CascoLogix/KiCAD_Libraries/Templates/README.txt

There are two image files that should be located in the 'meta' folder under the actual board template folder.  These images need to be named "brd.png" and "icon.png".  

They need to also be specific sizes:
brd.png should be 640x480 pixels
icon.png should be 64x64 pixels
