CascoLogix/KiCAD_Libraries/3D/ICs/VSON/CAD/README.txt

Place CAD source files here.  These would be design files from CAD programs such as FreeCAD, Solidworks, etc.
