CascoLogix/KiCAD_Libraries/3D/ICs/VSON/Wings3D/README.txt

Place Wings3D files here (Note: these are *.wings file extensions).
