CascoLogix/KiCAD_Libraries/Templates/XBee/meta/brd.png

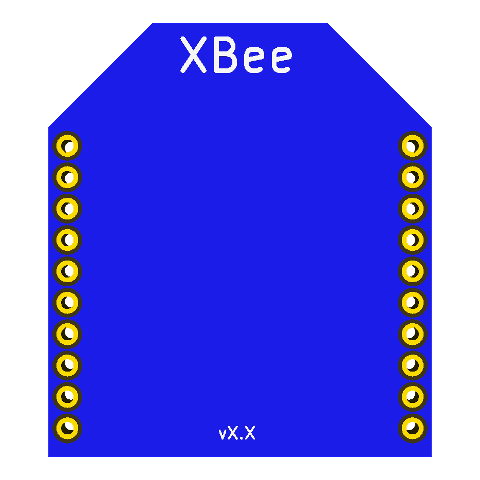
Templates/XBee/meta/brd.png
