CascoLogix/KiCAD_Libraries/Templates/XBee/XBee_Info/XBee_Standard_Pinout.PNG

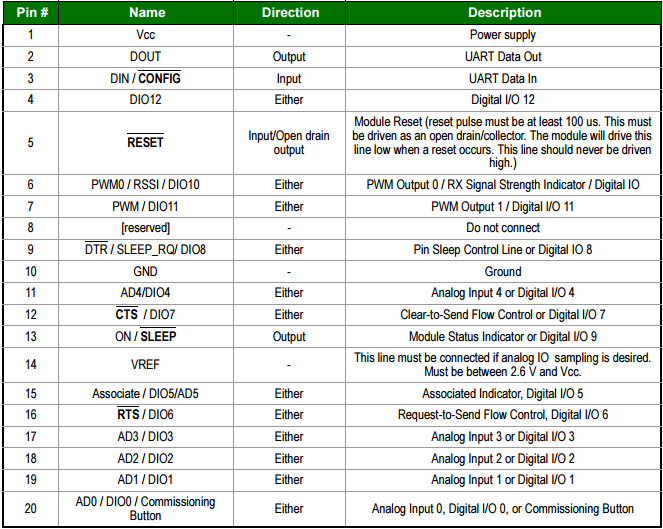
Templates/XBee/XBee_Info/XBee_Standard_Pinout.PNG
