CascoLogix/KiCAD_Libraries/Templates/XBee_Pro/meta/brd.png

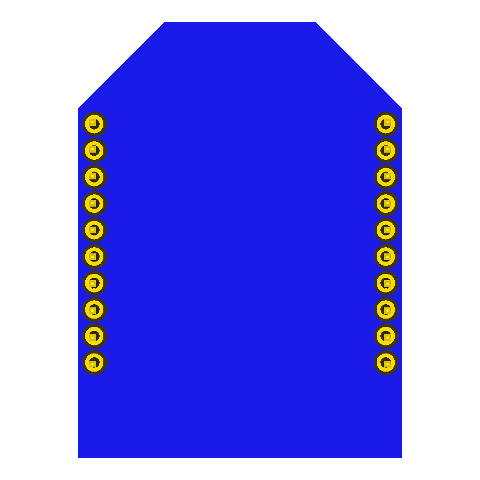
Templates/XBee_Pro/meta/brd.png
