CascoLogix/KiCAD_Libraries/PCB/Potentiometer_Library_Component_Names.xlsx

PCB Footprint Name | Component Prefix | Series Name | Mounting Type
POT_PV36P_PTH | POT | PV36P | PTH
POT_PV36W_PTH | POT | PV36W | PTH
POT_PV36X_PTH | POT | PV36X | PTH
POT_PV36Y_PTH | POT | PV36Y | PTH
POT_PV36Z_PTH | POT | PV36Z | PTH
POT_3296P_PTH | POT | 3296P | PTH
POT_3296W_PTH | POT | 3296W | PTH
POT_3296X_PTH | POT | 3296X | PTH
POT_3296Y_PTH | POT | 3296Y | PTH
POT_3296Z_PTH | POT | 3296Z | PTH
POT_3361P_SMT | POT | 3361P | SMT
POT_3361S_SMT | POT | 3361S | SMT
POT_3269P_SMT | POT | 3269P | SMT
POT_3269W_SMT | POT | 3269W | SMT
POT_3269X_SMT | POT | 3269X | SMT
