CascoLogix/KiCAD_Libraries/PCB/Resistor_Library_Component_Names.xlsx

PCB Footprint Name | Component Prefix | PTH Lead Spacing |  | Body Length |  | Body Diameter |  | Orientation | Mounting Type
RES_5.08MM_9MM_3MM_VERT_PTH | RES | 5.08 | MM | 9 | MM | 3 | MM | VERT | PTH | 1/2-Watt
RES_12.7MM_9MM_3MM_HORZ_PTH | RES | 12.7 | MM | 9 | MM | 3 | MM | HORZ | PTH | 1/2-Watt
RES_3.8MM_3.4MM_1.9MM_VERT_PTH | RES | 3.8 | MM | 3.4 | MM | 1.9 | MM | VERT | PTH | 1/4-Watt
RES_10.2MM_3.4MM_1.9MM_HORZ_PTH | RES | 10.2 | MM | 3.4 | MM | 1.9 | MM | HORZ | PTH | 1/4-Watt
RES_0201_SMT
RES_0402_SMT
RES_0603_SMT
RES_0805_SMT
RES_1206_SMT
RES_2512_SMT
