CascoLogix/KiCAD_Libraries/PCB/IC_Library_Component_Names.xlsx

Wings 3D Component Name | Package Type | Pin Count
QFN-12 | QFN | 12
QFN-16 | QFN | 16
QFN-20 | QFN | 20
QFN-24 | QFN | 24
QFN-28 | QFN | 28
QFN-32 | QFN | 32
QFN-44 | QFN | 44
QFN-48 | QFN | 48
TQFP-16 | TQFP | 16
TQFP-20 | TQFP | 20
TQFP-24 | TQFP | 24
TQFP-32 | TQFP | 32
TQFP-44 | TQFP | 44
TQFP-48 | TQFP | 48
TQFP-64 | TQFP | 64
TQFP-100 | TQFP | 100
TQFP-144 | TQFP | 144
DFN-6 | DFN | 6
DFN-8 | DFN | 8
SOIC-4 | SOIC | 4
SOIC-6 | SOIC | 6
SOIC-8 | SOIC | 8
SOIC-14 | SOIC | 14
SOIC-16 | SOIC | 16
SOIC-18 | SOIC | 18
SOIC-20 | SOIC | 20
SOIC-24 | SOIC | 24
SOIC-28 | SOIC | 28
DIP-6 | DIP | 6
DIP-8 | DIP | 8
DIP-4 | DIP | 4
DIP-6 | DIP | 6
DIP-8 | DIP | 8
DIP-14 | DIP | 14
DIP-16 | DIP | 16
DIP-18 | DIP | 18
DIP-20 | DIP | 20
DIP-24 | DIP | 24
DIP-28 | DIP | 28
SOT-23-3 | SOT-23 | 3
SOT-23-5 | SOT-23 | 5
SOT-23-6 | SOT-23 | 6
SOT-23-8 | SOT-23 | 8
SOIC-W-4 | SOIC-W | 4
SOIC-W-6 | SOIC-W | 6
SOIC-W-8 | SOIC-W | 8
SOIC-W-14 | SOIC-W | 14
SOIC-W-16 | SOIC-W | 16
SOIC-W-18 | SOIC-W | 18
SOIC-W-20 | SOIC-W | 20
SOIC-W-24 | SOIC-W | 24
SOIC-W-28 | SOIC-W | 28
DIP-W-4 | DIP-W | 4
DIP-W-6 | DIP-W | 6
DIP-W-8 | DIP-W | 8
DIP-W-14 | DIP-W | 14
DIP-W-16 | DIP-W | 16
DIP-W-18 | DIP-W | 18
DIP-W-20 | DIP-W | 20
DIP-W-24 | DIP-W | 24
DIP-W-28 | DIP-W | 28
SOP-8 | SOP | 8
SOP-14 | SOP | 14
SOP-16 | SOP | 16
SOP-18 | SOP | 18
SOP-20 | SOP | 20
SOP-24 | SOP | 24
SOP-28 | SOP | 28
SOP-32 | SOP | 32
SOP-40 | SOP | 40
SOP-44 | SOP | 44
SOP-48 | SOP | 48
SOP-64 | SOP | 64
MSOP-8 | MSOP | 8
MSOP-14 | MSOP | 14
MSOP-16 | MSOP | 16
MSOP-18 | MSOP | 18
MSOP-20 | MSOP | 20
MSOP-24 | MSOP | 24
MSOP-28 | MSOP | 28
MSOP-32 | MSOP | 32
TSSOP-8 | TSSOP | 8
TSSOP-14 | TSSOP | 14
TSSOP-16 | TSSOP | 16
TSSOP-18 | TSSOP | 18
TSSOP-20 | TSSOP | 20
TSSOP-24 | TSSOP | 24
TSSOP-28 | TSSOP | 28
TSSOP-32 | TSSOP | 32
TSSOP-40 | TSSOP | 40
TSSOP-44 | TSSOP | 44
TSSOP-48 | TSSOP | 48
TSSOP-64 | TSSOP | 64
