CascoLogix/KiCAD_Libraries/PCB/Header_Library_Component_Names.xlsx

PCB Footprint Name | Component Prefix | Gender | Pitch |  | Rows | Positions | Orientation | Plating | Mounting Type
HEADER_F_2.54MM_1R1P_ST_AU_SMT | HEADER | FEMALE | 2.54 | MM | 1 | 1 | ST | AU | SMT
HEADER_M_2.54MM_1R1P_ST_AU_SMT | HEADER | MALE | 2.54 | MM | 1 | 1 | ST | AU | SMT
HEADER_F_2.54MM_1R1P_ST_AU_PTH | HEADER | FEMALE | 2.54 | MM | 1 | 1 | ST | AU | PTH
HEADER_M_2.54MM_1R1P_ST_AU_PTH | HEADER | MALE | 2.54 | MM | 1 | 1 | ST | AU | PTH
HEADER_F_2.54MM_1R1P_RA_AU_SMT | HEADER | FEMALE | 2.54 | MM | 1 | 1 | RA | AU | SMT
HEADER_M_2.54MM_1R1P_RA_AU_SMT | HEADER | MALE | 2.54 | MM | 1 | 1 | RA | AU | SMT
HEADER_F_2.54MM_1R1P_RA_AU_PTH | HEADER | FEMALE | 2.54 | MM | 1 | 1 | RA | AU | PTH
HEADER_M_2.54MM_1R1P_RA_AU_PTH | HEADER | MALE | 2.54 | MM | 1 | 1 | RA | AU | PTH
HEADER_F_2.54MM_1R1P_ST_SN_SMT | HEADER | FEMALE | 2.54 | MM | 1 | 1 | ST | SN | SMT
HEADER_M_2.54MM_1R1P_ST_SN_SMT | HEADER | MALE | 2.54 | MM | 1 | 1 | ST | SN | SMT
HEADER_F_2.54MM_1R1P_ST_SN_PTH | HEADER | FEMALE | 2.54 | MM | 1 | 1 | ST | SN | PTH
HEADER_M_2.54MM_1R1P_ST_SN_PTH | HEADER | MALE | 2.54 | MM | 1 | 1 | ST | SN | PTH
HEADER_F_2.54MM_1R1P_RA_SN_SMT | HEADER | FEMALE | 2.54 | MM | 1 | 1 | RA | SN | SMT
HEADER_M_2.54MM_1R1P_RA_SN_SMT | HEADER | MALE | 2.54 | MM | 1 | 1 | RA | SN | SMT
HEADER_F_2.54MM_1R1P_RA_SN_PTH | HEADER | FEMALE | 2.54 | MM | 1 | 1 | RA | SN | PTH
HEADER_M_2.54MM_1R1P_RA_SN_PTH | HEADER | MALE | 2.54 | MM | 1 | 1 | RA | SN | PTH
HEADER_F_2.54MM_1R2P_ST_AU_SMT | HEADER | FEMALE | 2.54 | MM | 1 | 2 | ST | AU | SMT
HEADER_M_2.54MM_1R2P_ST_AU_SMT | HEADER | MALE | 2.54 | MM | 1 | 2 | ST | AU | SMT
HEADER_F_2.54MM_1R2P_ST_AU_PTH | HEADER | FEMALE | 2.54 | MM | 1 | 2 | ST | AU | PTH
HEADER_M_2.54MM_1R2P_ST_AU_PTH | HEADER | MALE | 2.54 | MM | 1 | 2 | ST | AU | PTH
HEADER_F_2.54MM_1R2P_RA_AU_SMT | HEADER | FEMALE | 2.54 | MM | 1 | 2 | RA | AU | SMT
HEADER_M_2.54MM_1R2P_RA_AU_SMT | HEADER | MALE | 2.54 | MM | 1 | 2 | RA | AU | SMT
HEADER_F_2.54MM_1R2P_RA_AU_PTH | HEADER | FEMALE | 2.54 | MM | 1 | 2 | RA | AU | PTH
HEADER_M_2.54MM_1R2P_RA_AU_PTH | HEADER | MALE | 2.54 | MM | 1 | 2 | RA | AU | PTH
HEADER_F_2.54MM_1R2P_ST_SN_SMT | HEADER | FEMALE | 2.54 | MM | 1 | 2 | ST | SN | SMT
HEADER_M_2.54MM_1R2P_ST_SN_SMT | HEADER | MALE | 2.54 | MM | 1 | 2 | ST | SN | SMT
HEADER_F_2.54MM_1R2P_ST_SN_PTH | HEADER | FEMALE | 2.54 | MM | 1 | 2 | ST | SN | PTH
HEADER_M_2.54MM_1R2P_ST_SN_PTH | HEADER | MALE | 2.54 | MM | 1 | 2 | ST | SN | PTH
HEADER_F_2.54MM_1R2P_RA_SN_SMT | HEADER | FEMALE | 2.54 | MM | 1 | 2 | RA | SN | SMT
HEADER_M_2.54MM_1R2P_RA_SN_SMT | HEADER | MALE | 2.54 | MM | 1 | 2 | RA | SN | SMT
HEADER_F_2.54MM_1R2P_RA_SN_PTH | HEADER | FEMALE | 2.54 | MM | 1 | 2 | RA | SN | PTH
HEADER_M_2.54MM_1R2P_RA_SN_PTH | HEADER | MALE | 2.54 | MM | 1 | 2 | RA | SN | PTH
HEADER_F_2.54MM_1R3P_ST_AU_SMT | HEADER | FEMALE | 2.54 | MM | 1 | 3 | ST | AU | SMT
HEADER_M_2.54MM_1R3P_ST_AU_SMT | HEADER | MALE | 2.54 | MM | 1 | 3 | ST | AU | SMT
HEADER_F_2.54MM_1R3P_ST_AU_PTH | HEADER | FEMALE | 2.54 | MM | 1 | 3 | ST | AU | PTH
HEADER_M_2.54MM_1R3P_ST_AU_PTH | HEADER | MALE | 2.54 | MM | 1 | 3 | ST | AU | PTH
HEADER_F_2.54MM_1R3P_RA_AU_SMT | HEADER | FEMALE | 2.54 | MM | 1 | 3 | RA | AU | SMT
HEADER_M_2.54MM_1R3P_RA_AU_SMT | HEADER | MALE | 2.54 | MM | 1 | 3 | RA | AU | SMT
HEADER_F_2.54MM_1R3P_RA_AU_PTH | HEADER | FEMALE | 2.54 | MM | 1 | 3 | RA | AU | PTH
HEADER_M_2.54MM_1R3P_RA_AU_PTH | HEADER | MALE | 2.54 | MM | 1 | 3 | RA | AU | PTH
HEADER_F_2.54MM_1R3P_ST_SN_SMT | HEADER | FEMALE | 2.54 | MM | 1 | 3 | ST | SN | SMT
HEADER_M_2.54MM_1R3P_ST_SN_SMT | HEADER | MALE | 2.54 | MM | 1 | 3 | ST | SN | SMT
HEADER_F_2.54MM_1R3P_ST_SN_PTH | HEADER | FEMALE | 2.54 | MM | 1 | 3 | ST | SN | PTH
HEADER_M_2.54MM_1R3P_ST_SN_PTH | HEADER | MALE | 2.54 | MM | 1 | 3 | ST | SN | PTH
HEADER_F_2.54MM_1R3P_RA_SN_SMT | HEADER | FEMALE | 2.54 | MM | 1 | 3 | RA | SN | SMT
HEADER_M_2.54MM_1R3P_RA_SN_SMT | HEADER | MALE | 2.54 | MM | 1 | 3 | RA | SN | SMT
HEADER_F_2.54MM_1R3P_RA_SN_PTH | HEADER | FEMALE | 2.54 | MM | 1 | 3 | RA | SN | PTH
HEADER_M_2.54MM_1R3P_RA_SN_PTH | HEADER | MALE | 2.54 | MM | 1 | 3 | RA | SN | PTH
HEADER_F_2.54MM_1R4P_ST_AU_SMT | HEADER | FEMALE | 2.54 | MM | 1 | 4 | ST | AU | SMT
HEADER_M_2.54MM_1R4P_ST_AU_SMT | HEADER | MALE | 2.54 | MM | 1 | 4 | ST | AU | SMT
HEADER_F_2.54MM_1R4P_ST_AU_PTH | HEADER | FEMALE | 2.54 | MM | 1 | 4 | ST | AU | PTH
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
HEADER_F_2.54MM_2R72P_RA_AU_PTH | HEADER | FEMALE | 2.54 | MM | 2 | 72 | RA | AU | PTH
HEADER_M_2.54MM_2R72P_RA_AU_PTH | HEADER | MALE | 2.54 | MM | 2 | 72 | RA | AU | PTH
HEADER_F_2.54MM_2R72P_ST_SN_SMT | HEADER | FEMALE | 2.54 | MM | 2 | 72 | ST | SN | SMT
HEADER_M_2.54MM_2R72P_ST_SN_SMT | HEADER | MALE | 2.54 | MM | 2 | 72 | ST | SN | SMT
HEADER_F_2.54MM_2R72P_ST_SN_PTH | HEADER | FEMALE | 2.54 | MM | 2 | 72 | ST | SN | PTH
HEADER_M_2.54MM_2R72P_ST_SN_PTH | HEADER | MALE | 2.54 | MM | 2 | 72 | ST | SN | PTH
HEADER_F_2.54MM_2R72P_RA_SN_SMT | HEADER | FEMALE | 2.54 | MM | 2 | 72 | RA | SN | SMT
HEADER_M_2.54MM_2R72P_RA_SN_SMT | HEADER | MALE | 2.54 | MM | 2 | 72 | RA | SN | SMT
HEADER_F_2.54MM_2R72P_RA_SN_PTH | HEADER | FEMALE | 2.54 | MM | 2 | 72 | RA | SN | PTH
HEADER_M_2.54MM_2R72P_RA_SN_PTH | HEADER | MALE | 2.54 | MM | 2 | 72 | RA | SN | PTH
