CascoLogix/KiCAD_Libraries/3D/Wings_3D_Library_Info.ods

Sheet: Library Names
Battery
Connector
Discrete
Display
Fuse
Header
IC
Potentiometer
Switch
Terminal Block
Test

Sheet: Discrete - Capacitor
Wings 3D Component Name | Component Type |  |  | Orientation | Formed Leads | Body Dia |  | Body Length |  | Lead Spacing |  | Lead Dia
0402
0603
0805
1206
CAP_E_AXI_200_500_400_20 | CAP | E | Electrolytic | AXIAL |  | 200 | MIL | 500 | MIL | 400 | MIL | 20 | MIL
CAP_T_RAD_200_500_200_20 | CAP | T | Tantalum | RADIAL |  | 200 | MIL | 500 | MIL | 200 | MIL | 20 | MIL
CAP_F_AXI_F_200_500_200_20 | CAP | F | Formica | AXIAL | FORMED | 200 | MIL | 500 | MIL | 200 | MIL | 20 | MIL
CAP_C_RAD_F_200_500_200_20 | CAP | C | Ceramic | RADIAL | FORMED | 200 | MIL | 500 | MIL | 200 | MIL | 20 | MIL
CAP_P_RAD_200_500_200_20 | CAP | P | Polyester | RADIAL |  | 200 | MIL | 500 | MIL | 200 | MIL | 20 | MIL

Sheet: Discrete - Resistor
Wings 3D Component Name | Component Type |  |  | Orientation | Formed Leads | Body Dia |  | Body Height |  | Lead Spacing |  | Lead Dia
0402
0603
0805
1206
RES_CC_AXI_200_500_400_20 | RES | CC | Carbon Composition | AXIAL |  | 200 | MIL | 500 | MIL | 400 | MIL | 20 | MIL
RES_MF_RAD_200_500_200_20 | RES | MF | Metal Film | RADIAL |  | 200 | MIL | 500 | MIL | 200 | MIL | 20 | MIL
RES_FL_AXI_F_200_500_200_20 | RES | FL | Foil | AXIAL | FORMED | 200 | MIL | 500 | MIL | 200 | MIL | 20 | MIL
RES_CF_RAD_F_200_500_200_20 | RES | CF | Carbon Film | RADIAL | FORMED | 200 | MIL | 500 | MIL | 200 | MIL | 20 | MIL
RES_WW_RAD_200_500_200_20 | RES | WW | Wirewound | RADIAL |  | 200 | MIL | 500 | MIL | 200 | MIL | 20 | MIL

Sheet: Discrete - Diode
Wings 3D Component Name | Component Type |  |  | Orientation | Formed Leads | Body Dia |  | Body Length |  | Lead Spacing |  | Lead Dia
 | DIODE | SMA
 | DIODE | SMB
 | DIODE | SMC
 | DIODE | MELF
DIODE_ZEN_AXI_200_500_400_20 | DIODE | ZEN | Zener | AXIAL |  | 200 | MIL | 500 | MIL | 400 | MIL | 20 | MIL
DIODE_UFS_AXI_200_500_200_20 | DIODE | UFS | Ultra Fast Recovery | AXIAL |  | 200 | MIL | 500 | MIL | 200 | MIL | 20 | MIL
DIODE_GAS_AXI_F_200_500_200_20 | DIODE | GAS | Gallium Arsenide | AXIAL | FORMED | 200 | MIL | 500 | MIL | 200 | MIL | 20 | MIL
DIODE_STD_AXI_F_200_500_200_20 | DIODE | STD | Standard Recovery | AXIAL | FORMED | 200 | MIL | 500 | MIL | 200 | MIL | 20 | MIL

Sheet: Header
Wings 3D Component Name | Component Type | Gender | Pitch |  | Rows | Positions | Mounting Type
HEADER_F_100MIL_1R01P_SMT | HEADER | FEMALE | 100 | MIL | 1 | 01 | SMT
HEADER_F_100MIL_1R02P_SMT | HEADER | FEMALE | 100 | MIL | 1 | 02 | SMT
HEADER_F_100MIL_1R03P_SMT | HEADER | FEMALE | 100 | MIL | 1 | 03 | SMT
HEADER_F_100MIL_1R04P_SMT | HEADER | FEMALE | 100 | MIL | 1 | 04 | SMT
HEADER_F_100MIL_1R05P_SMT | HEADER | FEMALE | 100 | MIL | 1 | 05 | SMT
HEADER_F_100MIL_1R06P_SMT | HEADER | FEMALE | 100 | MIL | 1 | 06 | SMT
HEADER_F_100MIL_1R07P_SMT | HEADER | FEMALE | 100 | MIL | 1 | 07 | SMT
HEADER_F_100MIL_1R08P_SMT | HEADER | FEMALE | 100 | MIL | 1 | 08 | SMT
HEADER_F_100MIL_1R09P_SMT | HEADER | FEMALE | 100 | MIL | 1 | 09 | SMT
HEADER_F_100MIL_1R10P_SMT | HEADER | FEMALE | 100 | MIL | 1 | 10 | SMT
HEADER_F_100MIL_1R11P_SMT | HEADER | FEMALE | 100 | MIL | 1 | 11 | SMT
HEADER_F_100MIL_1R12P_SMT | HEADER | FEMALE | 100 | MIL | 1 | 12 | SMT
HEADER_F_100MIL_1R13P_SMT | HEADER | FEMALE | 100 | MIL | 1 | 13 | SMT
HEADER_F_100MIL_1R14P_SMT | HEADER | FEMALE | 100 | MIL | 1 | 14 | SMT
HEADER_F_100MIL_1R15P_SMT | HEADER | FEMALE | 100 | MIL | 1 | 15 | SMT
HEADER_F_100MIL_1R16P_SMT | HEADER | FEMALE | 100 | MIL | 1 | 16 | SMT
HEADER_F_100MIL_1R17P_SMT | HEADER | FEMALE | 100 | MIL | 1 | 17 | SMT
HEADER_F_100MIL_1R18P_SMT | HEADER | FEMALE | 100 | MIL | 1 | 18 | SMT
HEADER_F_100MIL_1R19P_SMT | HEADER | FEMALE | 100 | MIL | 1 | 19 | SMT
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
HEADER_M_100MIL_2R24P_PTH | HEADER | MALE | 100 | MIL | 2 | 24 | PTH
HEADER_M_100MIL_2R25P_PTH | HEADER | MALE | 100 | MIL | 2 | 25 | PTH
HEADER_M_100MIL_2R26P_PTH | HEADER | MALE | 100 | MIL | 2 | 26 | PTH
HEADER_M_100MIL_2R27P_PTH | HEADER | MALE | 100 | MIL | 2 | 27 | PTH
HEADER_M_100MIL_2R28P_PTH | HEADER | MALE | 100 | MIL | 2 | 28 | PTH
HEADER_M_100MIL_2R29P_PTH | HEADER | MALE | 100 | MIL | 2 | 29 | PTH
HEADER_M_100MIL_2R30P_PTH | HEADER | MALE | 100 | MIL | 2 | 30 | PTH
HEADER_M_100MIL_2R31P_PTH | HEADER | MALE | 100 | MIL | 2 | 31 | PTH
HEADER_M_100MIL_2R32P_PTH | HEADER | MALE | 100 | MIL | 2 | 32 | PTH
HEADER_M_100MIL_2R33P_PTH | HEADER | MALE | 100 | MIL | 2 | 33 | PTH
HEADER_M_100MIL_2R34P_PTH | HEADER | MALE | 100 | MIL | 2 | 34 | PTH
HEADER_M_100MIL_2R35P_PTH | HEADER | MALE | 100 | MIL | 2 | 35 | PTH
HEADER_M_100MIL_2R36P_PTH | HEADER | MALE | 100 | MIL | 2 | 36 | PTH
HEADER_M_100MIL_2R37P_PTH | HEADER | MALE | 100 | MIL | 2 | 37 | PTH
HEADER_M_100MIL_2R38P_PTH | HEADER | MALE | 100 | MIL | 2 | 38 | PTH
HEADER_M_100MIL_2R39P_PTH | HEADER | MALE | 100 | MIL | 2 | 39 | PTH
HEADER_M_100MIL_2R40P_PTH | HEADER | MALE | 100 | MIL | 2 | 40 | PTH
HEADER_M_100MIL_2R41P_PTH | HEADER | MALE | 100 | MIL | 2 | 41 | PTH
HEADER_M_100MIL_2R42P_PTH | HEADER | MALE | 100 | MIL | 2 | 42 | PTH
HEADER_M_100MIL_2R43P_PTH | HEADER | MALE | 100 | MIL | 2 | 43 | PTH
HEADER_M_100MIL_2R44P_PTH | HEADER | MALE | 100 | MIL | 2 | 44 | PTH
HEADER_M_100MIL_2R45P_PTH | HEADER | MALE | 100 | MIL | 2 | 45 | PTH
HEADER_M_100MIL_2R46P_PTH | HEADER | MALE | 100 | MIL | 2 | 46 | PTH
HEADER_M_100MIL_2R47P_PTH | HEADER | MALE | 100 | MIL | 2 | 47 | PTH
HEADER_M_100MIL_2R48P_PTH | HEADER | MALE | 100 | MIL | 2 | 48 | PTH
HEADER_M_100MIL_2R49P_PTH | HEADER | MALE | 100 | MIL | 2 | 49 | PTH
HEADER_M_100MIL_2R50P_PTH | HEADER | MALE | 100 | MIL | 2 | 50 | PTH

Sheet: IC
Wings 3D Component Name | Package Type | Pin Count
QFN-12 | QFN | 12
QFN-16 | QFN | 16
QFN-20 | QFN | 20
QFN-24 | QFN | 24
QFN-28 | QFN | 28
QFN-32 | QFN | 32
QFN-44 | QFN | 44
QFN-48 | QFN | 48
TQFP-16 | TQFP | 16
TQFP-20 | TQFP | 20
TQFP-24 | TQFP | 24
TQFP-32 | TQFP | 32
TQFP-44 | TQFP | 44
TQFP-48 | TQFP | 48
TQFP-64 | TQFP | 64
TQFP-100 | TQFP | 100
TQFP-144 | TQFP | 144
DFN-6 | DFN | 6
DFN-8 | DFN | 8
SOIC-4 | SOIC | 4
SOIC-6 | SOIC | 6
SOIC-8 | SOIC | 8
SOIC-14 | SOIC | 14
SOIC-16 | SOIC | 16
SOIC-18 | SOIC | 18
SOIC-20 | SOIC | 20
SOIC-24 | SOIC | 24
SOIC-28 | SOIC | 28
DIP-6 | DIP | 6
DIP-8 | DIP | 8
DIP-4 | DIP | 4
DIP-6 | DIP | 6
DIP-8 | DIP | 8
DIP-14 | DIP | 14
DIP-16 | DIP | 16
DIP-18 | DIP | 18
DIP-20 | DIP | 20
DIP-24 | DIP | 24
DIP-28 | DIP | 28
SOT-23-3 | SOT-23 | 3
SOT-23-5 | SOT-23 | 5
SOT-23-6 | SOT-23 | 6
SOT-23-8 | SOT-23 | 8
SOIC-W-4 | SOIC-W | 4
SOIC-W-6 | SOIC-W | 6
SOIC-W-8 | SOIC-W | 8
SOIC-W-14 | SOIC-W | 14
SOIC-W-16 | SOIC-W | 16
SOIC-W-18 | SOIC-W | 18
SOIC-W-20 | SOIC-W | 20
SOIC-W-24 | SOIC-W | 24
SOIC-W-28 | SOIC-W | 28
DIP-W-4 | DIP-W | 4
DIP-W-6 | DIP-W | 6
DIP-W-8 | DIP-W | 8
DIP-W-14 | DIP-W | 14
DIP-W-16 | DIP-W | 16
DIP-W-18 | DIP-W | 18
DIP-W-20 | DIP-W | 20
DIP-W-24 | DIP-W | 24
DIP-W-28 | DIP-W | 28
SOP-8 | SOP | 8
SOP-14 | SOP | 14
SOP-16 | SOP | 16
SOP-18 | SOP | 18
SOP-20 | SOP | 20
SOP-24 | SOP | 24
SOP-28 | SOP | 28
SOP-32 | SOP | 32
SOP-40 | SOP | 40
SOP-44 | SOP | 44
SOP-48 | SOP | 48
SOP-64 | SOP | 64
MSOP-8 | MSOP | 8
MSOP-14 | MSOP | 14
MSOP-16 | MSOP | 16
MSOP-18 | MSOP | 18
MSOP-20 | MSOP | 20
MSOP-24 | MSOP | 24
MSOP-28 | MSOP | 28
MSOP-32 | MSOP | 32
TSSOP-8 | TSSOP | 8
TSSOP-14 | TSSOP | 14
TSSOP-16 | TSSOP | 16
TSSOP-18 | TSSOP | 18
TSSOP-20 | TSSOP | 20
TSSOP-24 | TSSOP | 24
TSSOP-28 | TSSOP | 28
TSSOP-32 | TSSOP | 32
TSSOP-40 | TSSOP | 40
TSSOP-44 | TSSOP | 44
TSSOP-48 | TSSOP | 48
TSSOP-64 | TSSOP | 64

Sheet: Switch
SW_ROCKER_ON-OFF-ON
SW_SLIDE_4POS
SW_TOGGLE_4P2T_ON-OFF-ON
SW_TOGGLE_1P1T_ON-OFF
SW_TOGGLE_2P2T_ON-ON
SW_TOGGLE_4P2T_ON-MOM
SW_PUSH_1P1T_OFF-MOM
SW_PUSH_1P1T_OFF-ON
