CascoLogix/KiCAD_Libraries/3D/Battery_Holders/CAD/BHC-2-Assy-wCell.SLDASM

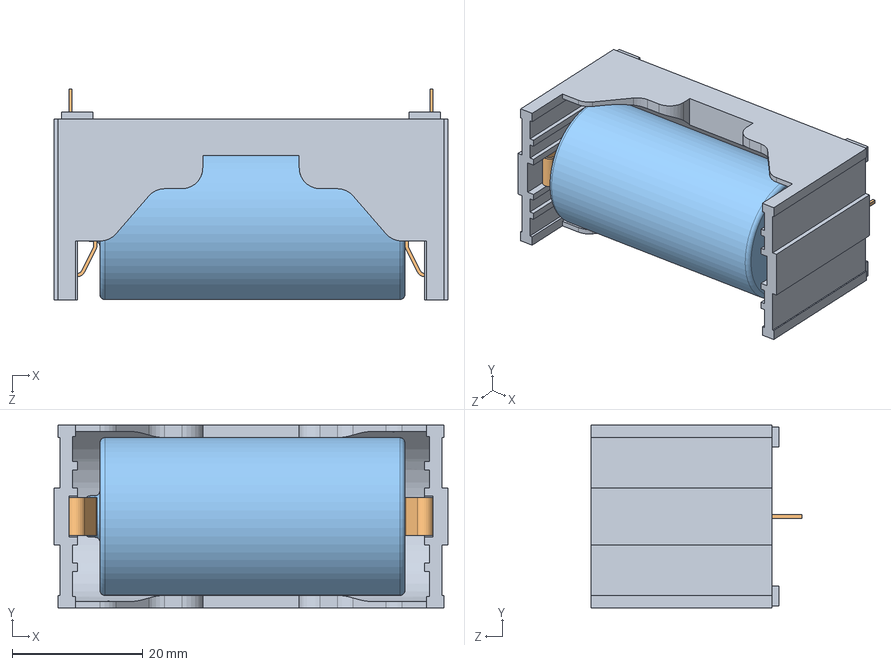
[picture p9: CAD file, 2016-09-24]
3D/Battery_Holders/CAD/BHC-2-Assy-wCell.SLDASM
60.2 x 27.9 x 32.3 mm
BHC-2-Base
BHC-2-Tab x 2
BHC-2-Cell
