CascoLogix/KiCAD_Libraries/3D/Connectors/Samtec/ERCD/CAD/ERCD-010-TED-S-2.SLDASM

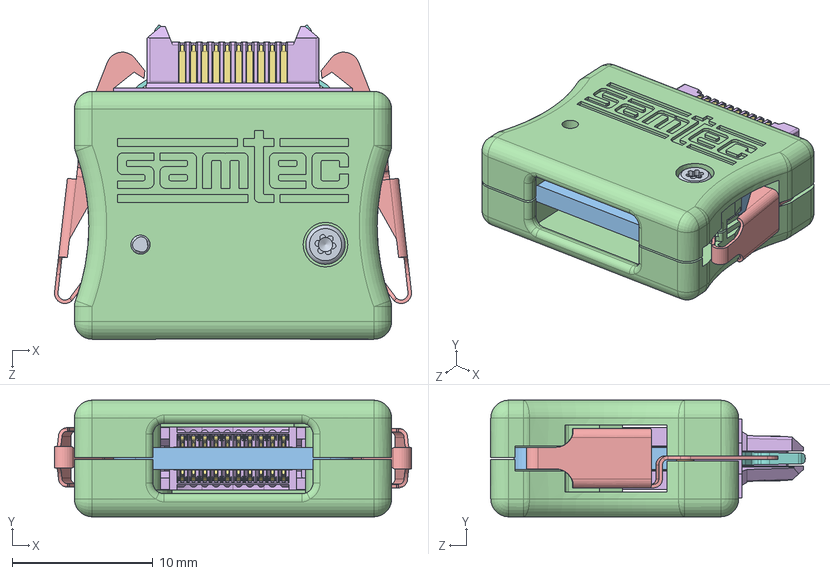
[picture p13: CAD file, 2013-10-21]
3D/Connectors/Samtec/ERCD/CAD/ERCD-010-TED-S-2.SLDASM
25.3 x 8.29 x 22.3 mm
STS-04 x 2
ERCD Dowel Pin x 2
ERCD PCB-EM_10 POS
ECD-XX-03_-10 x 2
LTC-16-01_DEFAULT x 2
ERCD ERM8-XXX-D-EMX-XX_20 position w_LATCHING
ERCD T-1M47-XX-X_.062 PCB x 20
WT-29-XX-X_-07 1.58 bd Smooth Latch x 2
