CascoLogix/KiCAD_Libraries/3D/Connectors/Samtec/ERCD/CAD/ERCD-010-TEU-S-1-R.SLDASM

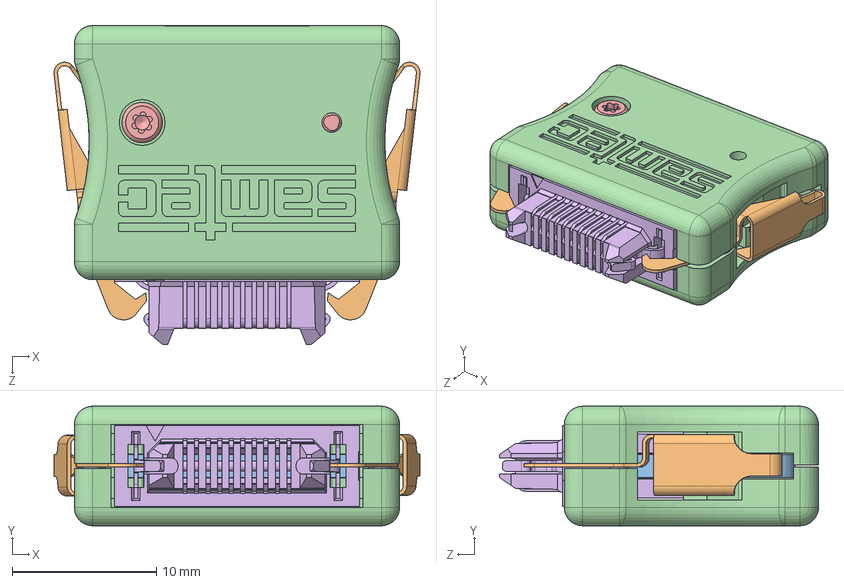
[picture p16: CAD file, 2013-10-21]
3D/Connectors/Samtec/ERCD/CAD/ERCD-010-TEU-S-1-R.SLDASM
25.3 x 8.29 x 22.1 mm
ERCD Dowel Pin_2 x 2
LTC-16-01_DEFAULT_2 x 2
ERCD PCB-EM_10 POS_2
ECD-XX-03_-10_2 x 2
STS-04_2 x 2
ERM8-EM_2
