CascoLogix/KiCAD_Libraries/3D/ICs/SOT/CAD/SOT-23-6-1.sldasm

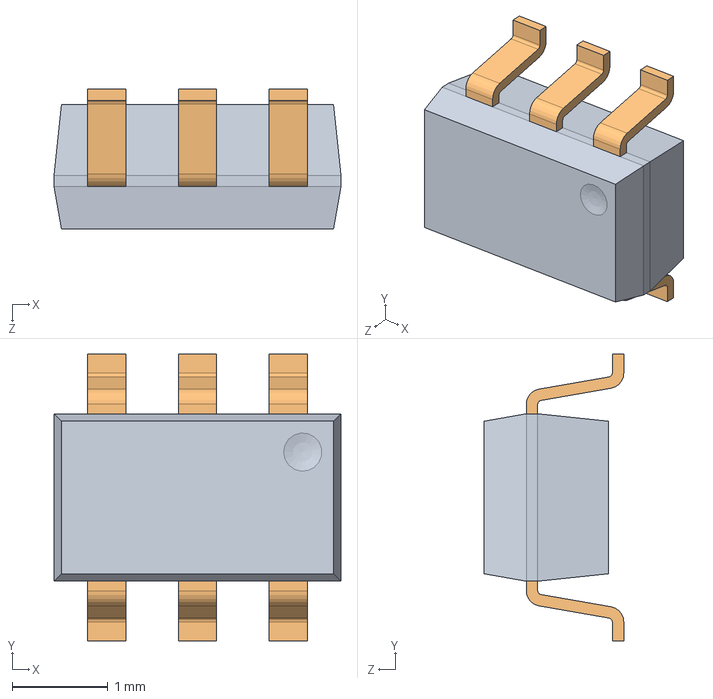
[picture p19: CAD file, 2014-12-09]
3D/ICs/SOT/CAD/SOT-23-6-1.sldasm
3.00 x 3.00 x 1.46 mm
User Library-SOT-23-6-1_body_sot23-6_1
User Library-SOT-23-6-1_pin_SOT_sot-23-6_1 x 6
