CascoLogix/KiCAD_Libraries/3D/ICs/SOT/CAD/SOT-23-1.sldasm

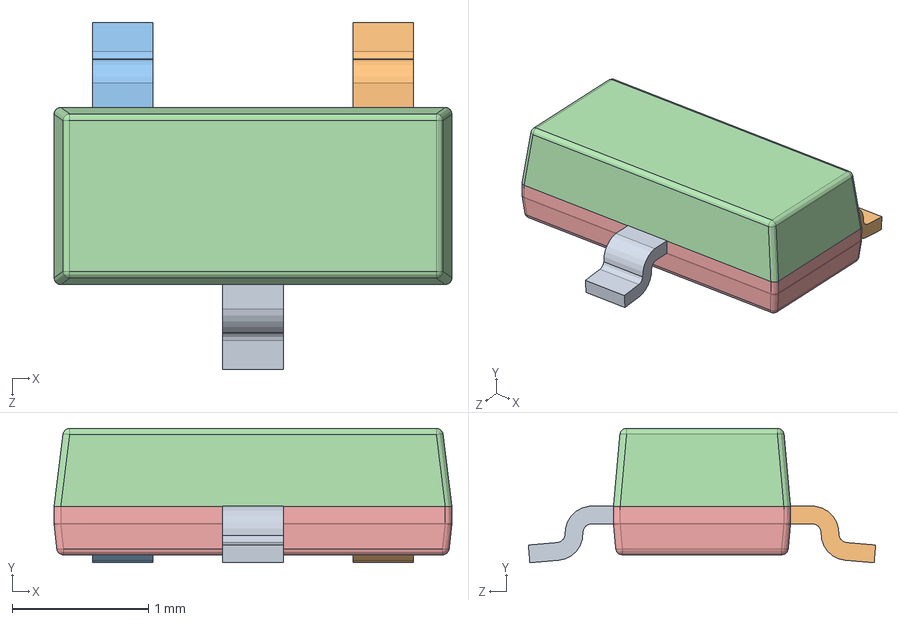
[picture p21: CAD file, 2013-10-21]
3D/ICs/SOT/CAD/SOT-23-1.sldasm
2.92 x 0.987 x 2.55 mm
User Library-SOT-23-1_1_1
User Library-SOT-23-1_2_1
User Library-SOT-23-1_3_1
User Library-SOT-23-1_4_1
User Library-SOT-23-1_5_1
