CascoLogix/KiCAD_Libraries/3D/Headers/CAD/HEADER_MALE_100MIL_1R7P_GOLD_PTH.SLDASM

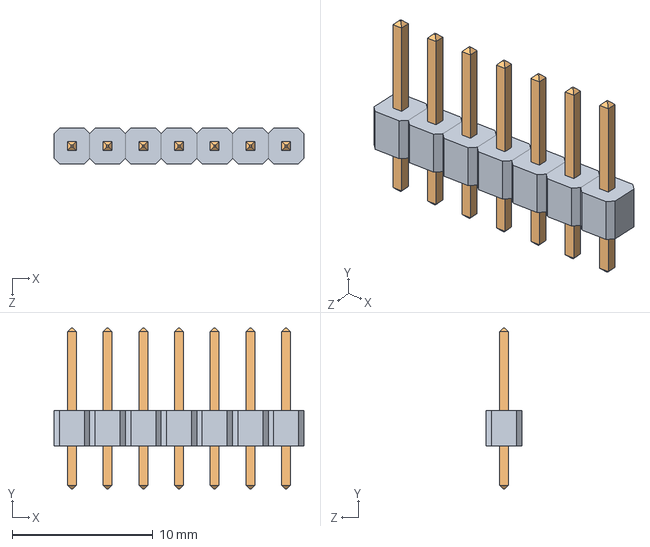
[picture p22: CAD file, 2013-10-21]
3D/Headers/CAD/HEADER_MALE_100MIL_1R7P_GOLD_PTH.SLDASM
17.8 x 11.4 x 2.54 mm
HEADER_MALE_100MIL_BODY_BLACK x 7
PIN_0.025SQ_0.230HEAD_0.120TAIL_GOLD x 7
