CascoLogix/KiCAD_Libraries/3D/Headers/CAD/HEADER_MALE_100MIL_1R2P_GOLD_PTH.SLDASM

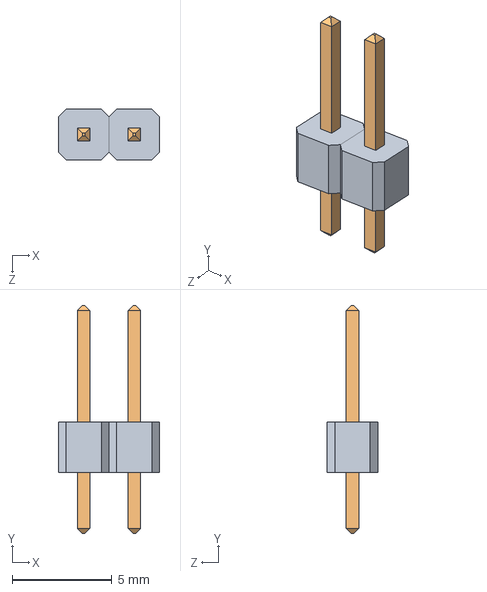
[picture p28: CAD file, 2013-10-21]
3D/Headers/CAD/HEADER_MALE_100MIL_1R2P_GOLD_PTH.SLDASM
5.08 x 11.4 x 2.54 mm
HEADER_MALE_100MIL_BODY_BLACK x 2
PIN_0.025SQ_0.230HEAD_0.120TAIL_GOLD x 2
