CascoLogix/KiCAD_Libraries/3D/Headers/CAD/HEADER_MALE_100MIL_2R6P_GOLD_PTH.SLDASM

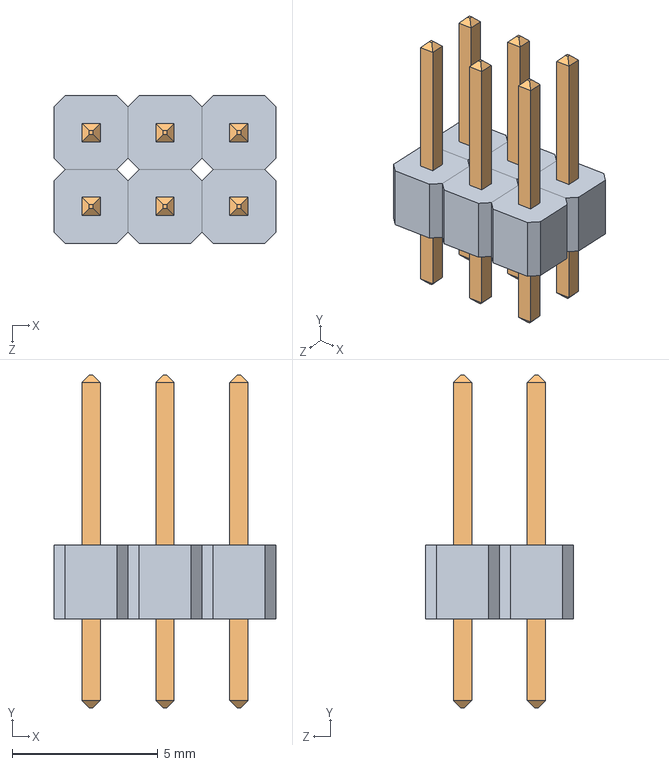
[picture p31: CAD file, 2013-10-21]
3D/Headers/CAD/HEADER_MALE_100MIL_2R6P_GOLD_PTH.SLDASM
7.62 x 11.4 x 5.08 mm
HEADER_MALE_100MIL_BODY_BLACK x 6
PIN_0.025SQ_0.230HEAD_0.120TAIL_GOLD x 6
