CascoLogix/KiCAD_Libraries/3D/Headers/CAD/HEADER_MALE_100MIL_2R8P_GOLD_PTH.SLDASM

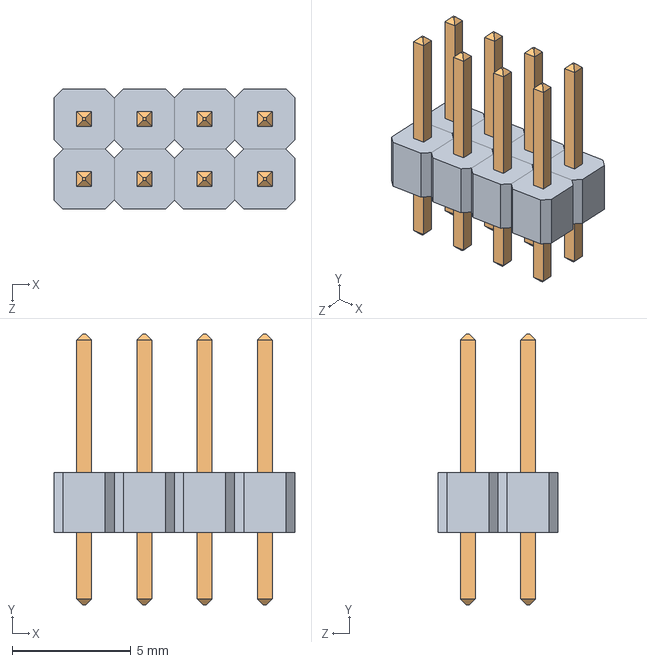
[picture p32: CAD file, 2013-10-21]
3D/Headers/CAD/HEADER_MALE_100MIL_2R8P_GOLD_PTH.SLDASM
10.2 x 11.4 x 5.08 mm
HEADER_MALE_100MIL_BODY_BLACK x 8
PIN_0.025SQ_0.230HEAD_0.120TAIL_GOLD x 8
