CascoLogix/KiCAD_Libraries/3D/Other_Mechanical/STEP/M12_Lens_Assy_2.step

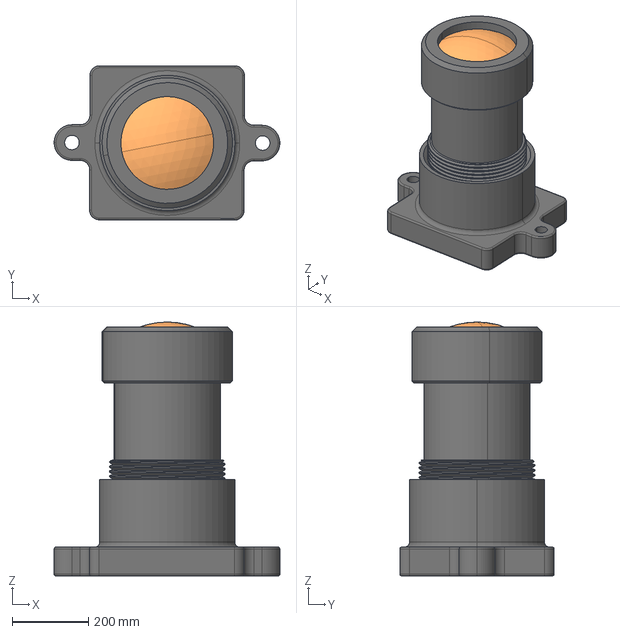
[picture p33: CAD file, 2018-07-14]
3D/Other_Mechanical/STEP/M12_Lens_Assy_2.step
593.7 x 406.2 x 668.0 mm
