CascoLogix/KiCAD_Libraries/3D/Batteries/CAD/CR1025 3V Cell.step

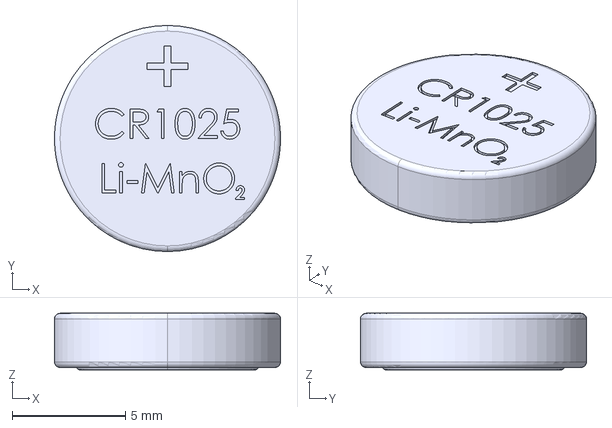
[picture p34: CAD file, 2020-03-22]
3D/Batteries/CAD/CR1025 3V Cell.step
10.00 x 10.0 x 2.50 mm
