CascoLogix/KiCAD_Libraries/3D/Battery_Holders/CAD/BHC-2-Tab.SLDPRT

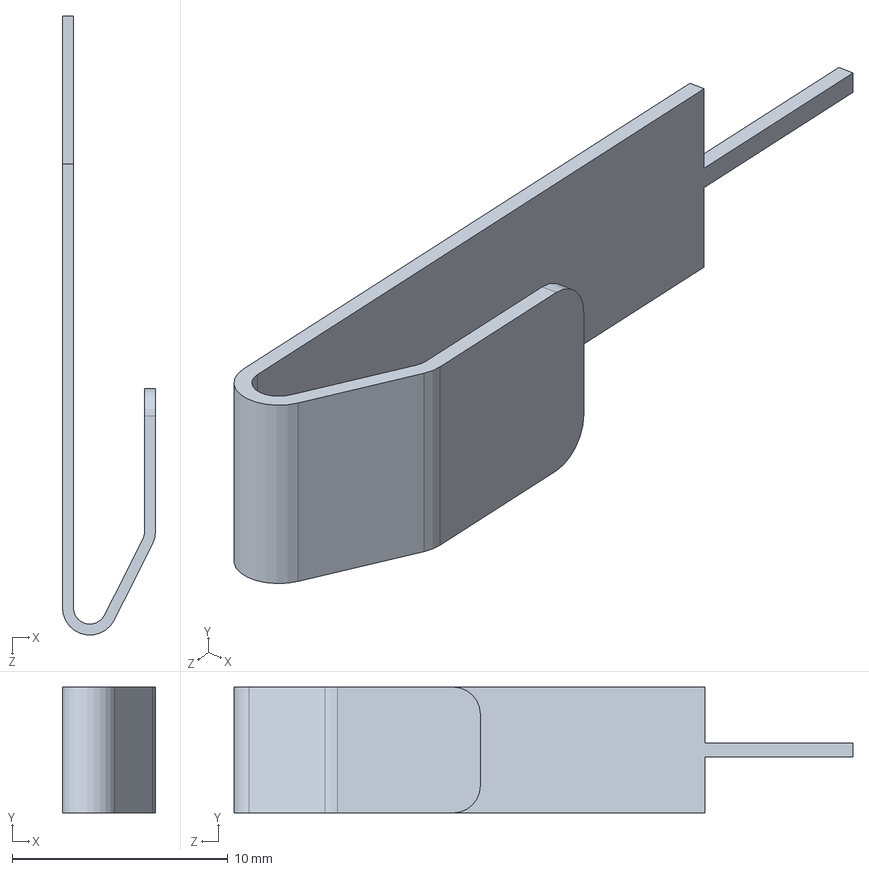
[picture p35: CAD file, 2016-09-24]
3D/Battery_Holders/CAD/BHC-2-Tab.SLDPRT
4.32 x 5.84 x 28.7 mm
