CascoLogix/KiCAD_Libraries/3D/Battery_Holders/STEP/keystone-PN3030.step

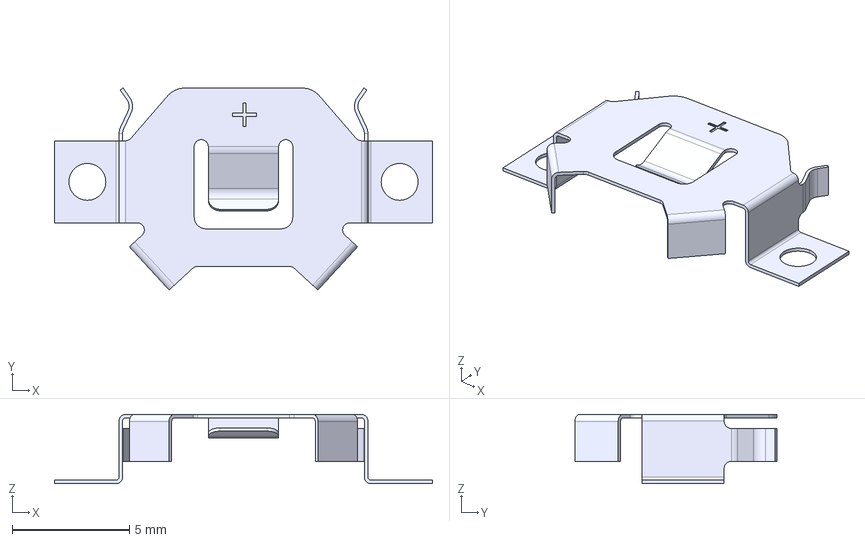
[picture p36: CAD file, 2020-03-16]
3D/Battery_Holders/STEP/keystone-PN3030.step
16.1 x 8.61 x 2.95 mm
