CascoLogix/KiCAD_Libraries/3D/Battery_Holders/STL/9V Duracell Battery.STL

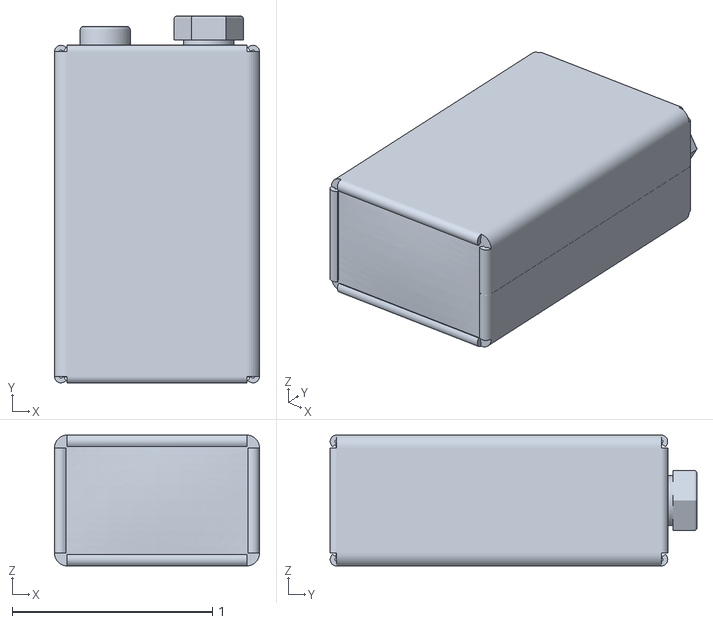
[picture p37: CAD file, 2016-01-23]
3D/Battery_Holders/STL/9V Duracell Battery.STL
1.02 x 1.83 x 0.654
