CascoLogix/KiCAD_Libraries/3D/Connectors/AVX/STEP/AVX_009155005003016.step

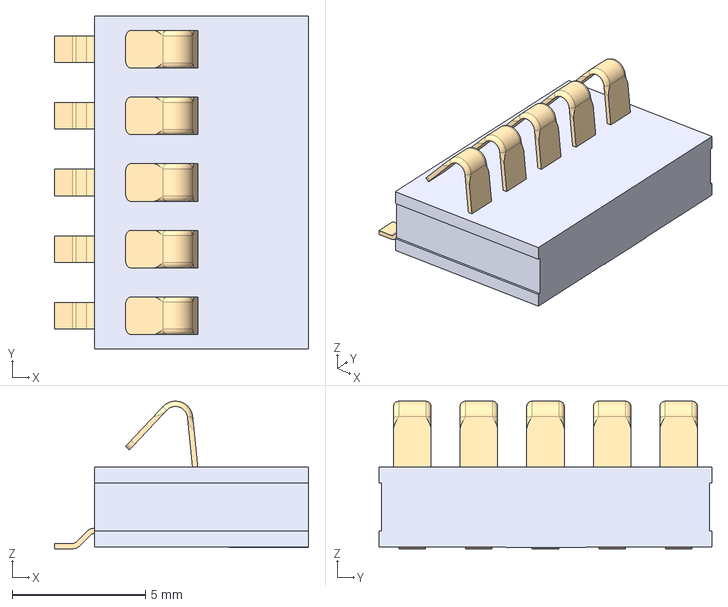
[picture p38: CAD file, 2018-05-26]
3D/Connectors/AVX/STEP/AVX_009155005003016.step
9.55 x 12.5 x 5.54 mm
