CascoLogix/KiCAD_Libraries/3D/Connectors/DB/CAD/CONNECTOR_DB9_RA_F_PTH_GENERIC.SLDPRT

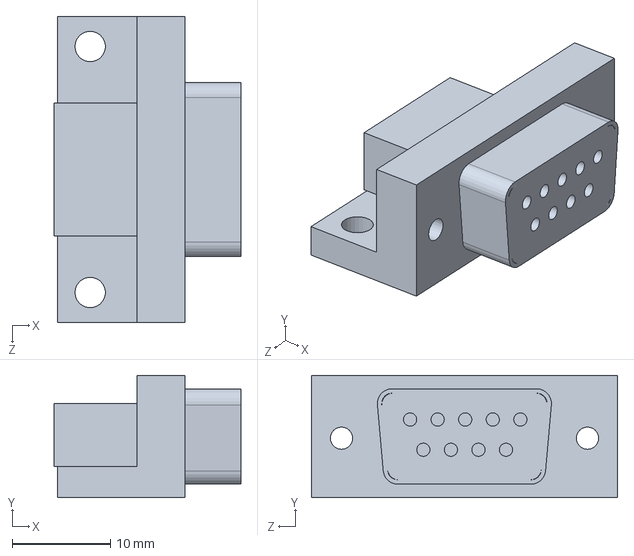
[picture p39: CAD file, 2013-10-21]
3D/Connectors/DB/CAD/CONNECTOR_DB9_RA_F_PTH_GENERIC.SLDPRT
19.0 x 12.4 x 31.1 mm
