CascoLogix/KiCAD_Libraries/3D/Connectors/DB/STL/CONNECTOR_DB9_RA_F_PTH_GENERIC2.STL

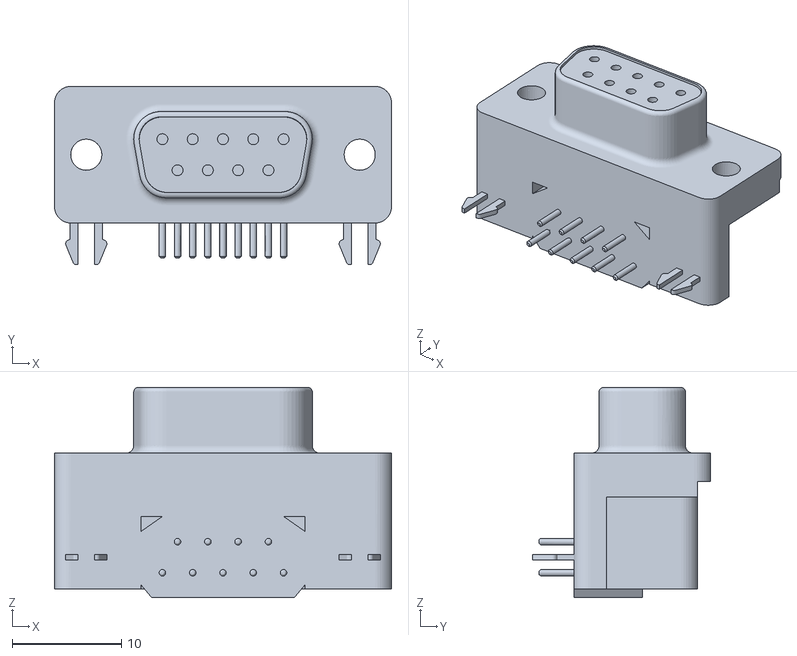
[picture p40: CAD file, 2013-10-21]
3D/Connectors/DB/STL/CONNECTOR_DB9_RA_F_PTH_GENERIC2.STL
30.8 x 16.3 x 19.2
