CascoLogix/KiCAD_Libraries/3D/Connectors/FFC/STEP/Molex_526100571_1R5P_1.0MM_VERT.stp

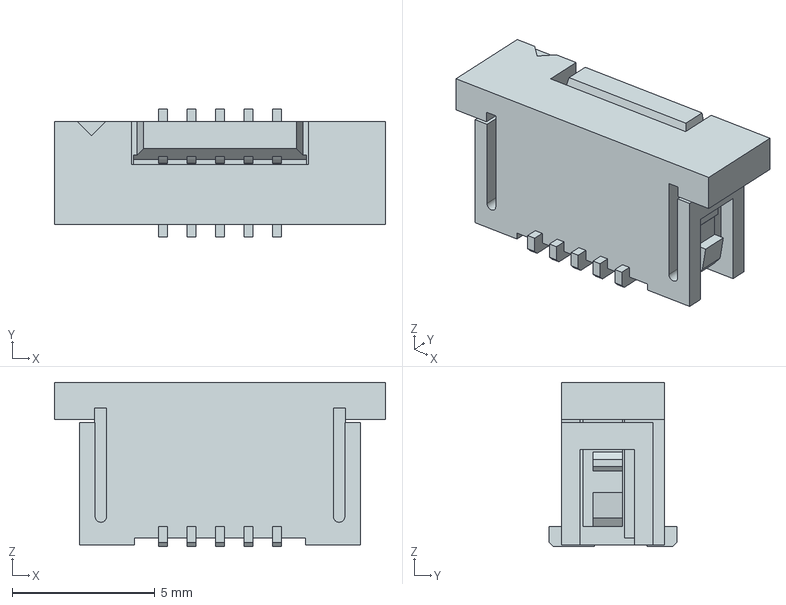
[picture p41: CAD file, 2026-10-30]
3D/Connectors/FFC/STEP/Molex_526100571_1R5P_1.0MM_VERT.stp
11.6 x 4.50 x 5.75 mm
