CascoLogix/KiCAD_Libraries/3D/Connectors/FFC/STL/FFC_14_BOT_LATCH_SMT.stl

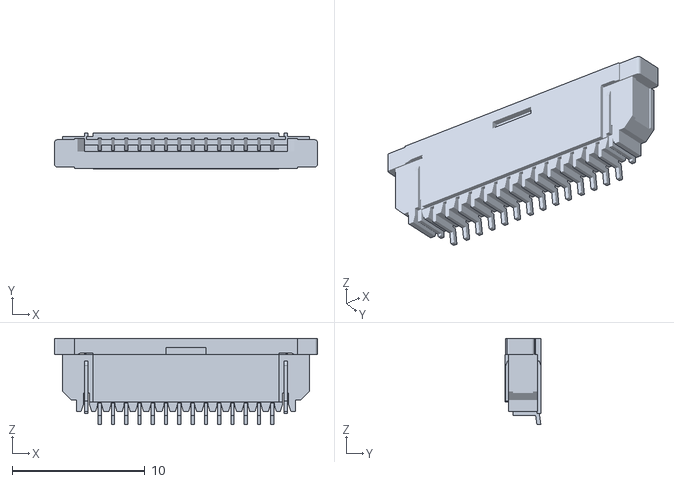
[picture p42: CAD file, 2014-12-09]
3D/Connectors/FFC/STL/FFC_14_BOT_LATCH_SMT.stl
19.8 x 2.70 x 6.50
