CascoLogix/KiCAD_Libraries/3D/Connectors/JST/STEP/JST_SM02B_SURS_TF.step

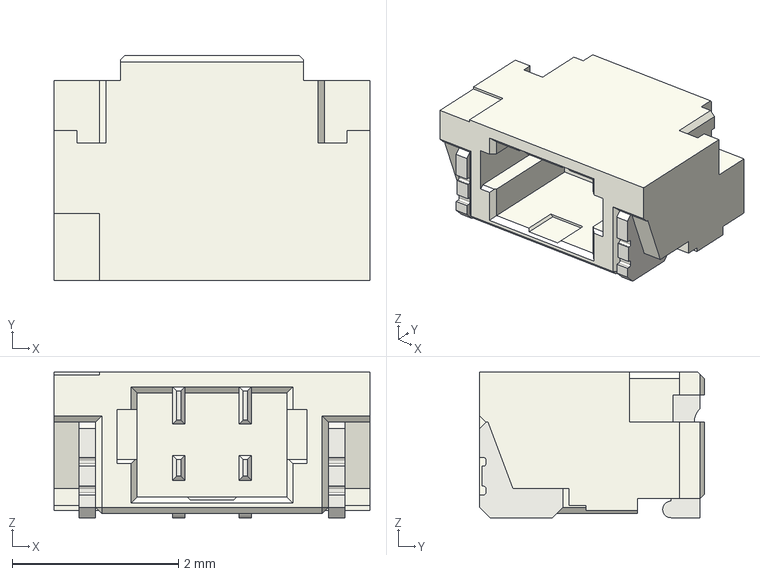
[picture p43: CAD file, 2025-10-27]
3D/Connectors/JST/STEP/JST_SM02B_SURS_TF.step
3.80 x 2.70 x 1.75 mm
