CascoLogix/KiCAD_Libraries/3D/Connectors/microsd card.SLDPRT

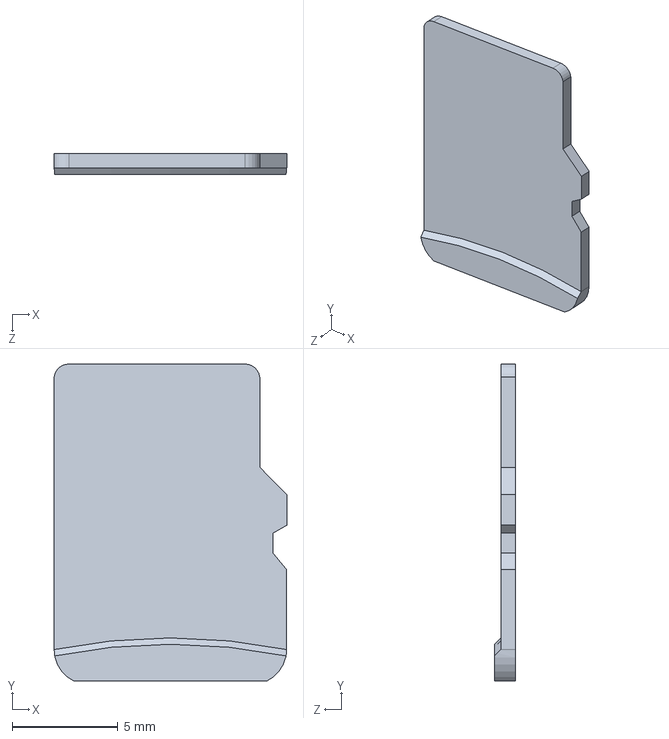
[picture p44: CAD file, 2013-10-21]
3D/Connectors/microsd card.SLDPRT
11.0 x 15.0 x 1.00 mm
