CascoLogix/KiCAD_Libraries/3D/Connectors/Power/STEP/Molex_0781710002.step

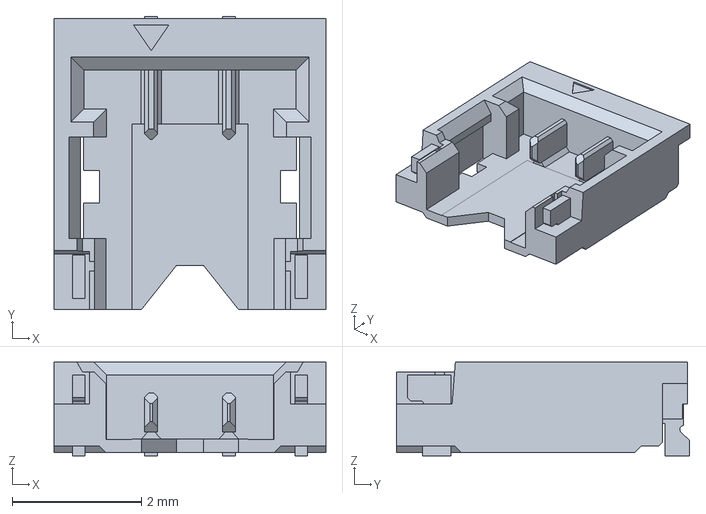
[picture p45: CAD file, 2025-10-27]
3D/Connectors/Power/STEP/Molex_0781710002.step
4.20 x 4.53 x 1.45 mm
