CascoLogix/KiCAD_Libraries/3D/Connectors/PRECI-DIP/STEP/8PM-11-0002-02-131.step

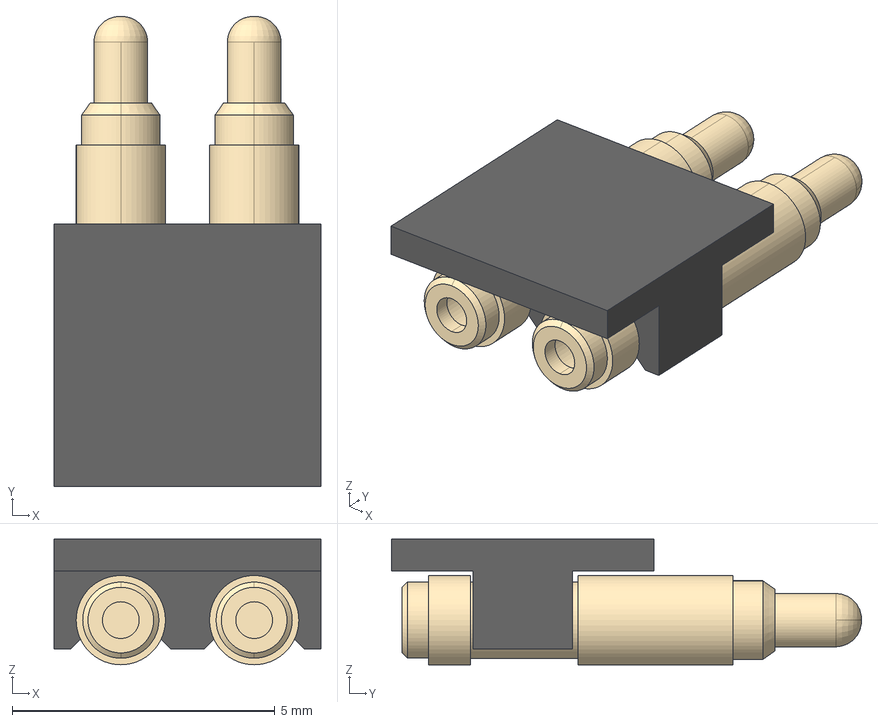
[picture p46: CAD file, 2020-03-11]
3D/Connectors/PRECI-DIP/STEP/8PM-11-0002-02-131.step
5.08 x 8.95 x 2.39 mm
