CascoLogix/KiCAD_Libraries/3D/Connectors/Quick-Fit/CAD/CONNECTOR_QUICK_FIT_F_PTH_KEYSTONE_3528_2.SLDPRT

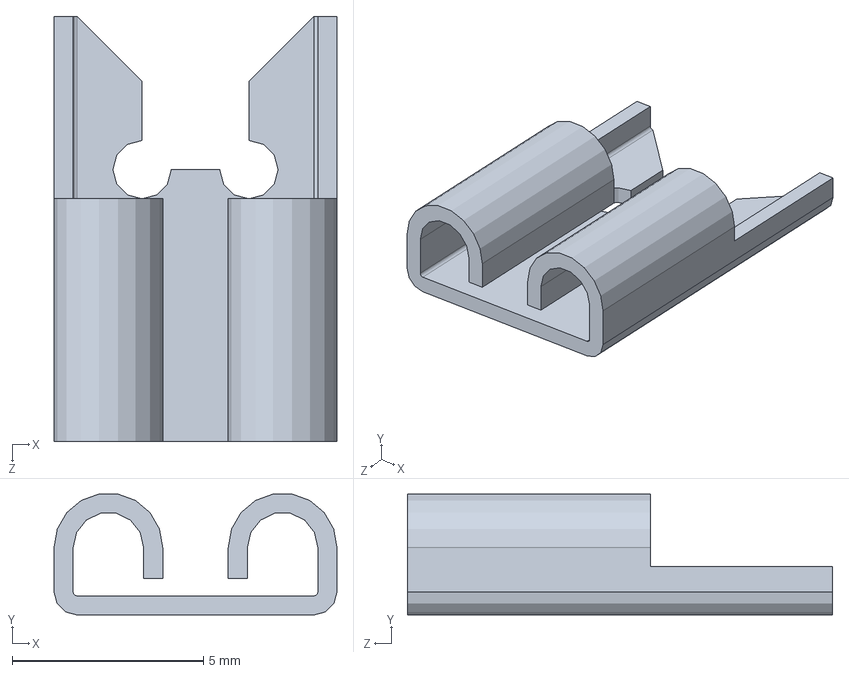
[picture p47: CAD file, 2013-10-21]
3D/Connectors/Quick-Fit/CAD/CONNECTOR_QUICK_FIT_F_PTH_KEYSTONE_3528_2.SLDPRT
7.39 x 3.16 x 11.1 mm
