CascoLogix/KiCAD_Libraries/3D/Connectors/Quick-Fit/STL/Keystone_3528_2.STL

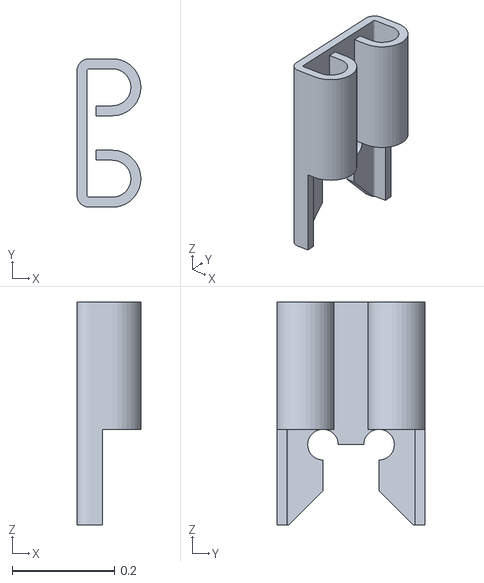
[picture p48: CAD file, 2013-10-21]
3D/Connectors/Quick-Fit/STL/Keystone_3528_2.STL
0.125 x 0.291 x 0.437
