CascoLogix/KiCAD_Libraries/3D/Connectors/RF/CAD/Samtec-SMA-J-P-H-ST-TH1.SLDPRT

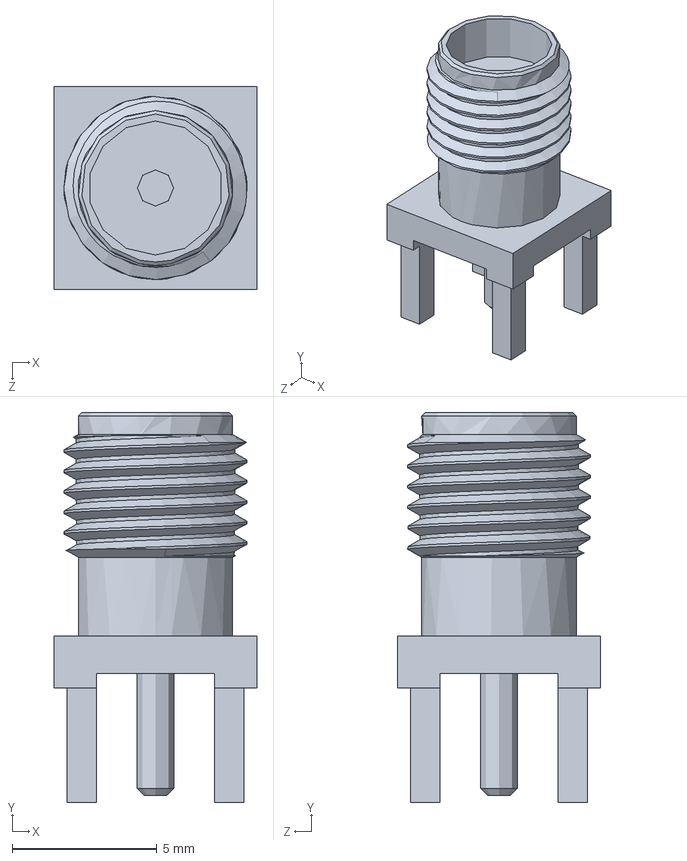
[picture p49: CAD file, 2016-09-16]
3D/Connectors/RF/CAD/Samtec-SMA-J-P-H-ST-TH1.SLDPRT
7.00 x 13.5 x 7.00 mm
