CascoLogix/KiCAD_Libraries/3D/Connectors/RF/STEP/UFL-R-SMT_3.step

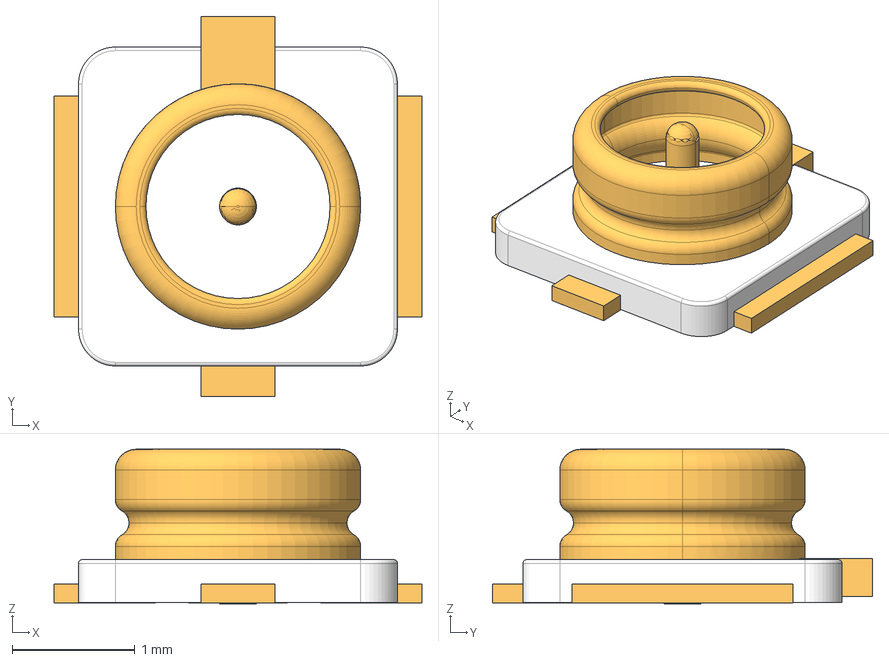
[picture p50: CAD file, 2020-01-19]
3D/Connectors/RF/STEP/UFL-R-SMT_3.step
3.00 x 3.10 x 1.26 mm
