CascoLogix/KiCAD_Libraries/3D/Connectors/RJ-45/STEP/Wurth_Electronics_74984104401.step

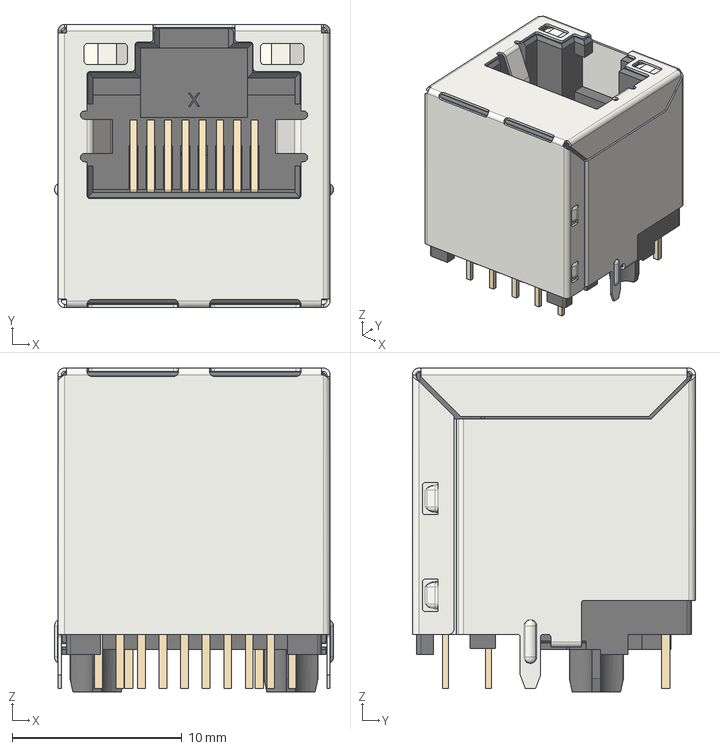
[picture p51: CAD file, 2020-10-09]
3D/Connectors/RJ-45/STEP/Wurth_Electronics_74984104401.step
16.4 x 16.7 x 19.1 mm
