CascoLogix/KiCAD_Libraries/3D/Connectors/Samtec/CJT/STEP/CJT-T-P-XX-RA-TH1.step

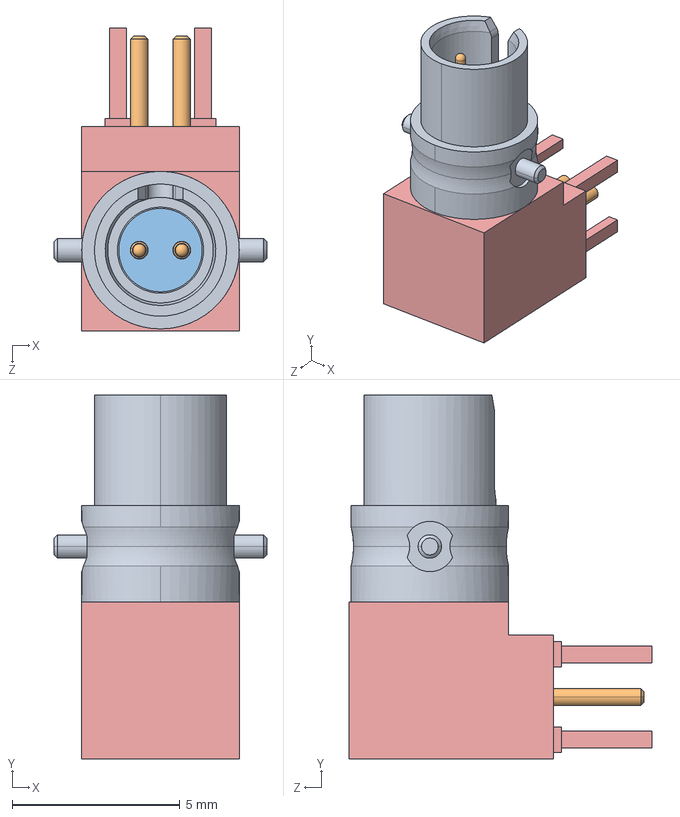
[picture p52: CAD file, 2013-10-21]
3D/Connectors/Samtec/CJT/STEP/CJT-T-P-XX-RA-TH1.step
6.35 x 10.9 x 9.05 mm
CJT-T-P-X-RA-TH1-SHL_RA SNOUT
CJT-T-P-X-RA-TH1-PIN x 2
CJT-INS-001
CJT-INS-002_RA BOTTOM INSUL
CJT-BDY-001-X_RA VERSION
