CascoLogix/KiCAD_Libraries/3D/Connectors/Samtec/ERCD/STEP/ERCD-010-TEU-N-S-1.step

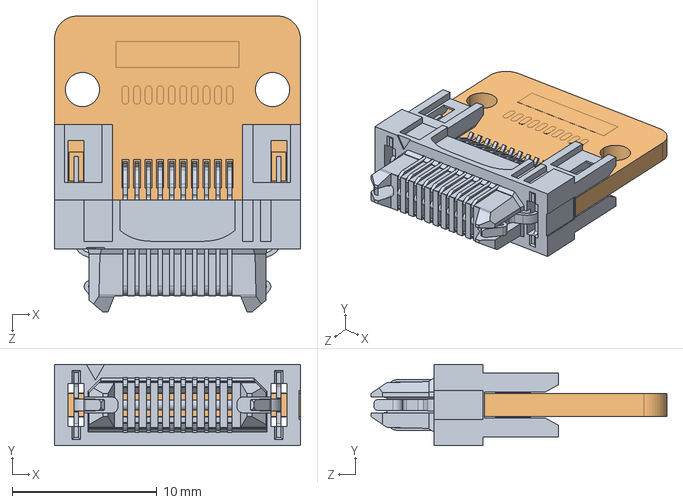
[picture p53: CAD file, 2013-10-21]
3D/Connectors/Samtec/ERCD/STEP/ERCD-010-TEU-N-S-1.step
17.0 x 5.60 x 20.5 mm
ERM8-EM
ERCD PCB-EM_10 POS
