CascoLogix/KiCAD_Libraries/3D/Connectors/Samtec/ERF8/STEP/ERF8-020-05.0-X-DV-L.step

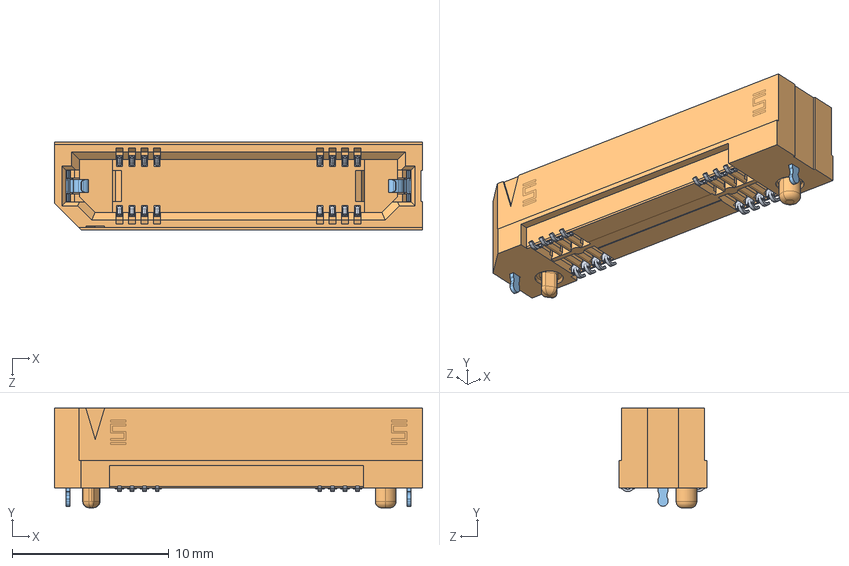
[picture p54: CAD file, 2013-10-21]
3D/Connectors/Samtec/ERF8/STEP/ERF8-020-05.0-X-DV-L.step
23.5 x 6.37 x 5.60 mm
C3D-C-211-XX.X-X_-05 x 16
C3D-ERF8-XXX-XX.X-DV-XXX_-05 25 pos w_latches
C3D-WT-30-XX-X x 2
