CascoLogix/KiCAD_Libraries/3D/Connectors/Samtec/IPBT/STEP/IPBT-104-H2-X-D.step

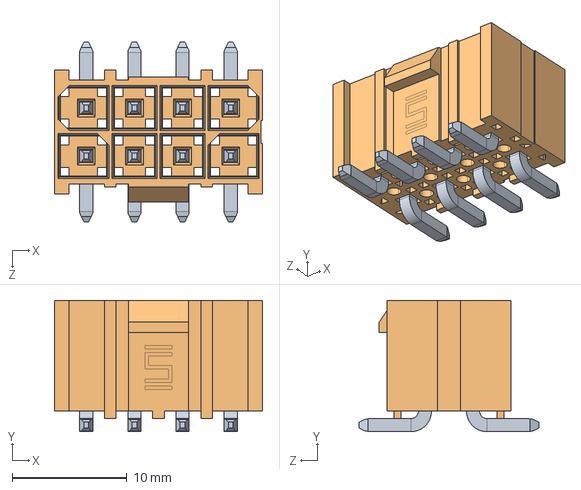
[picture p55: CAD file, 2013-10-21]
3D/Connectors/Samtec/IPBT/STEP/IPBT-104-H2-X-D.step
18.1 x 11.4 x 15.6 mm
T-1S55-X_SMT x 8
IPBT-XX-D-XX_Vertical (8 pos)
