CascoLogix/KiCAD_Libraries/3D/Connectors/SD/CAD/Micro_SD.SLDPRT

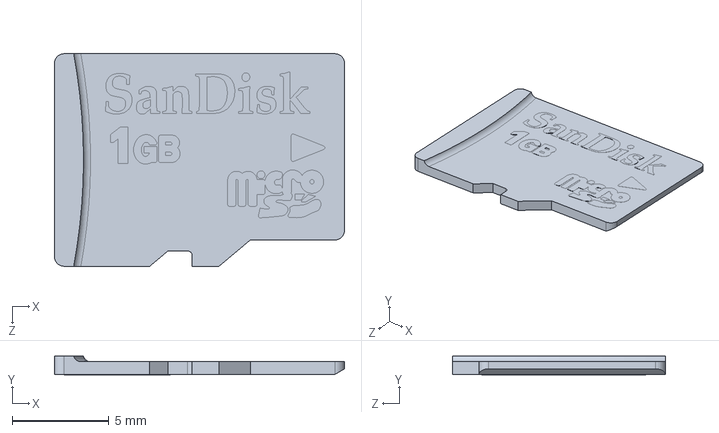
[picture p56: CAD file, 2016-01-23]
3D/Connectors/SD/CAD/Micro_SD.SLDPRT
15.0 x 0.975 x 11.0 mm
