CascoLogix/KiCAD_Libraries/3D/Connectors/USB/CAD/CONNECTOR_USB_TYPE_MINI_B_RA_SMT_GENERIC.SLDPRT

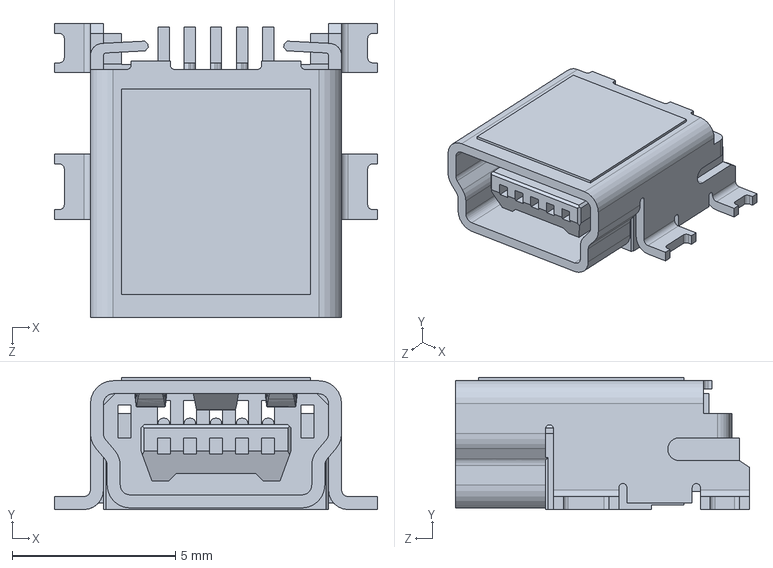
[picture p57: CAD file, 2013-10-21]
3D/Connectors/USB/CAD/CONNECTOR_USB_TYPE_MINI_B_RA_SMT_GENERIC.SLDPRT
9.90 x 4.05 x 9.00 mm
