CascoLogix/KiCAD_Libraries/3D/Connectors/USB/STEP/USB4105-GF-A.step

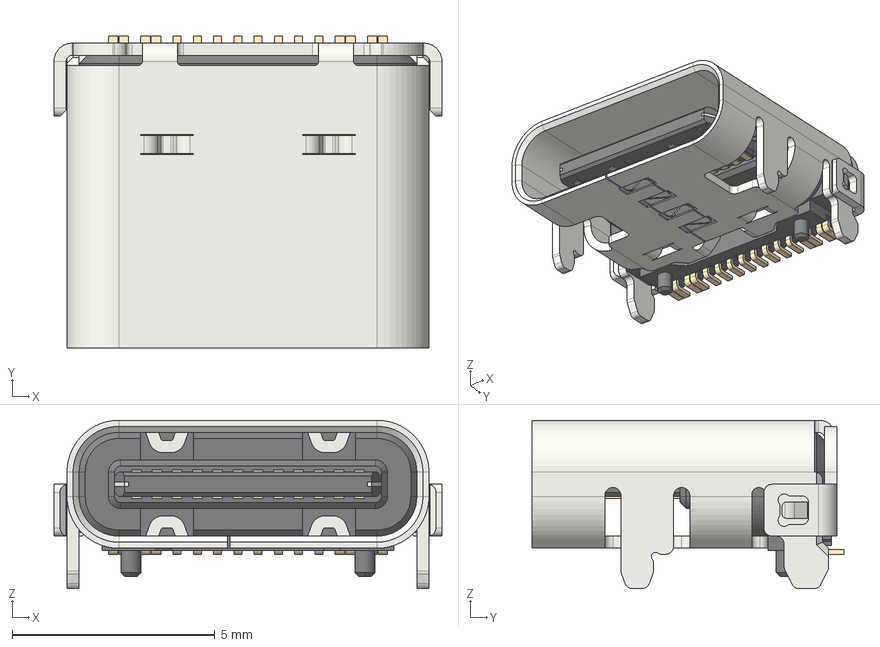
[picture p58: CAD file, 2025-10-27]
3D/Connectors/USB/STEP/USB4105-GF-A.step
9.58 x 7.71 x 4.16 mm
