CascoLogix/KiCAD_Libraries/3D/Connectors/USB/STL/User Library-Micro USB_typeB_10118192-0001LF FCI.STL

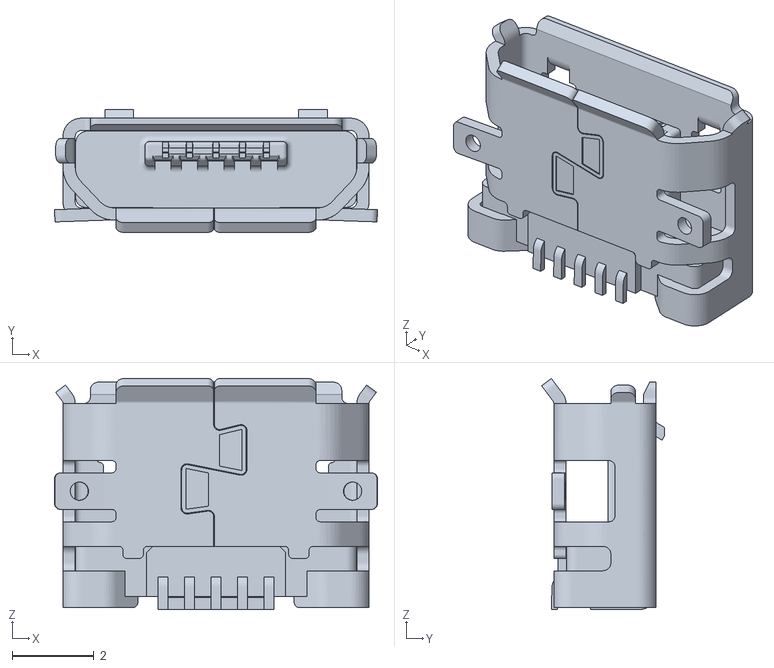
[picture p59: CAD file, 2016-01-23]
3D/Connectors/USB/STL/User Library-Micro USB_typeB_10118192-0001LF FCI.STL
7.91 x 3.01 x 5.66
