CascoLogix/KiCAD_Libraries/3D/Discrete/Active/CAD/DO-214AC SMA.SLDPRT

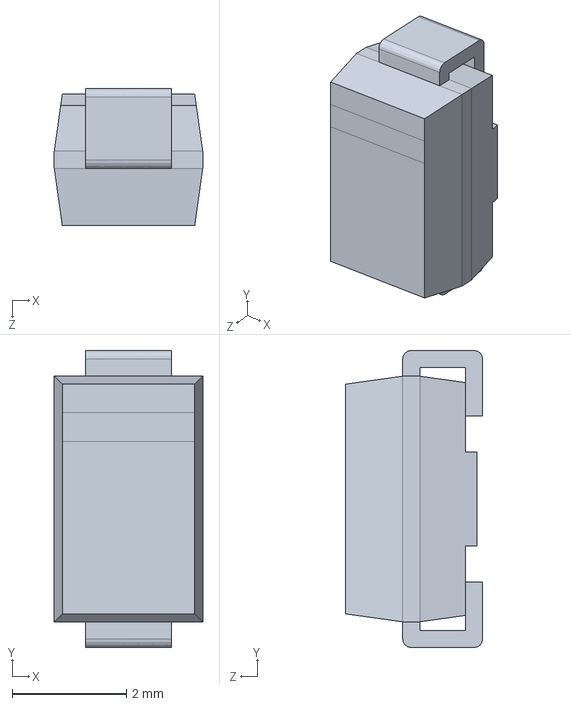
[picture p60: CAD file, 2013-10-21]
3D/Discrete/Active/CAD/DO-214AC SMA.SLDPRT
2.60 x 5.20 x 2.40 mm
