CascoLogix/KiCAD_Libraries/3D/Discrete/Active/STEP/8-PowerVDFN.step

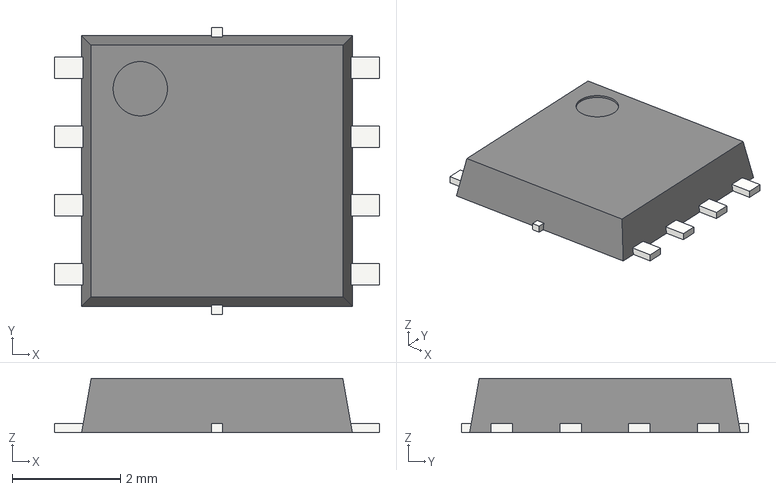
[picture p61: CAD file, 2025-10-27]
3D/Discrete/Active/STEP/8-PowerVDFN.step
6.00 x 5.30 x 1 mm
