CascoLogix/KiCAD_Libraries/3D/Discrete/Passive/Antenna/STEP/SW868-TH13.STEP

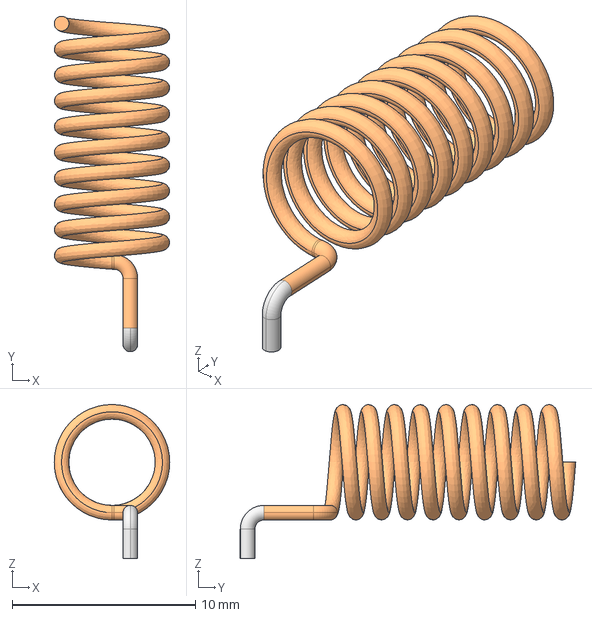
[picture p62: CAD file, 2017-12-12]
3D/Discrete/Passive/Antenna/STEP/SW868-TH13.STEP
6.30 x 18.3 x 8.40 mm
