CascoLogix/KiCAD_Libraries/3D/Discrete/Passive/Capacitors/STEP/CP_Elec_10x10.step

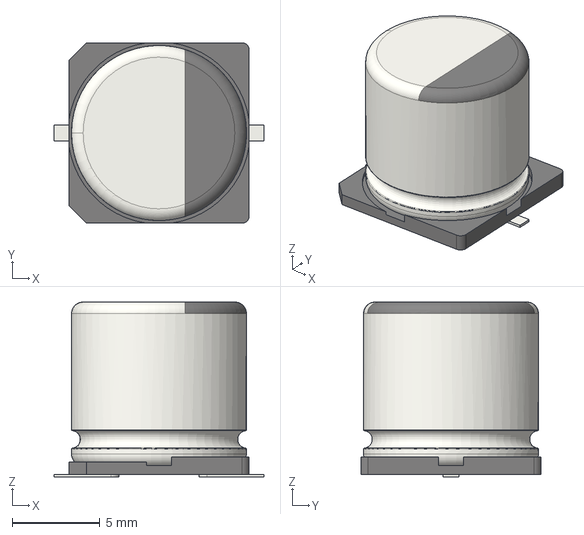
[picture p63: CAD file, 2021-02-10]
3D/Discrete/Passive/Capacitors/STEP/CP_Elec_10x10.step
12.0 x 10.3 x 10.0 mm
