CascoLogix/KiCAD_Libraries/3D/Discrete/Passive/Ceramic_Resonators/CAD/User Library-CSTCE_V-1.SLDPRT

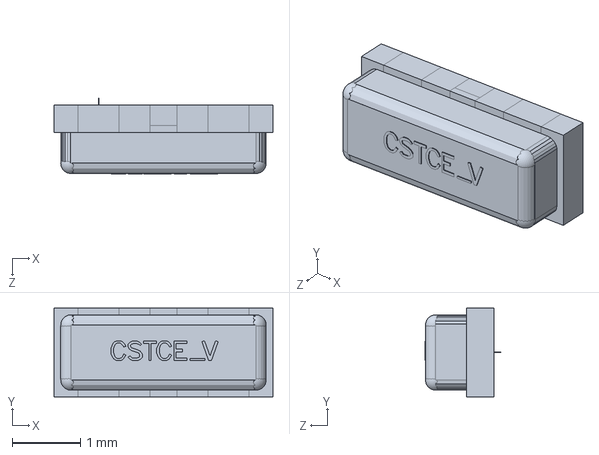
[picture p64: CAD file, 2013-10-21]
3D/Discrete/Passive/Ceramic_Resonators/CAD/User Library-CSTCE_V-1.SLDPRT
3.20 x 1.30 x 1.12 mm
