CascoLogix/KiCAD_Libraries/3D/Discrete/Passive/Chip_Antenna/STEP/2.4GHz_Chip_Antenna.step

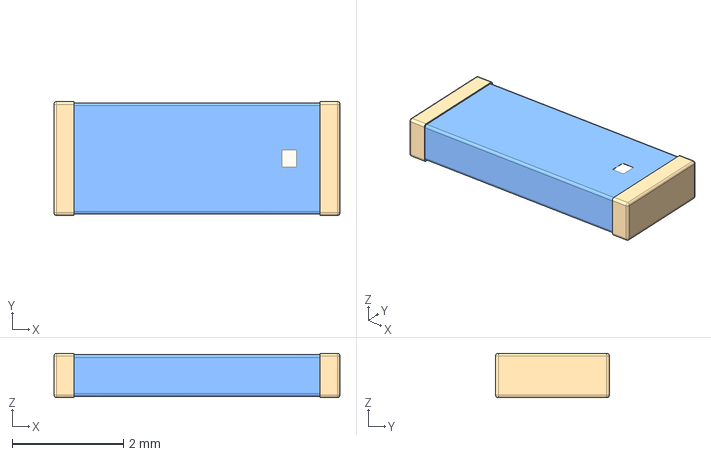
[picture p65: CAD file, 2020-01-19]
3D/Discrete/Passive/Chip_Antenna/STEP/2.4GHz_Chip_Antenna.step
5.14 x 2.05 x 0.8 mm
