CascoLogix/KiCAD_Libraries/3D/Discrete/Passive/Crystals/STEP/Murata_CSTNE12M.step

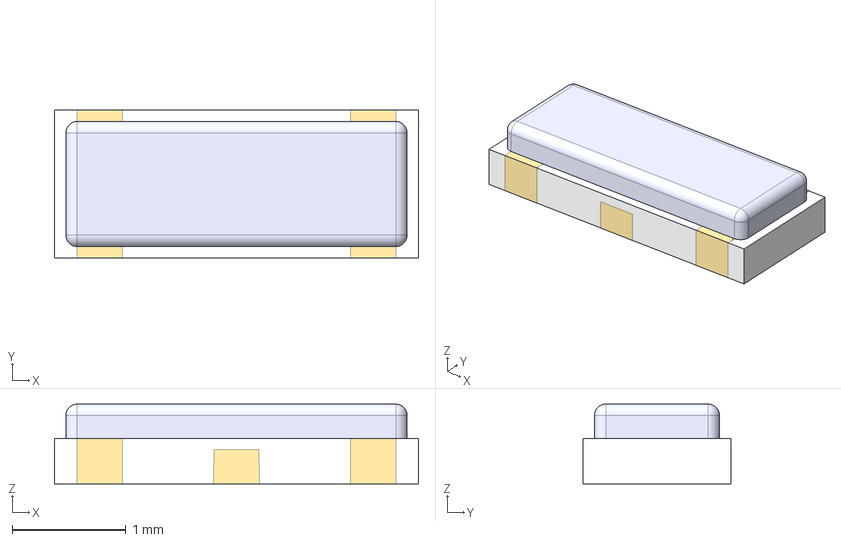
[picture p66: CAD file, 2020-02-19]
3D/Discrete/Passive/Crystals/STEP/Murata_CSTNE12M.step
3.20 x 1.30 x 0.701 mm
