CascoLogix/KiCAD_Libraries/3D/Discrete/Passive/Crystals/STL/AB26TRB.STL

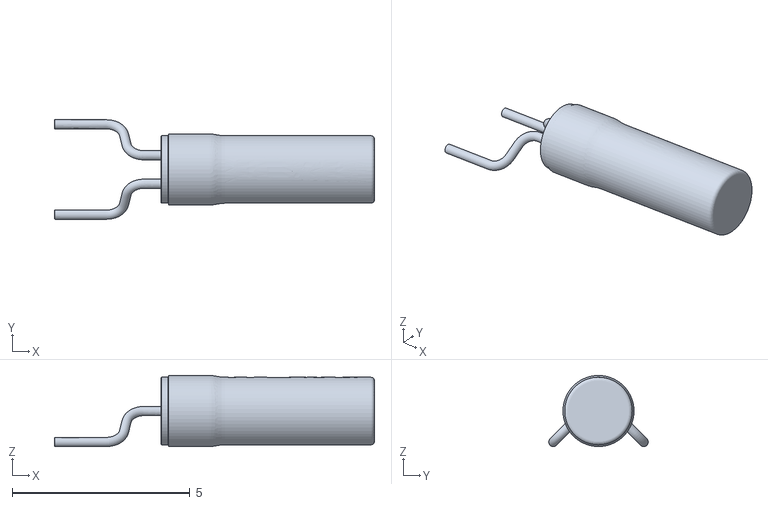
[picture p67: CAD file, 2014-12-09]
3D/Discrete/Passive/Crystals/STL/AB26TRB.STL
9.00 x 2.80 x 2.00
