CascoLogix/KiCAD_Libraries/3D/Discrete/Passive/Fuse/STEP/FUSE_LITTELFUSE-370.step

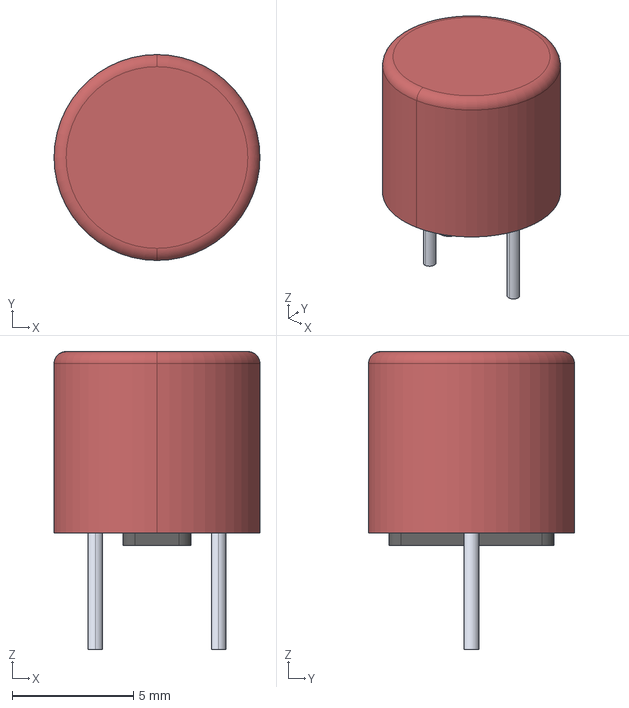
[picture p68: CAD file, 2020-03-22]
3D/Discrete/Passive/Fuse/STEP/FUSE_LITTELFUSE-370.step
8.50 x 8.50 x 12.3 mm
