CascoLogix/KiCAD_Libraries/3D/Discrete/Passive/Inductors/STEP/Taiyo_Yuden_LSXND6060WH.STEP

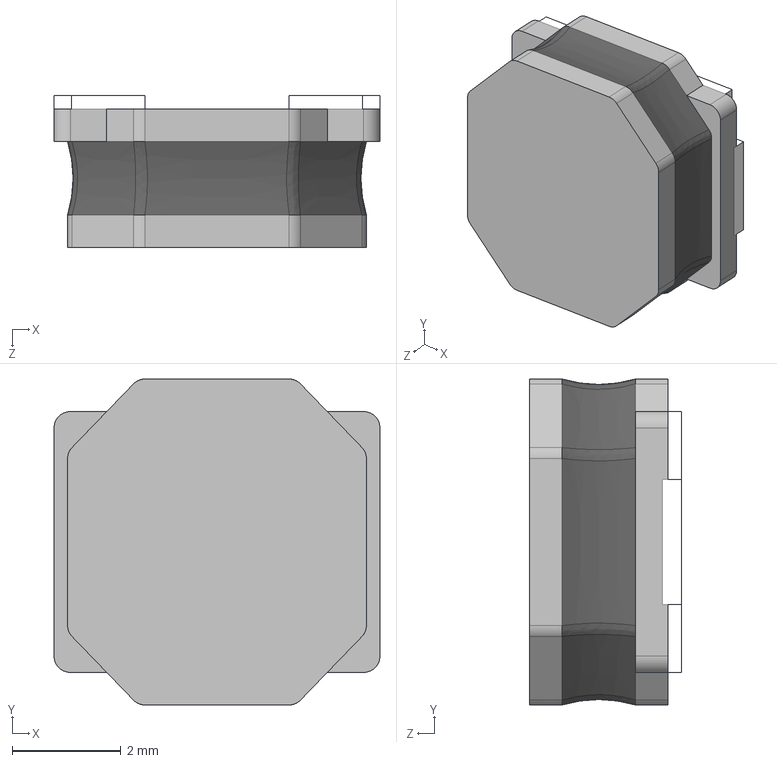
[picture p69: CAD file, 2026-10-30]
3D/Discrete/Passive/Inductors/STEP/Taiyo_Yuden_LSXND6060WH.STEP
6.00 x 6.00 x 2.80 mm
