CascoLogix/KiCAD_Libraries/3D/Discrete/Passive/PTCs/STEP/PTC_0603.step

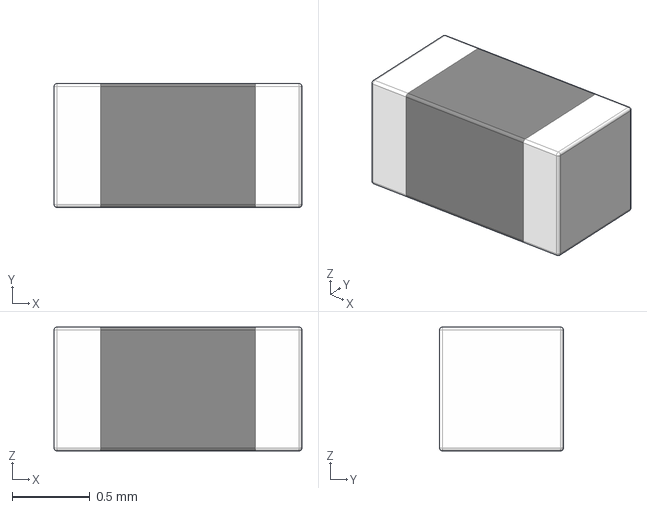
[picture p70: CAD file, 2017-03-05]
3D/Discrete/Passive/PTCs/STEP/PTC_0603.step
1.60 x 0.8 x 0.8 mm
