CascoLogix/KiCAD_Libraries/3D/Discrete/Passive/Resistors/STEP/WSHP2818.step

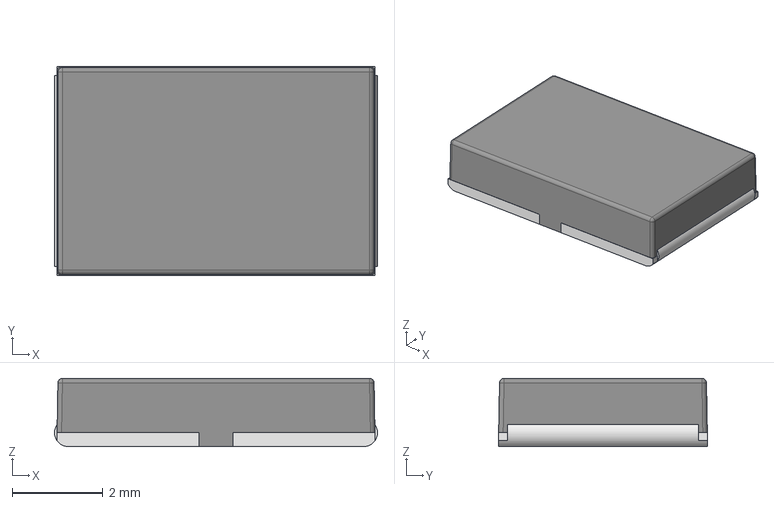
[picture p71: CAD file, 2025-10-27]
3D/Discrete/Passive/Resistors/STEP/WSHP2818.step
7.10 x 4.60 x 1.50 mm
