CascoLogix/KiCAD_Libraries/3D/Displays/LED/CAD/MAN6640.SLDPRT

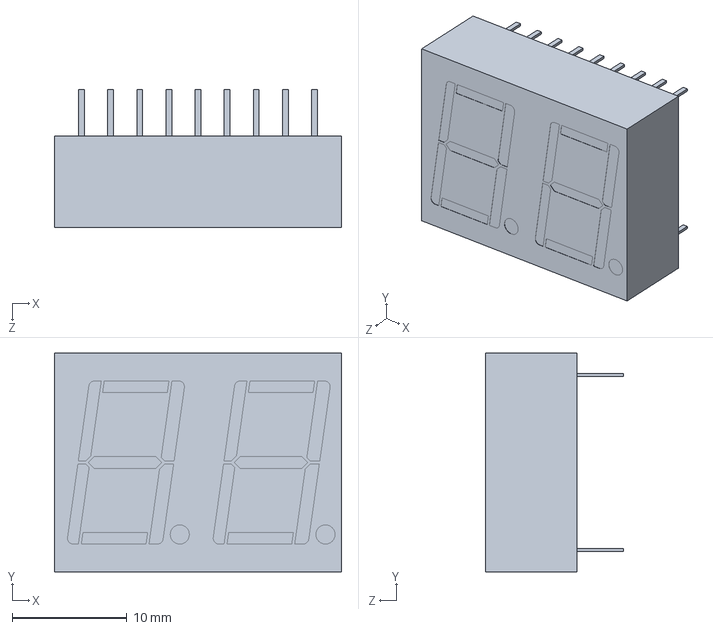
[picture p72: CAD file, 2013-02-01]
3D/Displays/LED/CAD/MAN6640.SLDPRT
25.0 x 19.1 x 12.1 mm
