CascoLogix/KiCAD_Libraries/3D/Displays/TFT/STEP/3.5_TFT_SL.step

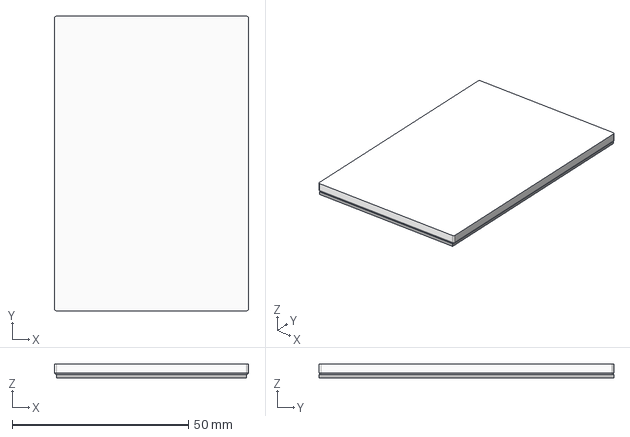
[picture p73: CAD file, 2018-11-05]
3D/Displays/TFT/STEP/3.5_TFT_SL.step
55.0 x 83.5 x 4.00 mm
