CascoLogix/KiCAD_Libraries/3D/Electromechanical/Buzzers/DB_Unlimited_TE092705-1.step

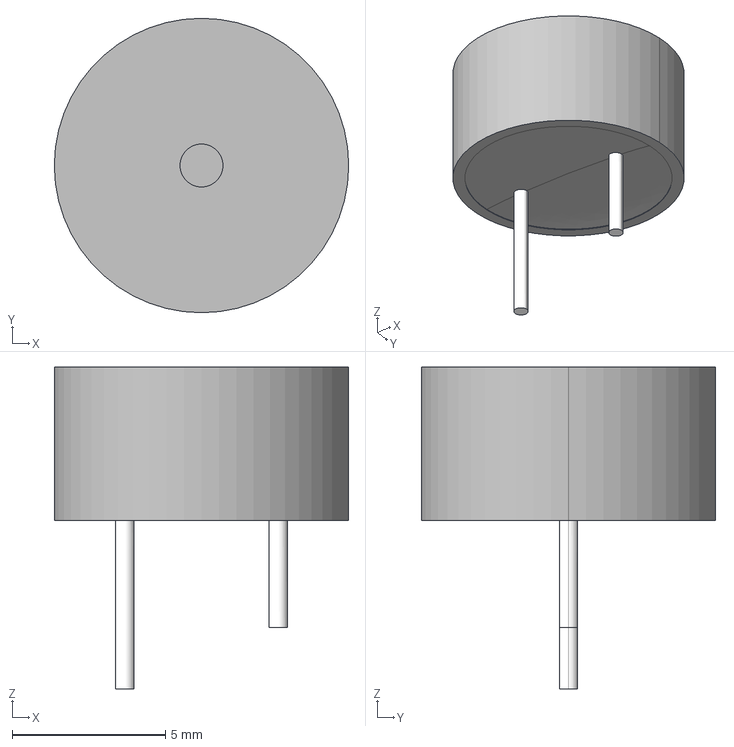
[picture p74: CAD file, 2019-09-30]
3D/Electromechanical/Buzzers/DB_Unlimited_TE092705-1.step
9.60 x 9.60 x 10.5 mm
