CascoLogix/KiCAD_Libraries/3D/Electromechanical/Encoders/CAD/ENCODER_ROT_KNOB_WPUSH_PTH_BOURNS.SLDPRT

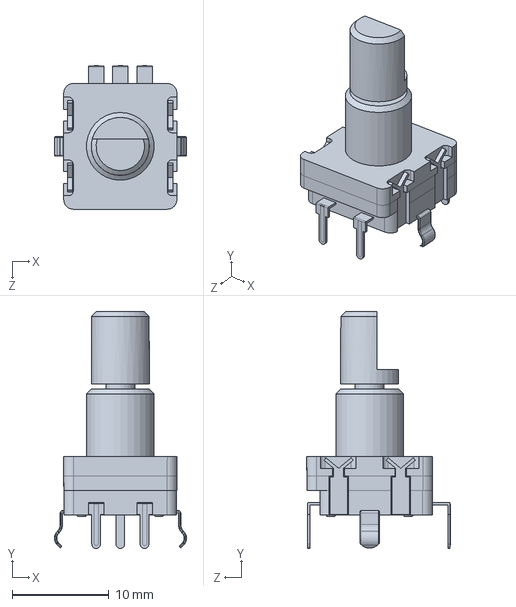
[picture p75: CAD file, 2013-10-21]
3D/Electromechanical/Encoders/CAD/ENCODER_ROT_KNOB_WPUSH_PTH_BOURNS.SLDPRT
13.7 x 24.5 x 14.8 mm
