CascoLogix/KiCAD_Libraries/3D/Electromechanical/Pushbuttons/CAD/TE_Connectivity_FSMSM.SLDPRT

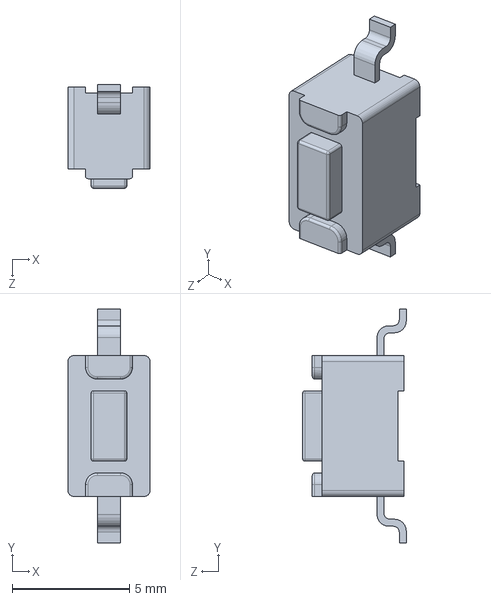
[picture p76: CAD file, 2014-11-28]
3D/Electromechanical/Pushbuttons/CAD/TE_Connectivity_FSMSM.SLDPRT
3.50 x 9.97 x 4.41 mm
