CascoLogix/KiCAD_Libraries/3D/Electromechanical/Pushbuttons/STEP/EVPAS_Color.step

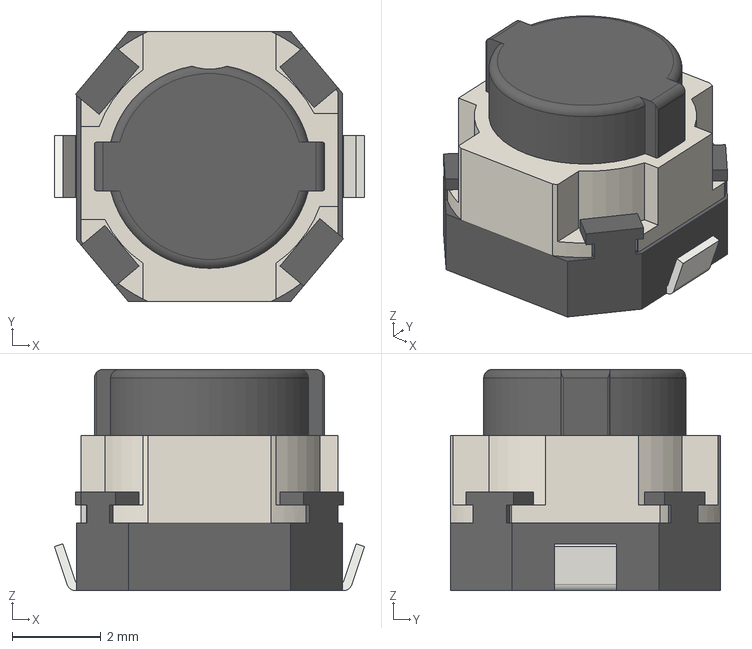
[picture p77: CAD file, 2020-09-20]
3D/Electromechanical/Pushbuttons/STEP/EVPAS_Color.step
7.00 x 6.10 x 5.00 mm
