CascoLogix/KiCAD_Libraries/3D/Electromechanical/Relays/STEP/TE_IM_Relay.step

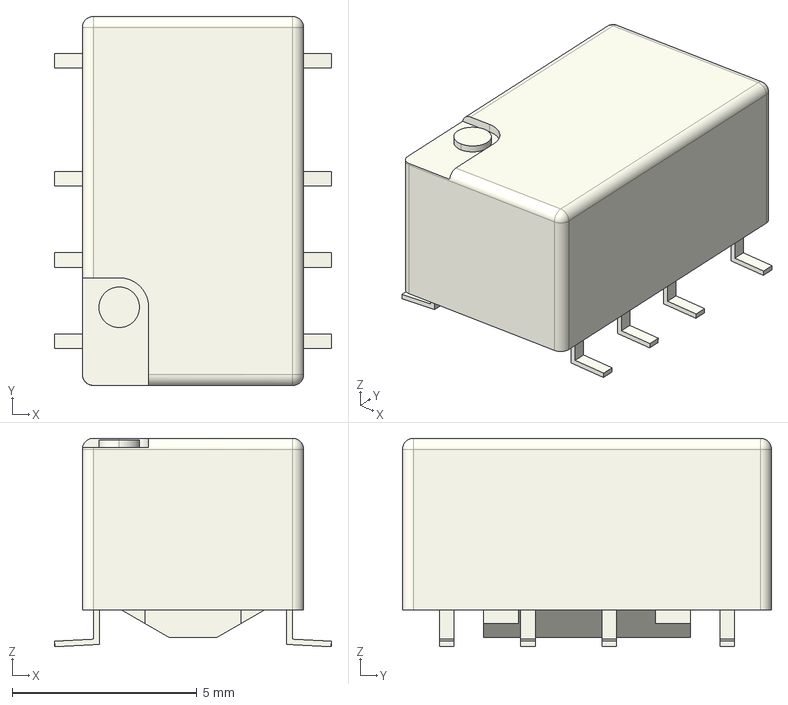
[picture p78: CAD file, 2021-02-23]
3D/Electromechanical/Relays/STEP/TE_IM_Relay.step
7.52 x 10.0 x 5.65 mm
