CascoLogix/KiCAD_Libraries/3D/Electromechanical/Rocker_Switches/CAD/Cherry_SR.SLDPRT

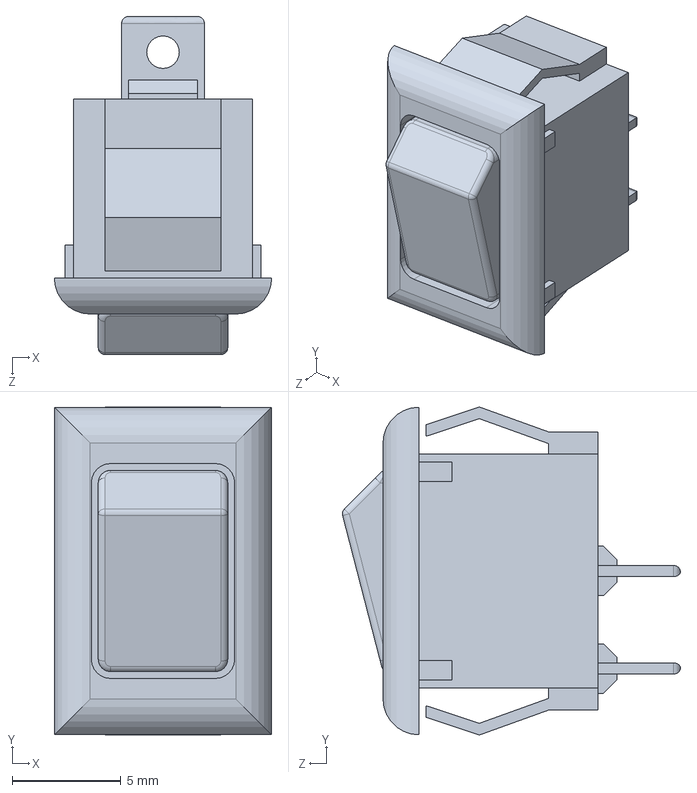
[picture p79: CAD file, 2013-10-21]
3D/Electromechanical/Rocker_Switches/CAD/Cherry_SR.SLDPRT
10.0 x 15.1 x 15.6 mm
