CascoLogix/KiCAD_Libraries/3D/Electromechanical/Switches/ESE22MV21T.step

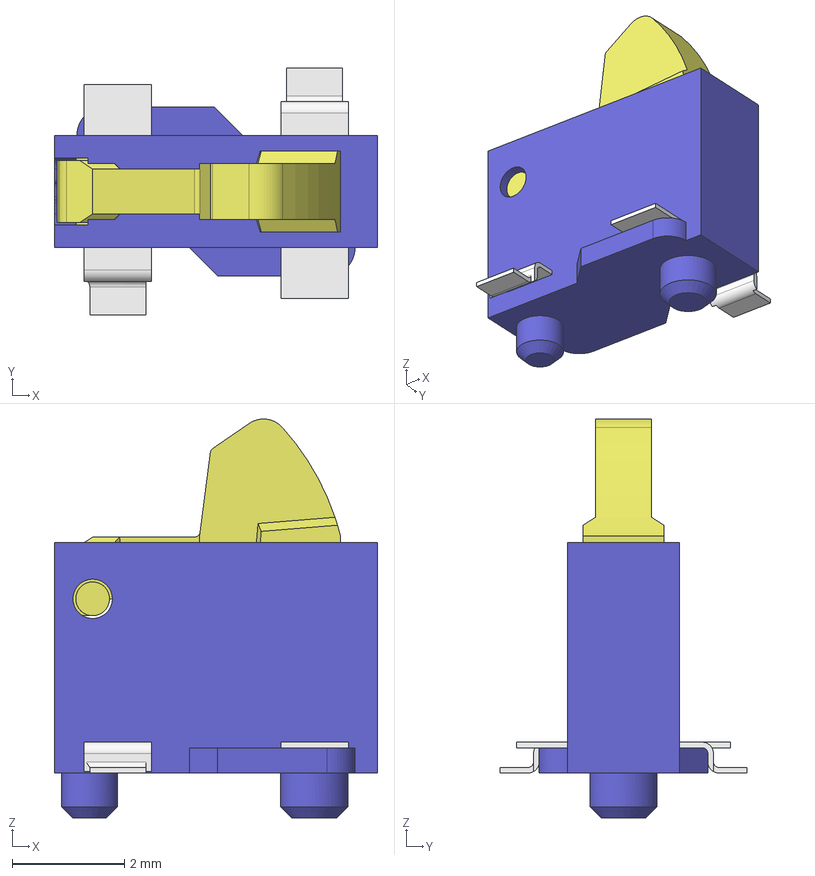
[picture p80: CAD file, 2018-12-07]
3D/Electromechanical/Switches/ESE22MV21T.step
5.75 x 4.40 x 7.10 mm
