CascoLogix/KiCAD_Libraries/3D/Headers/CAD/Sullins_NRPN101PAEN.SLDPRT

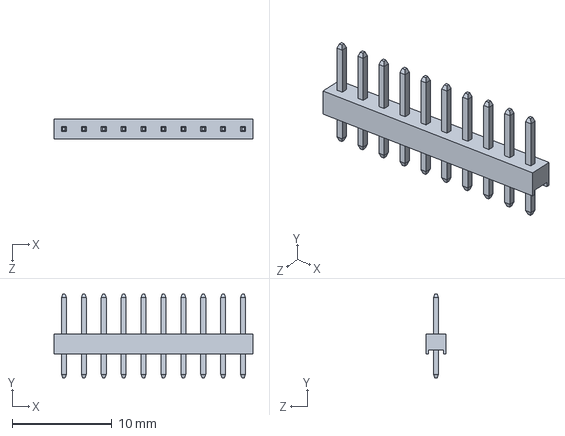
[picture p81: CAD file, 2017-02-20]
3D/Headers/CAD/Sullins_NRPN101PAEN.SLDPRT
20.0 x 8.40 x 2.00 mm
