CascoLogix/KiCAD_Libraries/3D/Headers/STEP/HEADER_F_2.54MM_1R6P_RA_PTH.stp

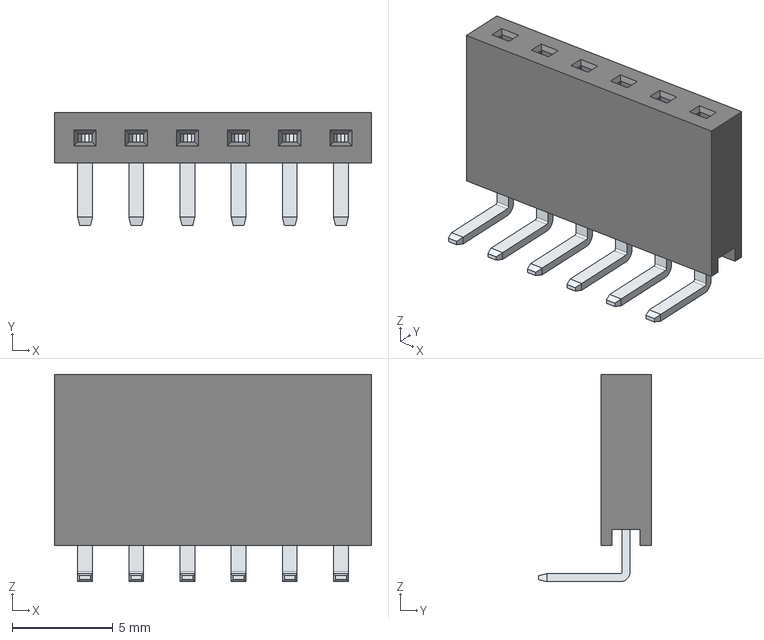
[picture p82: CAD file, 2026-10-30]
3D/Headers/STEP/HEADER_F_2.54MM_1R6P_RA_PTH.stp
15.7 x 5.59 x 10.3 mm
6130xx143121_PIN x 6
