CascoLogix/KiCAD_Libraries/3D/Headers/STL/PIN_HEADER_BODY_BLACK_050MIL_GOLD.STL

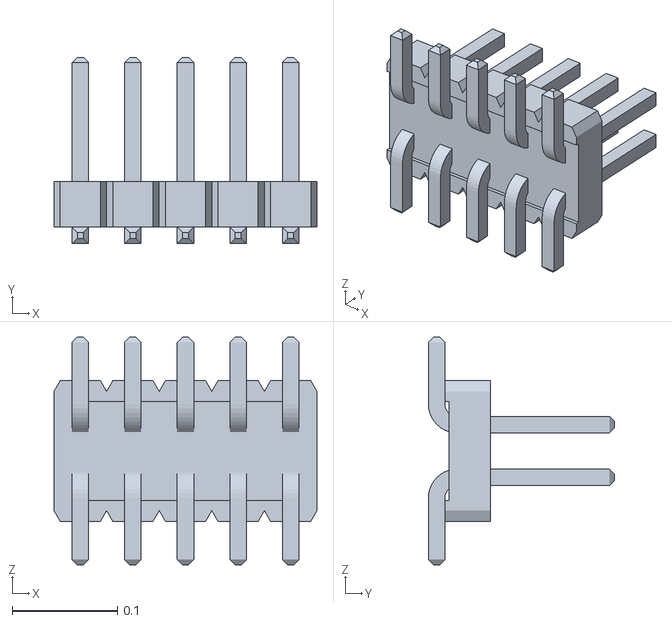
[picture p83: CAD file, 2014-11-28]
3D/Headers/STL/PIN_HEADER_BODY_BLACK_050MIL_GOLD.STL
0.25 x 0.177 x 0.217
