CascoLogix/KiCAD_Libraries/3D/ICs/BGA/STEP/BGA84_8M0X12M5.step

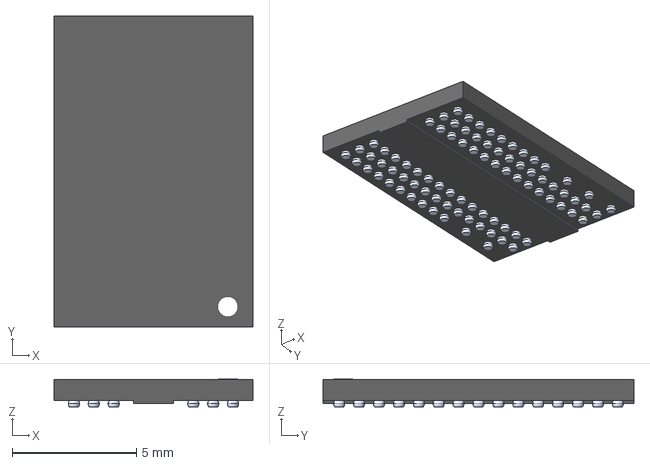
[picture p84: CAD file, 2020-01-19]
3D/ICs/BGA/STEP/BGA84_8M0X12M5.step
8.00 x 12.5 x 1.11 mm
