CascoLogix/KiCAD_Libraries/3D/ICs/DFN/STEP/PSON50P200X300X60-9N.step

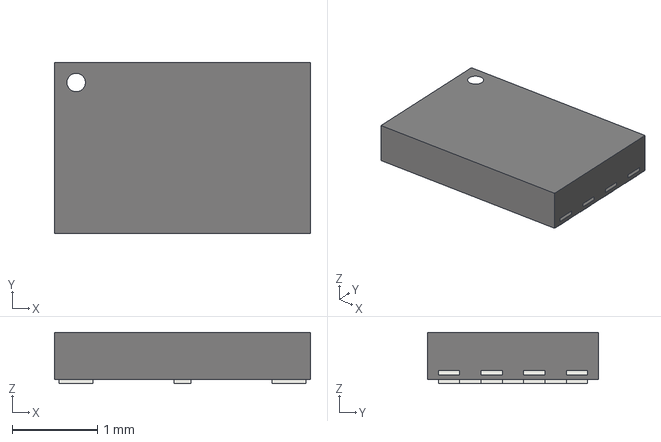
[picture p85: CAD file, 2025-10-27]
3D/ICs/DFN/STEP/PSON50P200X300X60-9N.step
3.00 x 2.00 x 0.6 mm
