CascoLogix/KiCAD_Libraries/3D/ICs/LGA/VL53L4CDV0DH.step

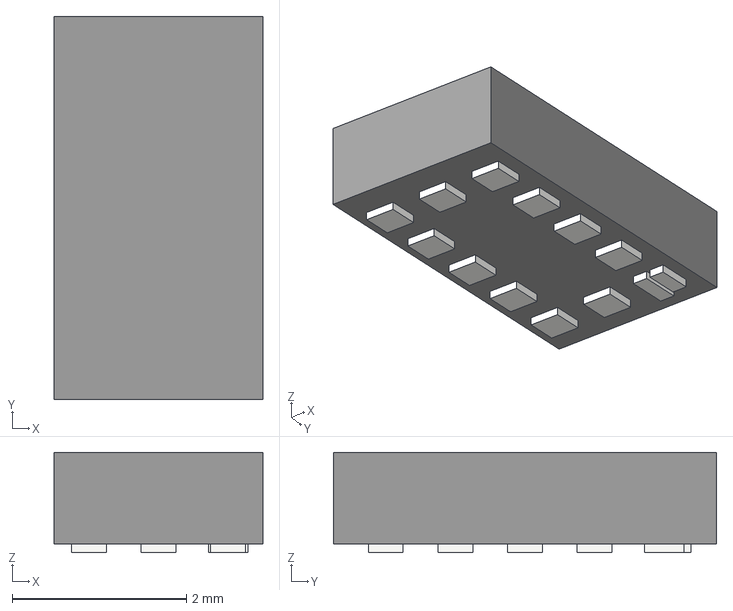
[picture p86: CAD file, 2025-10-27]
3D/ICs/LGA/VL53L4CDV0DH.step
2.40 x 4.40 x 1.15 mm
