CascoLogix/KiCAD_Libraries/3D/ICs/QFN/CAD/QFN24_5MM_5MM_0.65MM.SLDPRT

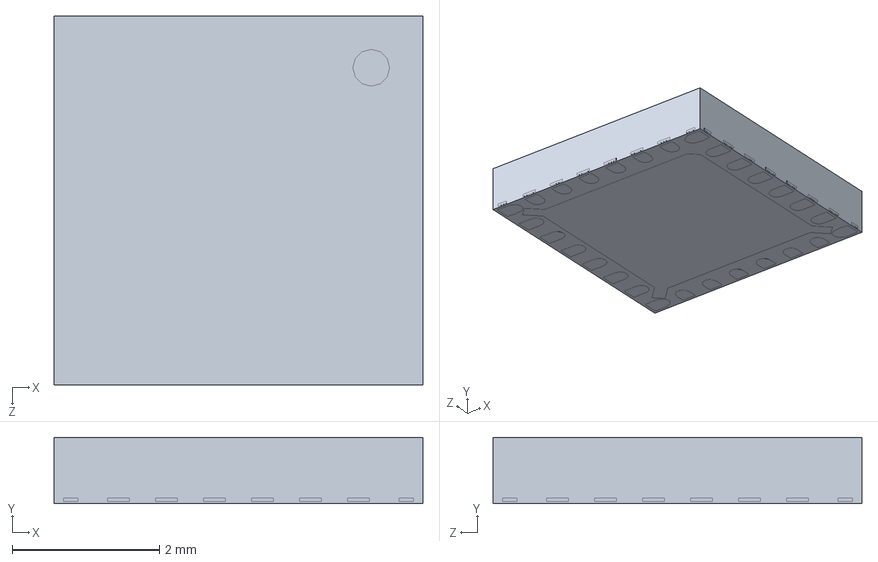
[picture p87: CAD file, 2013-10-21]
3D/ICs/QFN/CAD/QFN24_5MM_5MM_0.65MM.SLDPRT
5.00 x 0.9 x 5.00 mm
