CascoLogix/KiCAD_Libraries/3D/ICs/QFN/STEP/STQFN-16.step

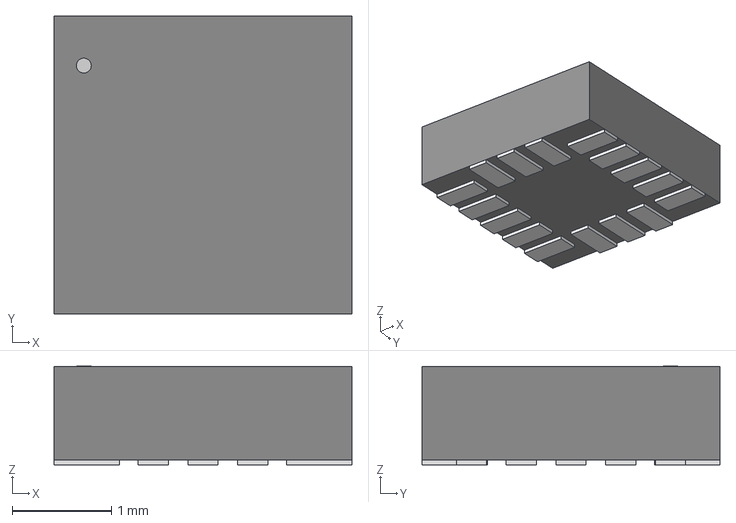
[picture p88: CAD file, 2026-10-30]
3D/ICs/QFN/STEP/STQFN-16.step
3.00 x 3.00 x 0.993 mm
