CascoLogix/KiCAD_Libraries/3D/ICs/SC70/STEP/SC70-5-1.step

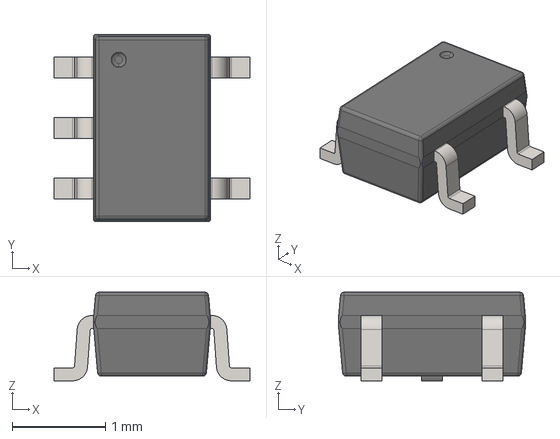
[picture p89: CAD file, 2018-07-14]
3D/ICs/SC70/STEP/SC70-5-1.step
2.10 x 2.00 x 0.95 mm
