CascoLogix/KiCAD_Libraries/3D/ICs/SOIC/CAD/SSOP-24.SLDPRT

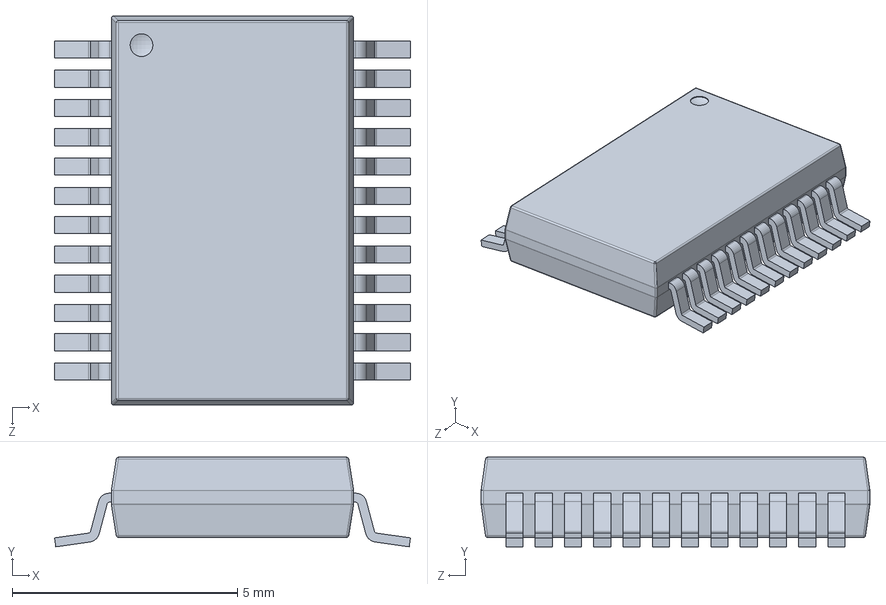
[picture p90: CAD file, 2013-10-21]
3D/ICs/SOIC/CAD/SSOP-24.SLDPRT
7.90 x 1.99 x 8.63 mm
