CascoLogix/KiCAD_Libraries/3D/ICs/SOIC/STEP/TLP290.step

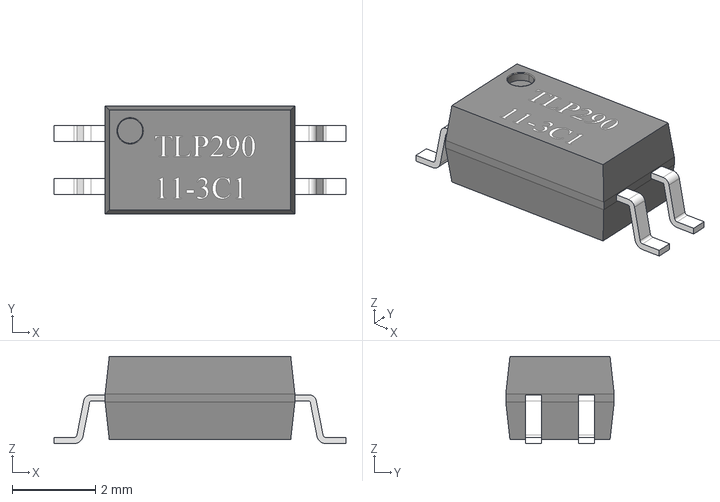
[picture p91: CAD file, 2020-01-20]
3D/ICs/SOIC/STEP/TLP290.step
7.00 x 2.60 x 2.10 mm
