CascoLogix/KiCAD_Libraries/3D/ICs/SOIC/STL/SOIC-18-300.STL

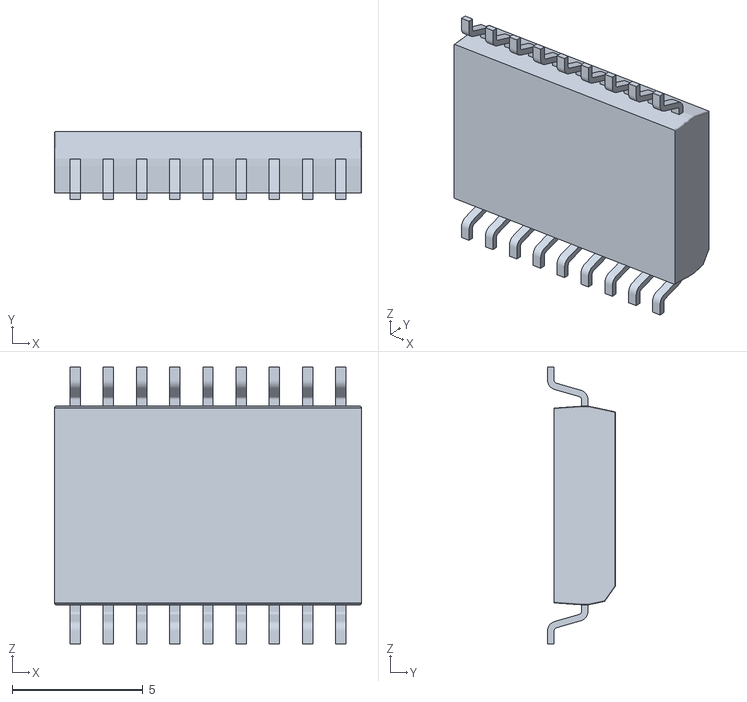
[picture p92: CAD file, 2014-12-09]
3D/ICs/SOIC/STL/SOIC-18-300.STL
11.8 x 2.60 x 10.6
