CascoLogix/KiCAD_Libraries/3D/ICs/SOP/STEP/SOP-16.step

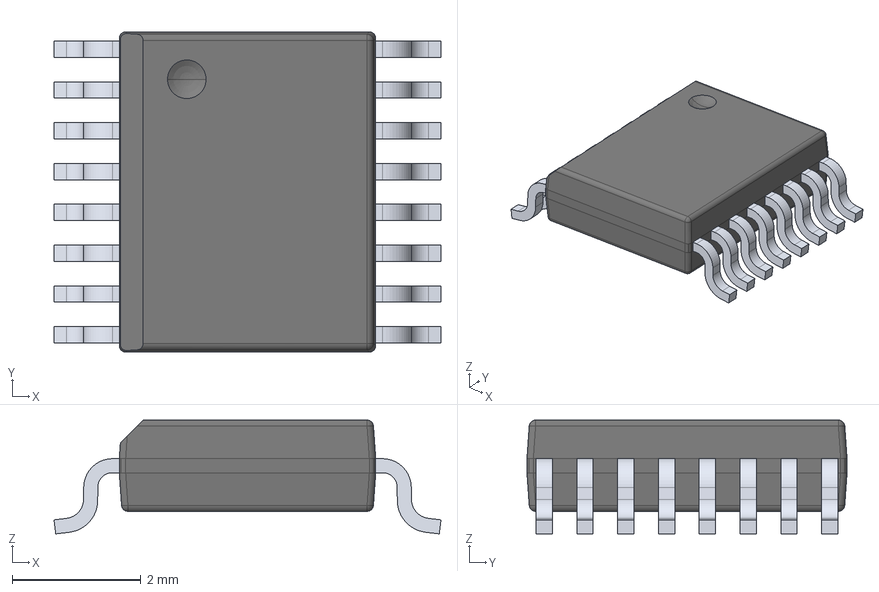
[picture p93: CAD file, 2020-10-13]
3D/ICs/SOP/STEP/SOP-16.step
6.02 x 4.98 x 1.77 mm
