CascoLogix/KiCAD_Libraries/3D/ICs/SOT/STEP/SOT323_SC70.step

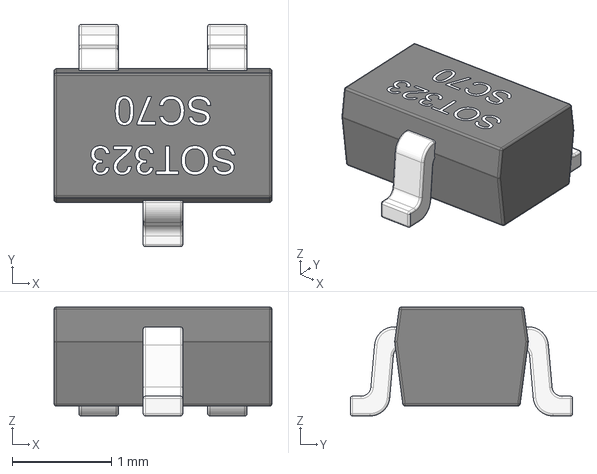
[picture p94: CAD file, 2020-10-13]
3D/ICs/SOT/STEP/SOT323_SC70.step
2.20 x 2.25 x 1.10 mm
