CascoLogix/KiCAD_Libraries/3D/ICs/SOT/STL/SC-70.STL

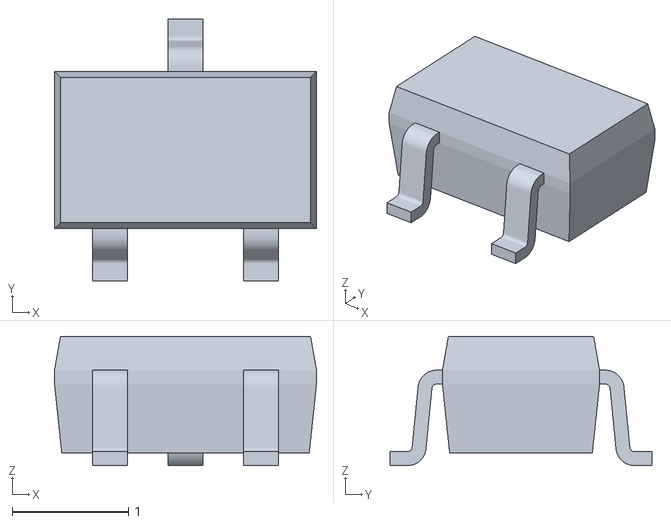
[picture p95: CAD file, 2014-12-09]
3D/ICs/SOT/STL/SC-70.STL
2.25 x 2.25 x 1.11
