CascoLogix/KiCAD_Libraries/3D/ICs/TQFP/STEP/TQFP-100.step

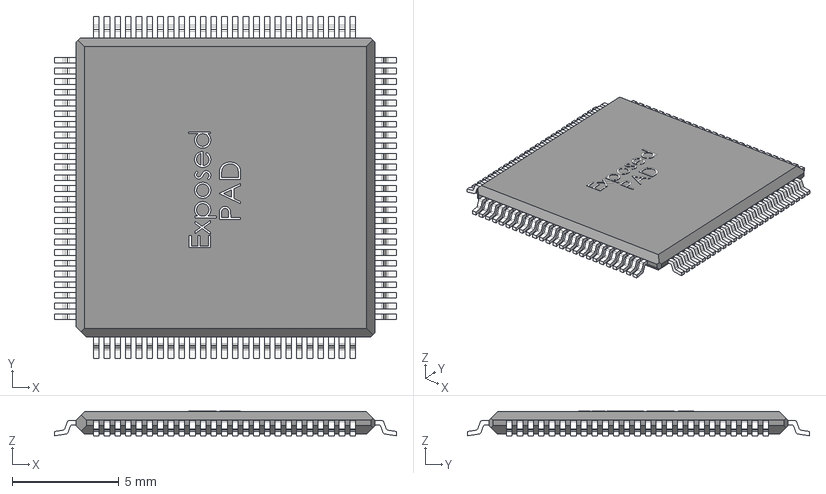
[picture p96: CAD file, 2018-10-28]
3D/ICs/TQFP/STEP/TQFP-100.step
16.0 x 16.0 x 1.15 mm
