CascoLogix/KiCAD_Libraries/3D/ICs/TSSOP/STEP/8-MSOP.step

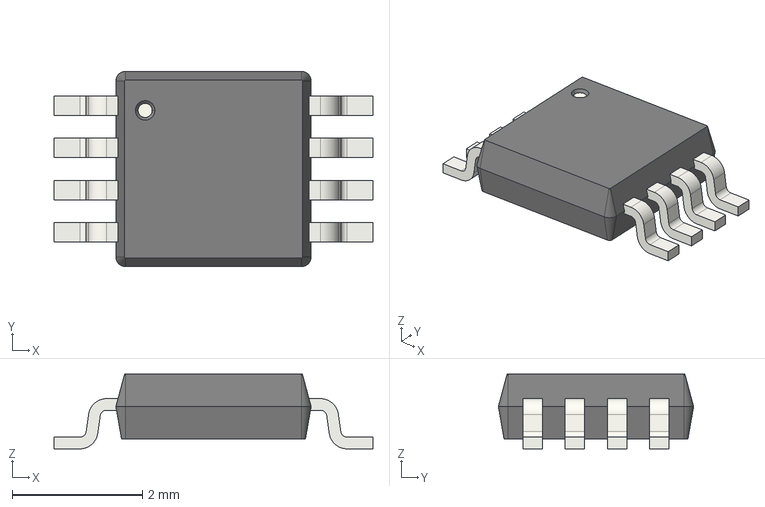
[picture p97: CAD file, 2025-10-27]
3D/ICs/TSSOP/STEP/8-MSOP.step
4.90 x 3.00 x 1.15 mm
