CascoLogix/KiCAD_Libraries/3D/ICs/TSSOP/STL/TSSOP-20.STL

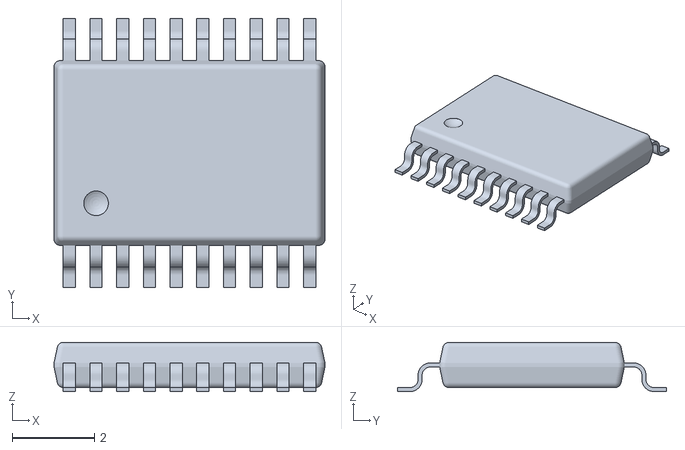
[picture p98: CAD file, 2014-12-09]
3D/ICs/TSSOP/STL/TSSOP-20.STL
6.60 x 6.55 x 1.20
