CascoLogix/KiCAD_Libraries/3D/ICs/VSON/STEP/VSON-10.step

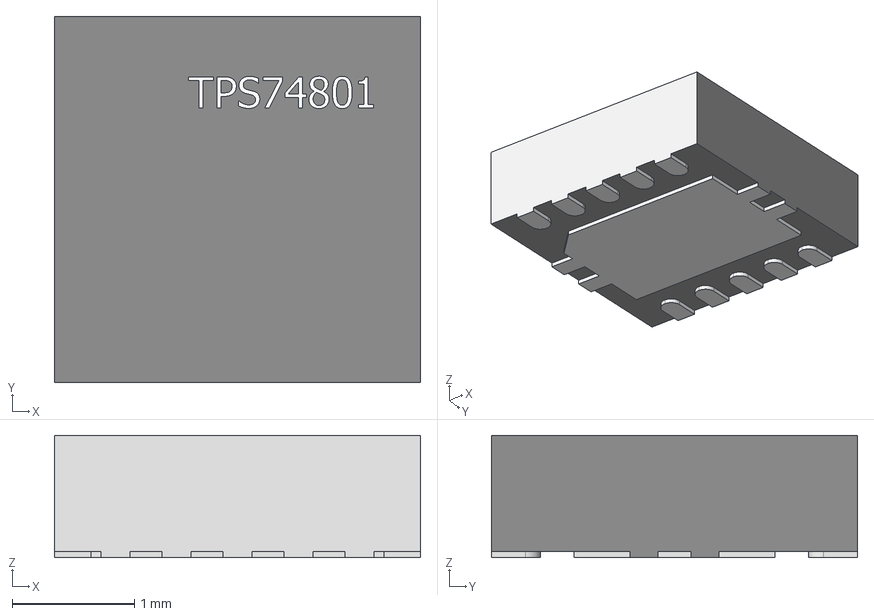
[picture p99: CAD file, 2020-01-19]
3D/ICs/VSON/STEP/VSON-10.step
3.00 x 3.00 x 1.00 mm
