CascoLogix/KiCAD_Libraries/3D/ICs/WSON/STEP/WSON-8_6x8mm_ep.step

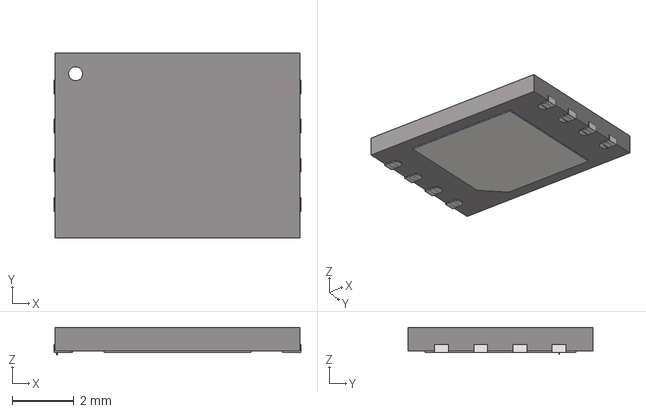
[picture p100: CAD file, 2020-02-19]
3D/ICs/WSON/STEP/WSON-8_6x8mm_ep.step
8.00 x 6.00 x 0.881 mm
