CascoLogix/KiCAD_Libraries/3D/LEDs/STEP/SFH_4770S2.step

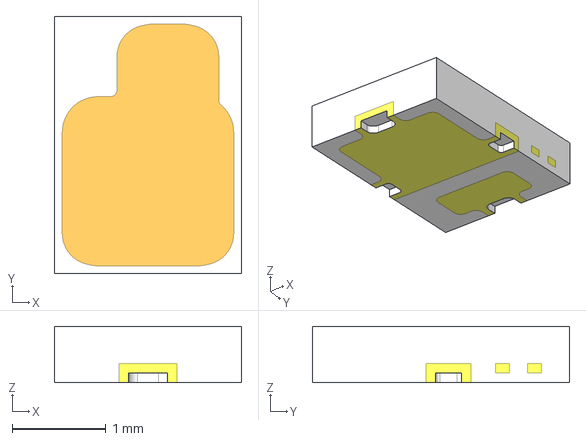
[picture p101: CAD file, 2025-10-27]
3D/LEDs/STEP/SFH_4770S2.step
2.00 x 2.75 x 0.599 mm
