CascoLogix/KiCAD_Libraries/3D/Modules/CAD/ArduinoMicro.SLDPRT

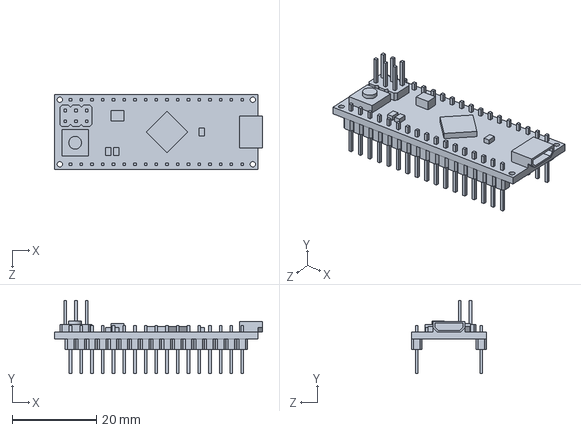
[picture p102: CAD file, 2016-06-28]
3D/Modules/CAD/ArduinoMicro.SLDPRT
49.3 x 17.3 x 17.8 mm
