CascoLogix/KiCAD_Libraries/3D/Modules/STEP/LeadShine_DM556.step

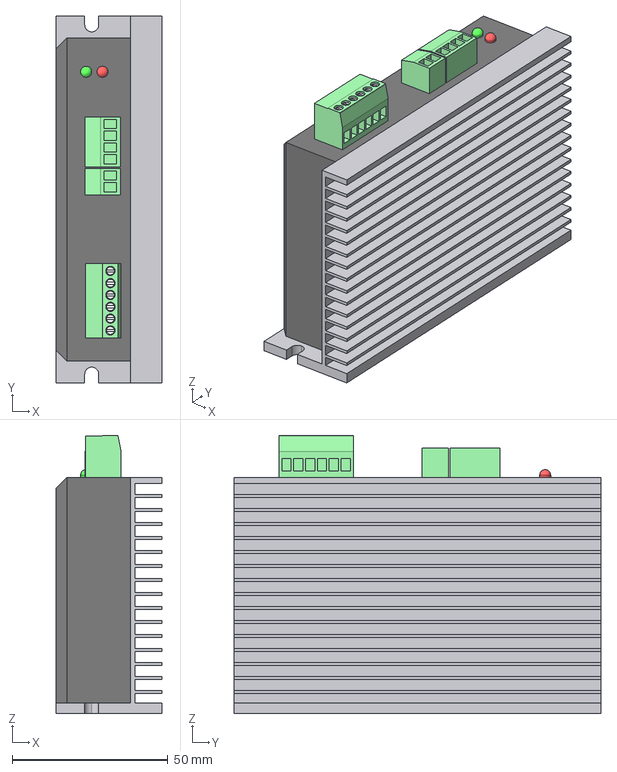
[picture p103: CAD file, 2025-10-27]
3D/Modules/STEP/LeadShine_DM556.step
34.0 x 118.0 x 89.5 mm
