CascoLogix/KiCAD_Libraries/3D/Other_Mechanical/STEP/Wurth_9774010243R_stand-off.step

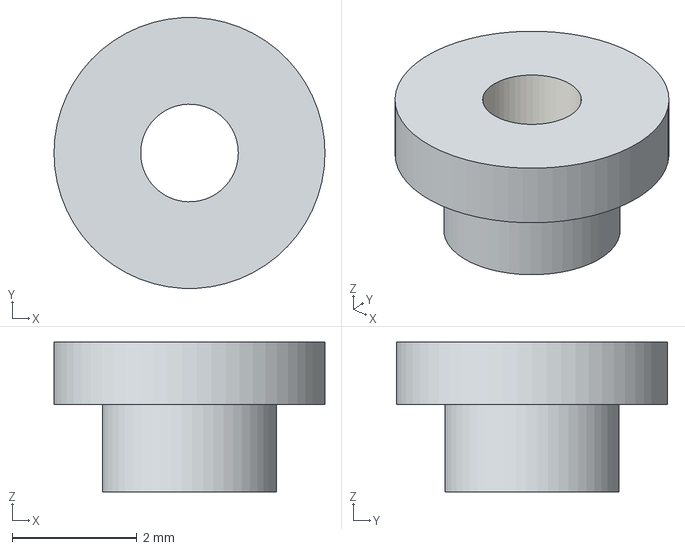
[picture p104: CAD file, 2025-10-27]
3D/Other_Mechanical/STEP/Wurth_9774010243R_stand-off.step
4.35 x 4.34 x 2.40 mm
