CascoLogix/KiCAD_Libraries/3D/Other_Mechanical/VRML/M12 lens holder.stl

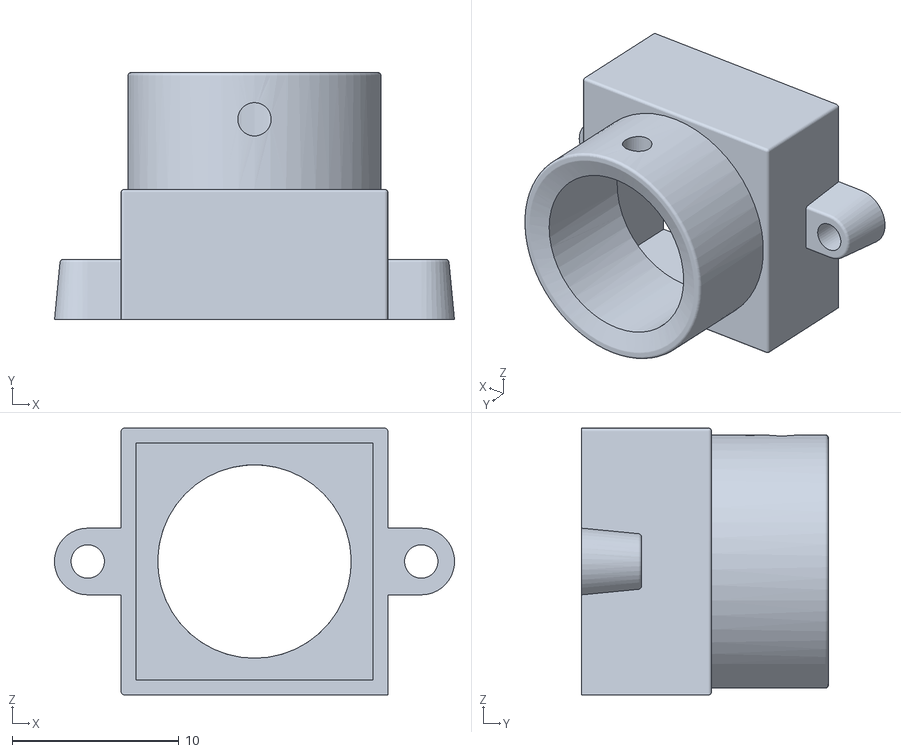
[picture p105: CAD file, 2018-07-14]
3D/Other_Mechanical/VRML/M12 lens holder.stl
24.0 x 14.8 x 16.0
