CascoLogix/KiCAD_Libraries/3D/Potentiometers/CAD/Bourns_3262W.SLDPRT

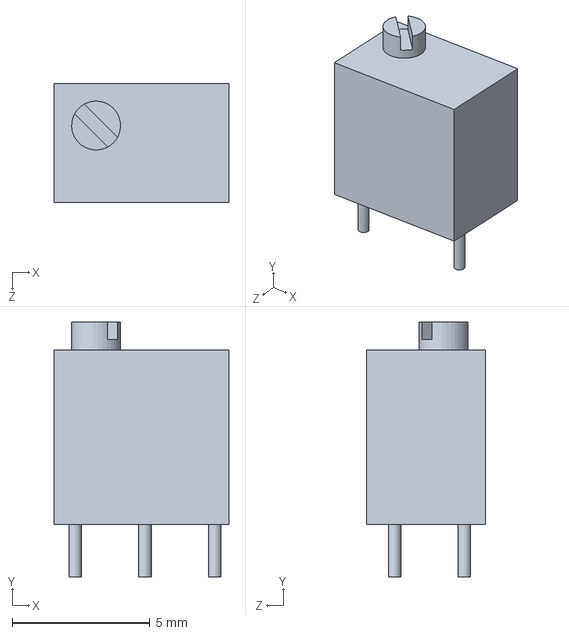
[picture p106: CAD file, 2013-10-21]
3D/Potentiometers/CAD/Bourns_3262W.SLDPRT
6.35 x 9.27 x 4.32 mm
