CascoLogix/KiCAD_Libraries/3D/Potentiometers/STEP/PSM050_Color.step

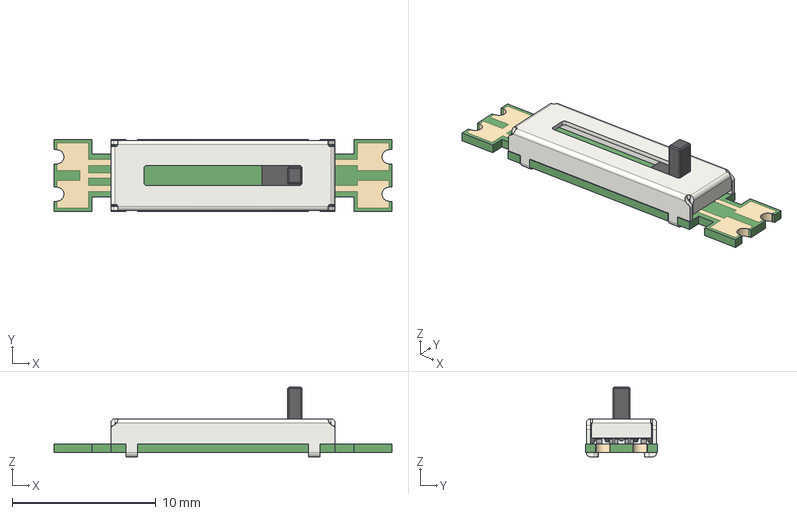
[picture p107: CAD file, 2020-09-20]
3D/Potentiometers/STEP/PSM050_Color.step
23.5 x 5.00 x 4.85 mm
