CascoLogix/KiCAD_Libraries/3D/Potentiometers/STL/POT_PVZ3A_SMT.STL

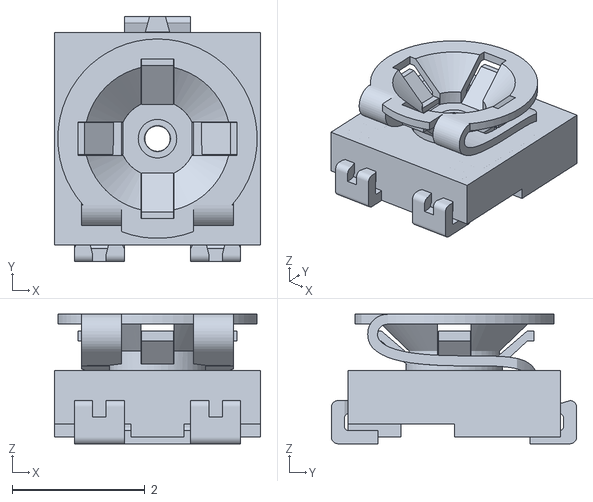
[picture p108: CAD file, 2014-12-09]
3D/Potentiometers/STL/POT_PVZ3A_SMT.STL
3.10 x 3.69 x 1.95
