CascoLogix/KiCAD_Libraries/3D/Power_Supplies/AC_DC_Converters/STEP/SHANBO_SHB-5W.STEP

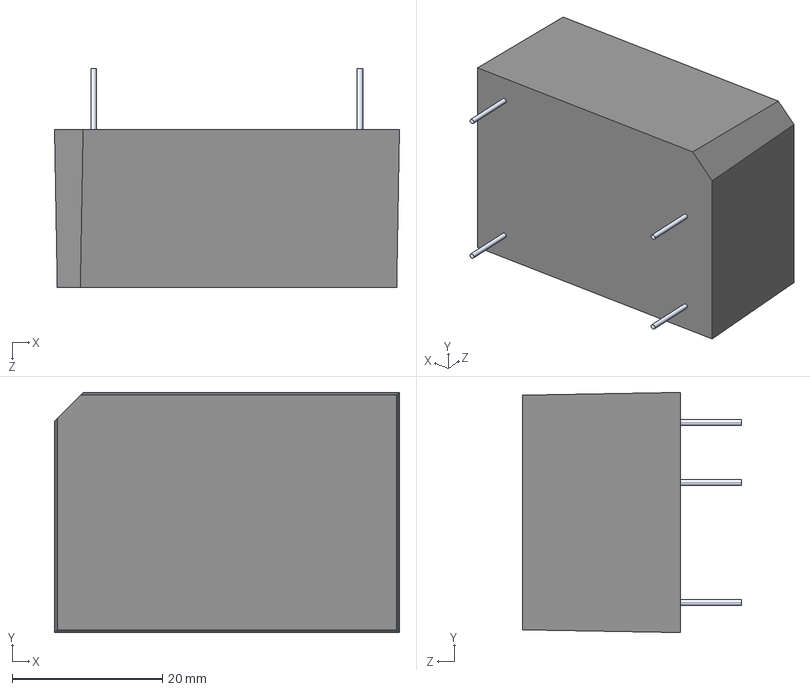
[picture p109: CAD file, 2016-09-16]
3D/Power_Supplies/AC_DC_Converters/STEP/SHANBO_SHB-5W.STEP
46.0 x 32.0 x 29.1 mm
