CascoLogix/KiCAD_Libraries/3D/Power_Supplies/DC_DC_Converters/STEP/CUI_V78E05-1000-SMT-TR.step

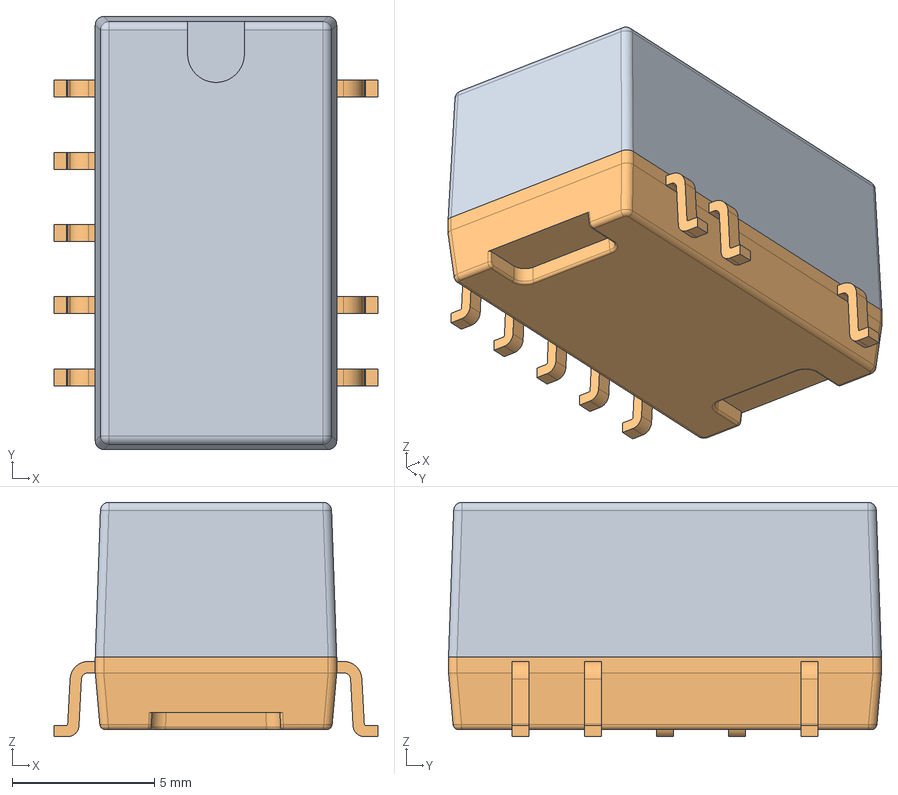
[picture p110: CAD file, 2021-08-24]
3D/Power_Supplies/DC_DC_Converters/STEP/CUI_V78E05-1000-SMT-TR.step
11.4 x 15.2 x 8.25 mm
