CascoLogix/KiCAD_Libraries/3D/RF_Modules/CAD/UBLOX_GPS_NEO-6M.SLDPRT

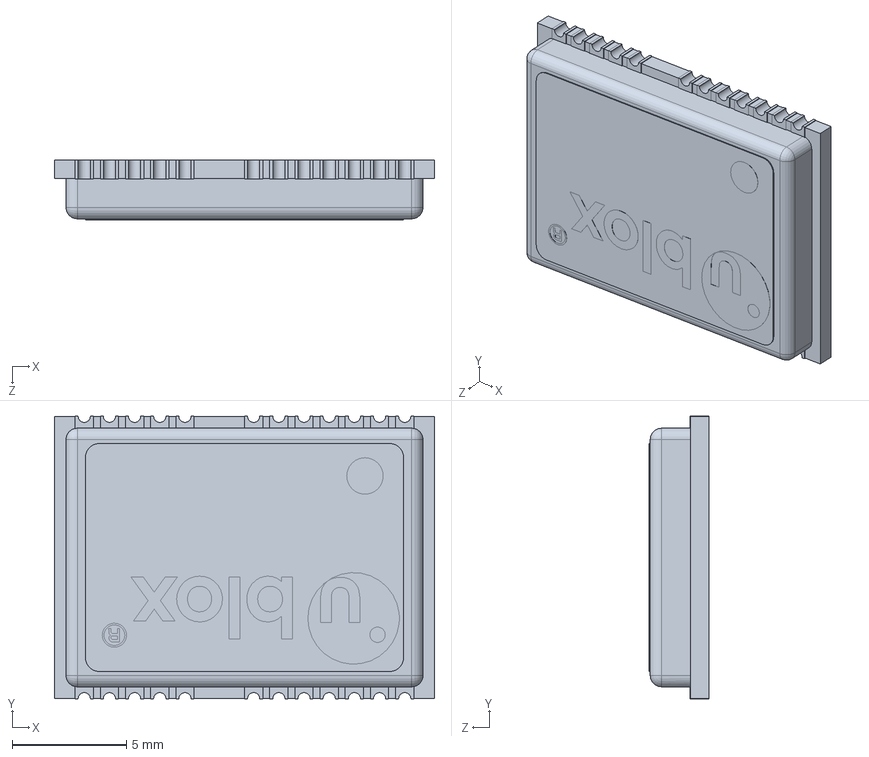
[picture p111: CAD file, 2016-06-28]
3D/RF_Modules/CAD/UBLOX_GPS_NEO-6M.SLDPRT
16.6 x 12.4 x 2.64 mm
