CascoLogix/KiCAD_Libraries/3D/RF_Modules/STEP/BC15E.stp

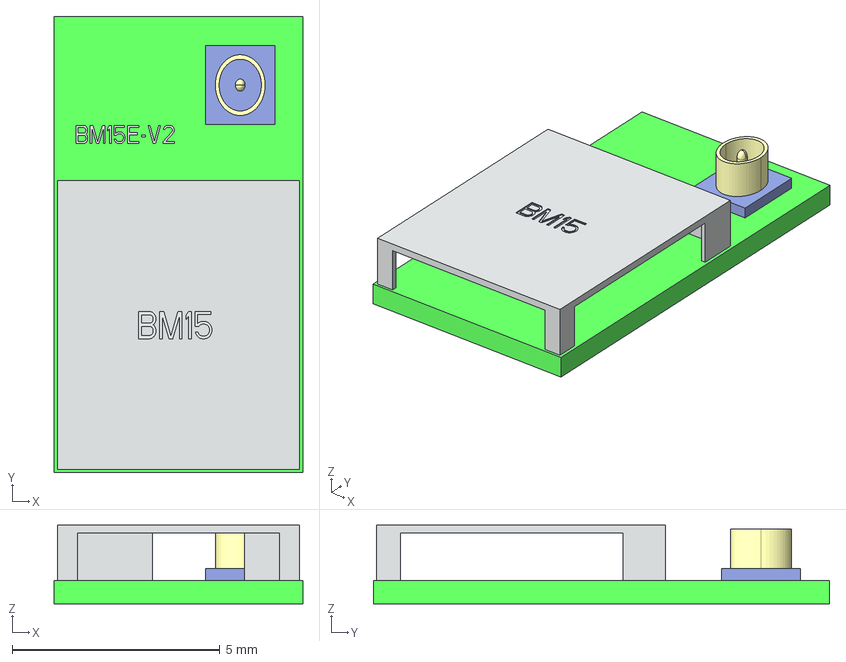
[picture p112: CAD file, 2026-10-30]
3D/RF_Modules/STEP/BC15E.stp
6.00 x 11.0 x 1.90 mm
Scale
Scale001
