CascoLogix/KiCAD_Libraries/3D/RF_Modules/STL/ESP-12.stl

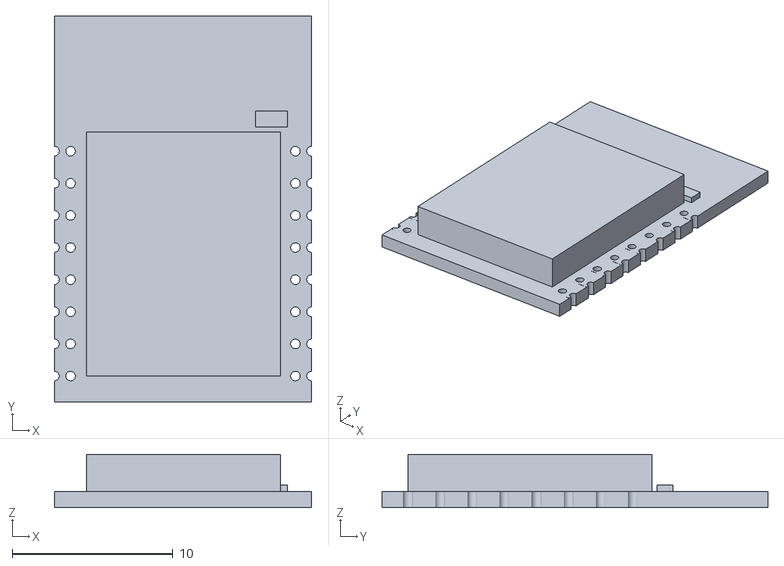
[picture p113: CAD file, 2016-09-21]
3D/RF_Modules/STL/ESP-12.stl
16.0 x 24.0 x 3.30
