CascoLogix/KiCAD_Libraries/3D/Sensors/Current_Sense/STL/Talema_AC1005.stl

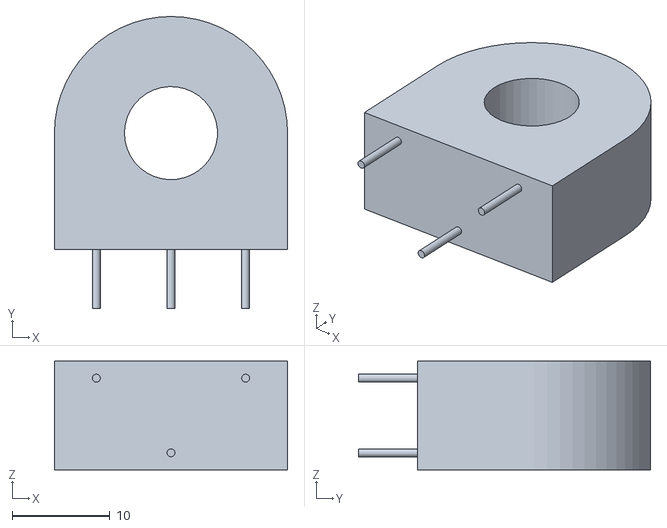
[picture p114: CAD file, 2015-03-11]
3D/Sensors/Current_Sense/STL/Talema_AC1005.stl
23.8 x 29.8 x 11.1
