CascoLogix/KiCAD_Libraries/3D/Terminal_Blocks/CAD/OSTVN08A150.SLDPRT

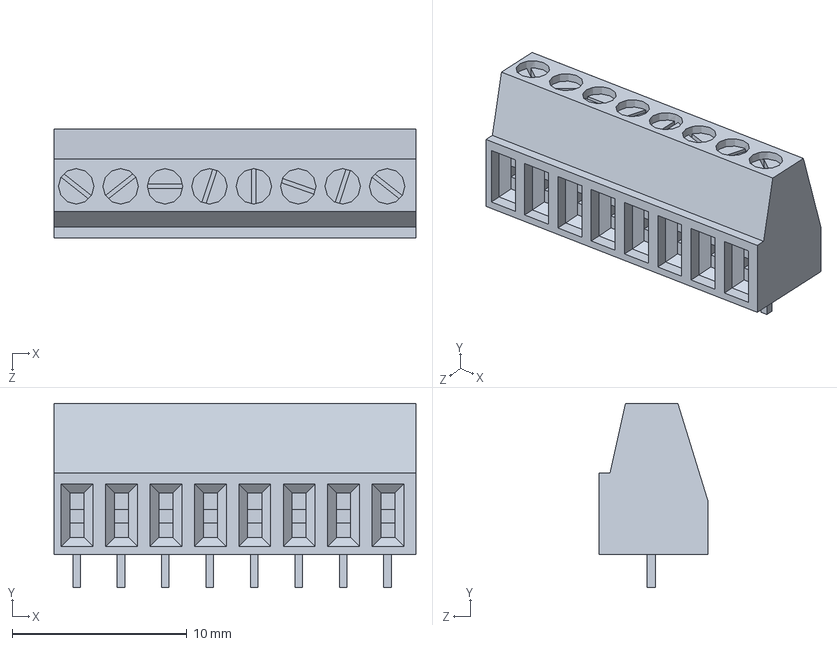
[picture p115: CAD file, 2016-01-23]
3D/Terminal_Blocks/CAD/OSTVN08A150.SLDPRT
20.7 x 10.5 x 6.22 mm
