CascoLogix/KiCAD_Libraries/3D/Terminal_Blocks/IGES/c-282834-8-c-3d.igs

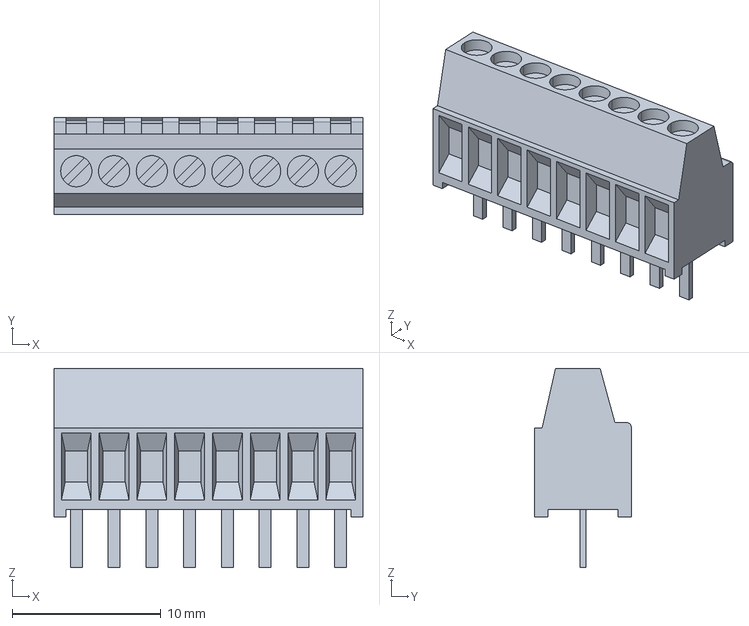
[picture p116: CAD file, 2012-10-09]
3D/Terminal_Blocks/IGES/c-282834-8-c-3d.igs
20.8 x 6.50 x 13.4 mm
