CascoLogix/KiCAD_Libraries/3D/Terminal_Blocks/STEP/Phoenix_1984769.stp

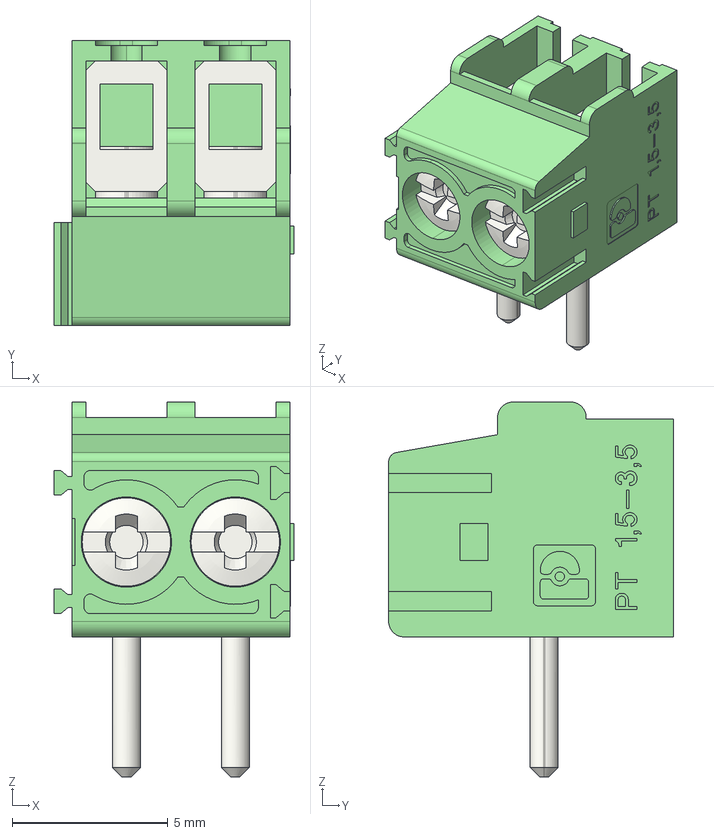
[picture p117: CAD file, 2026-10-30]
3D/Terminal_Blocks/STEP/Phoenix_1984769.stp
7.70 x 9.15 x 12.1 mm
