CascoLogix/KiCAD_Libraries/3D/Terminal_Blocks/STL/PTSA.stl

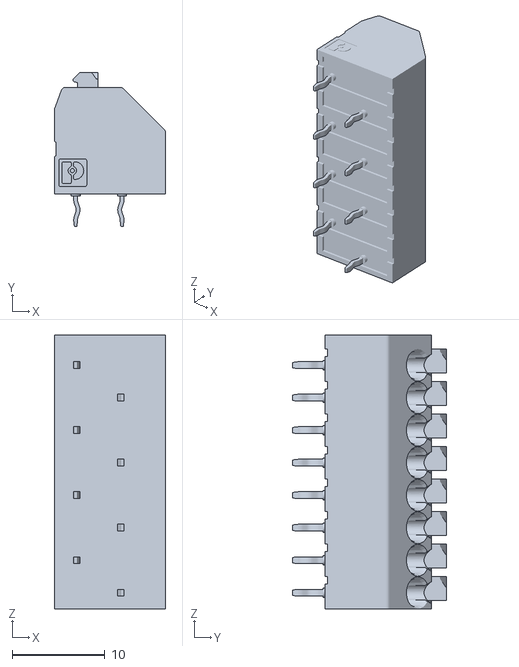
[picture p118: CAD file, 2016-09-16]
3D/Terminal_Blocks/STL/PTSA.stl
12.0 x 16.6 x 29.5
