CascoLogix/KiCAD_Libraries/3D/Test_Points/STEP/GSS-2-3.8-G.step

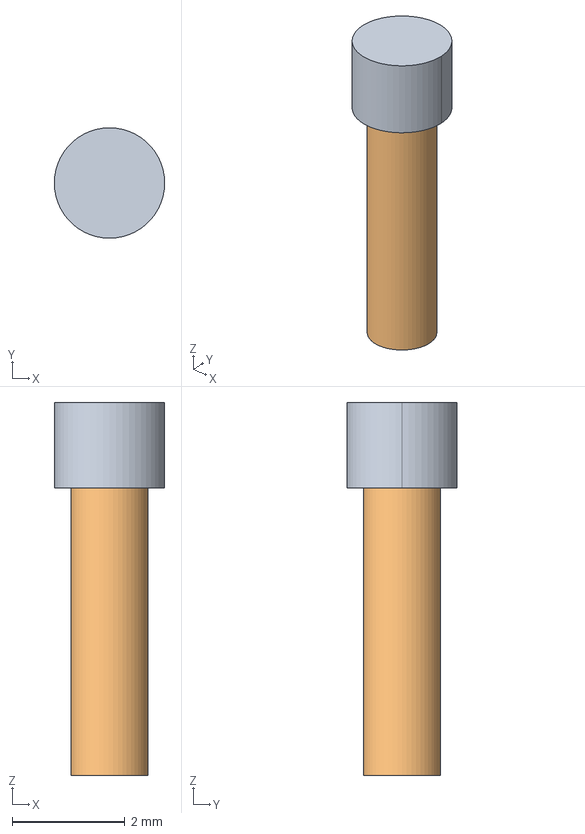
[picture p119: CAD file, 2021-03-02]
3D/Test_Points/STEP/GSS-2-3.8-G.step
1.96 x 1.96 x 6.62 mm
