CascoLogix/KiCAD_Libraries/3D/Transducers/CAD/PS1240P02BT.FCStd

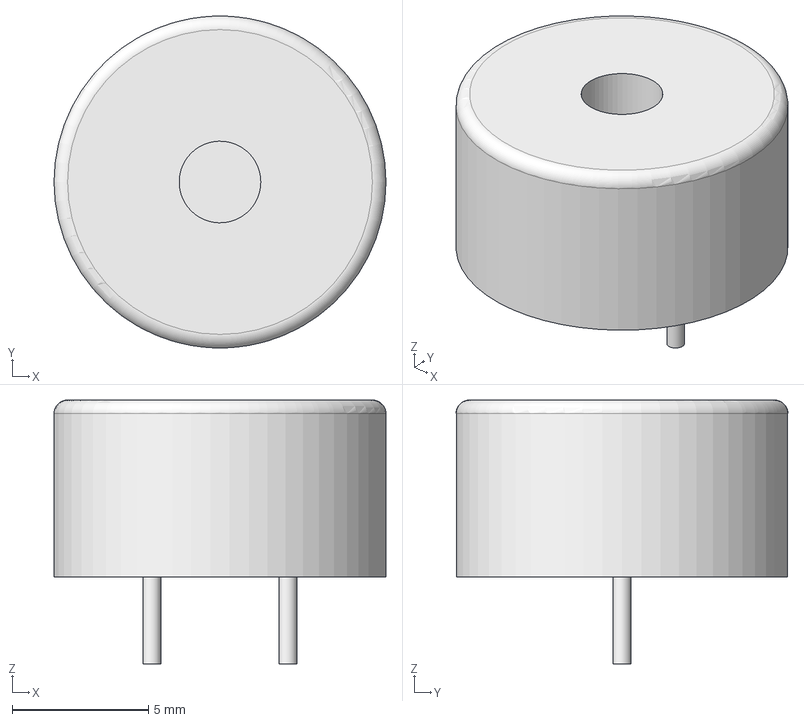
[picture p120: CAD file, 2014-12-10]
3D/Transducers/CAD/PS1240P02BT.FCStd
12.2 x 12.2 x 9.70 mm
