CascoLogix/KiCAD_Libraries/3D/Transformers/STEP/Coilcraft-YA912x-BE.step

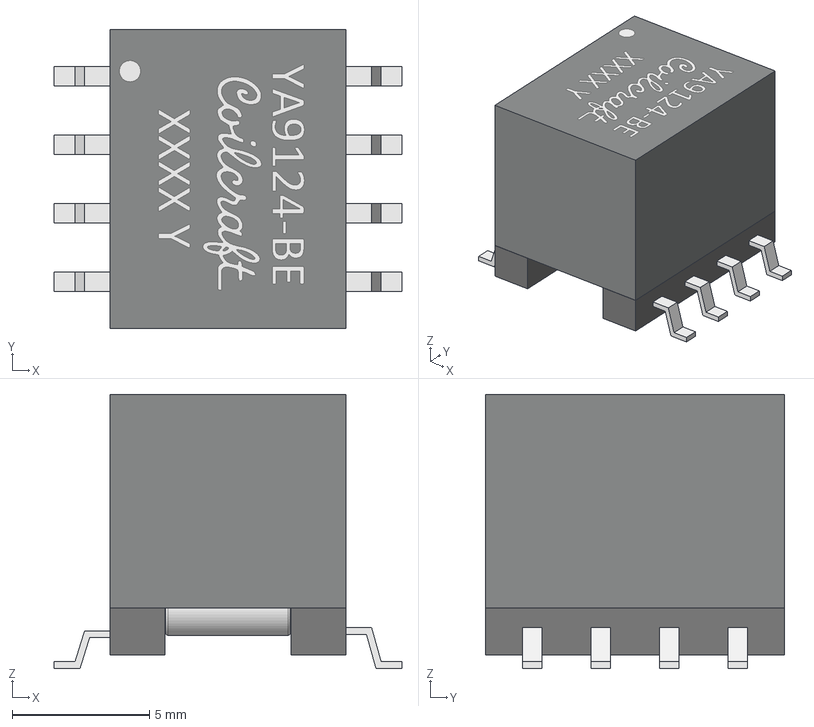
[picture p121: CAD file, 2020-11-11]
3D/Transformers/STEP/Coilcraft-YA912x-BE.step
12.7 x 10.9 x 10.0 mm
