CascoLogix/KiCAD_Libraries/3D/Batteries/CAD/D-cell battery.SLDPRT

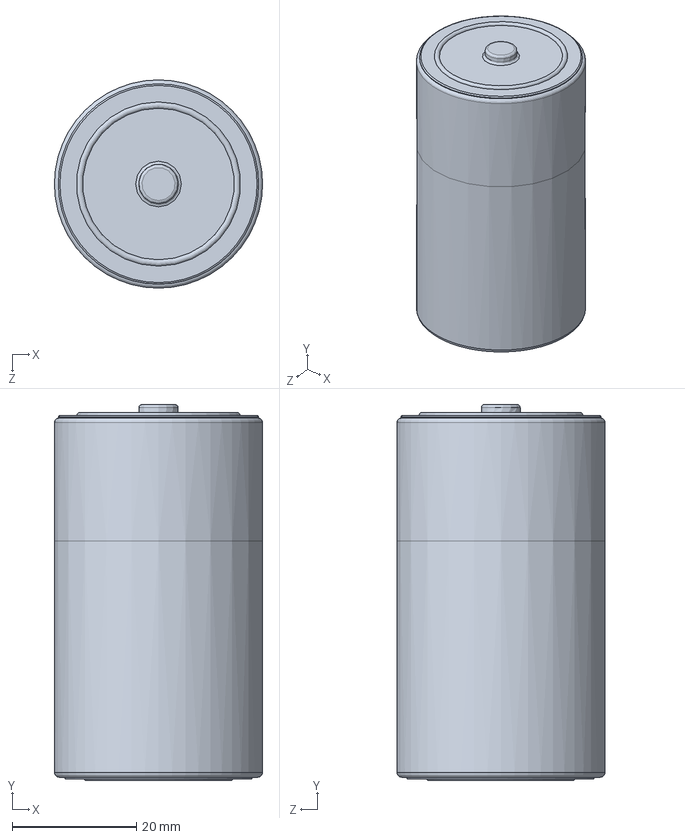
[picture p122: CAD file, 2016-09-16]
3D/Batteries/CAD/D-cell battery.SLDPRT
33.5 x 60.5 x 33.5 mm
