CascoLogix/KiCAD_Libraries/3D/Battery_Holders/CAD/BHC-2-Base.SLDPRT

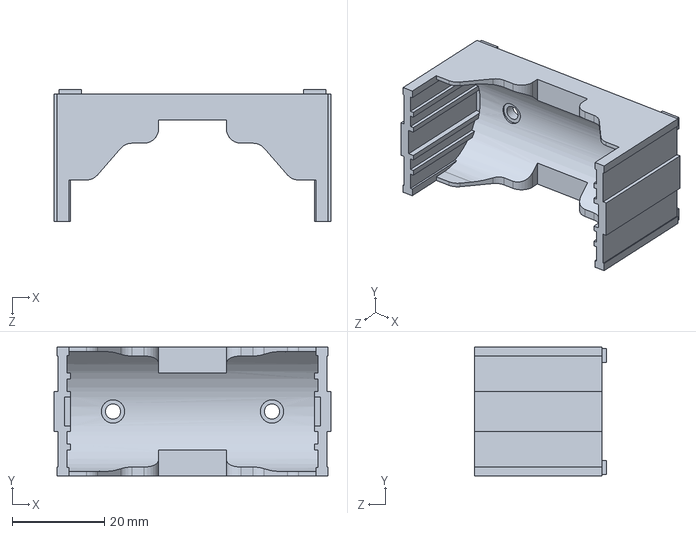
[picture p123: CAD file, 2016-09-24]
3D/Battery_Holders/CAD/BHC-2-Base.SLDPRT
60.2 x 27.9 x 28.7 mm
