CascoLogix/KiCAD_Libraries/3D/Battery_Holders/STEP/keystone-PN1056.step

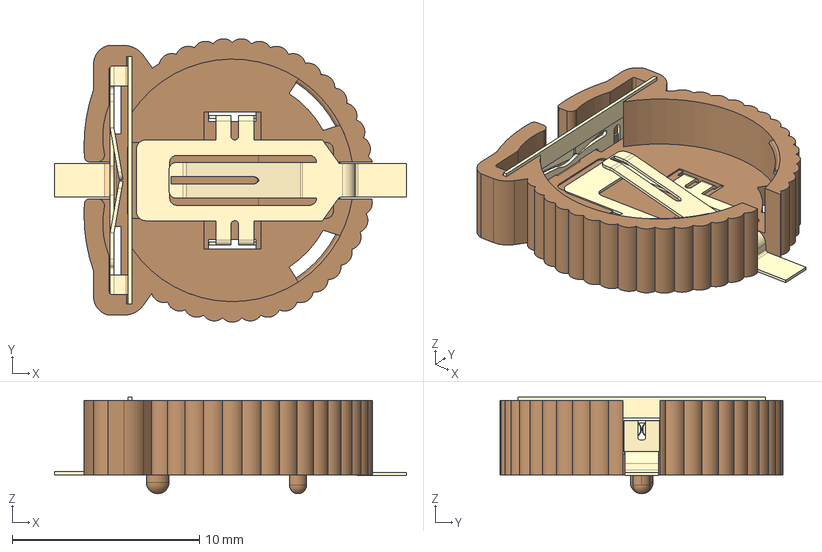
[picture p124: CAD file, 2020-03-16]
3D/Battery_Holders/STEP/keystone-PN1056.step
18.8 x 15.1 x 5.16 mm
