CascoLogix/KiCAD_Libraries/3D/Battery_Holders/STL/Keystone_594.STL

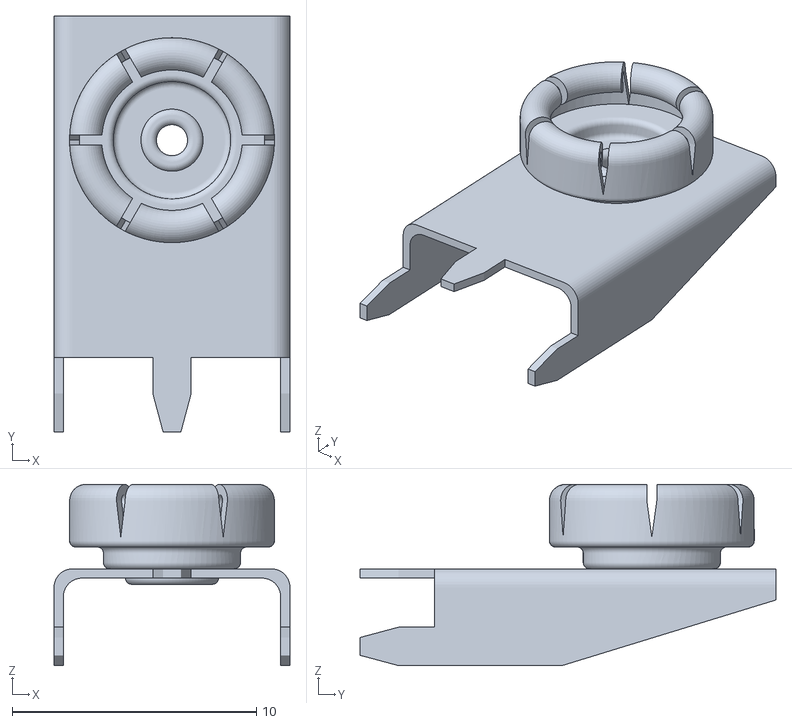
[picture p125: CAD file, 2016-01-23]
3D/Battery_Holders/STL/Keystone_594.STL
9.65 x 17.0 x 7.42
