CascoLogix/KiCAD_Libraries/3D/Connectors/DB/CAD/CONNECTOR_DB9_RA_M_PTH_GENERIC.SLDPRT

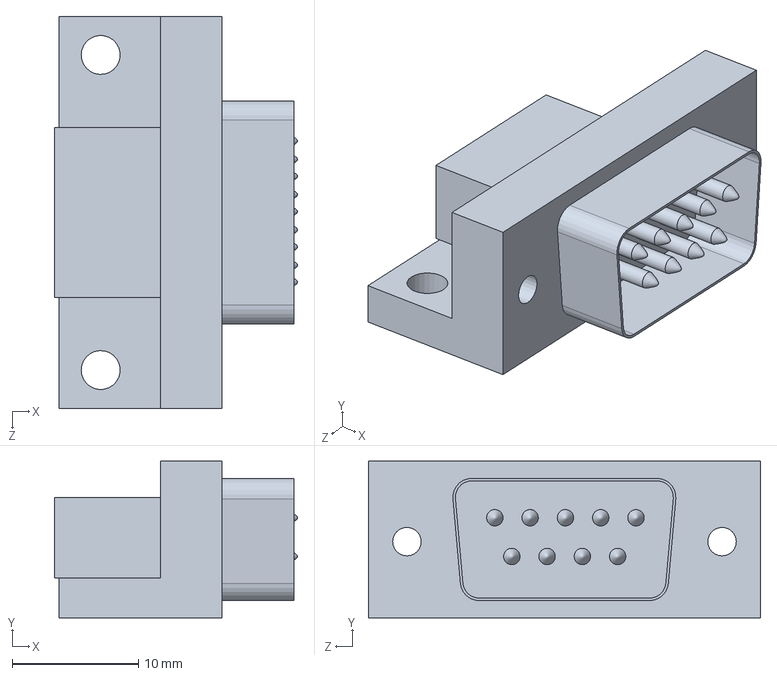
[picture p126: CAD file, 2013-10-21]
3D/Connectors/DB/CAD/CONNECTOR_DB9_RA_M_PTH_GENERIC.SLDPRT
19.3 x 12.4 x 31.1 mm
