CascoLogix/KiCAD_Libraries/3D/Connectors/FFC/STEP/Molex_524372771.stp

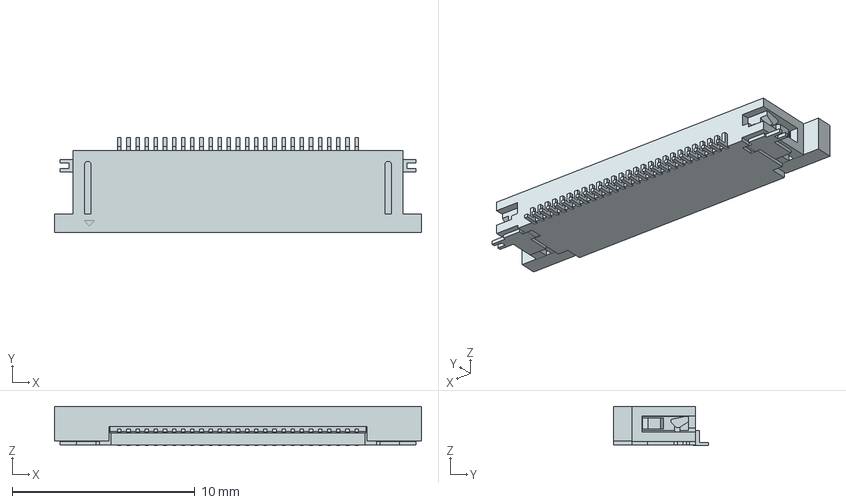
[picture p127: CAD file, 2026-10-30]
3D/Connectors/FFC/STEP/Molex_524372771.stp
20.1 x 5.20 x 2.16 mm
