CascoLogix/KiCAD_Libraries/3D/Connectors/FFC/STL/ffc_fpc_affc07-14-100-shb-t.stl

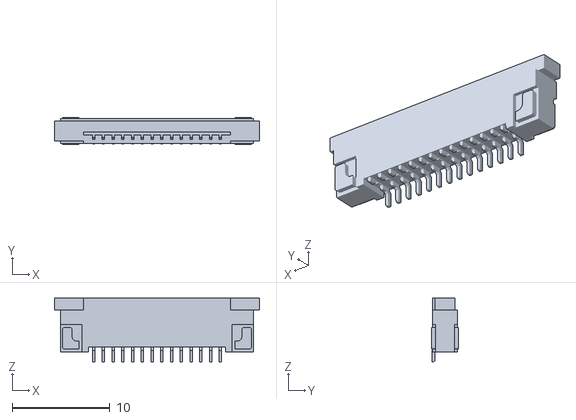
[picture p128: CAD file, 2014-12-09]
3D/Connectors/FFC/STL/ffc_fpc_affc07-14-100-shb-t.stl
21.0 x 2.80 x 6.51
