CascoLogix/KiCAD_Libraries/3D/Connectors/JST/STEP/S2B-PH-SM4_white.step

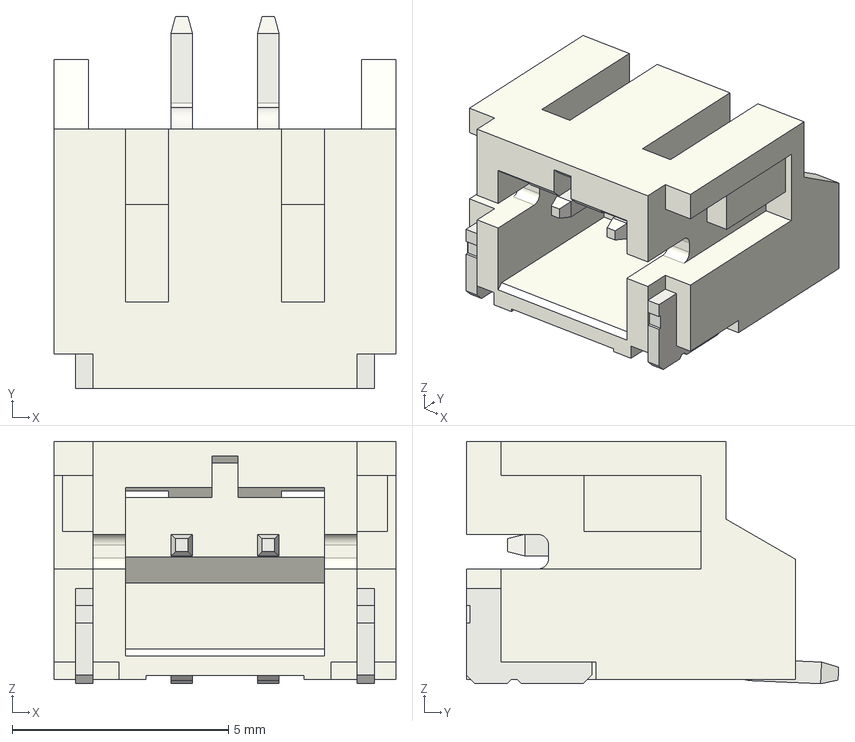
[picture p129: CAD file, 2025-10-27]
3D/Connectors/JST/STEP/S2B-PH-SM4_white.step
7.90 x 8.60 x 5.60 mm
