CascoLogix/KiCAD_Libraries/3D/Connectors/Power/STEP/Molex_2053380006.step

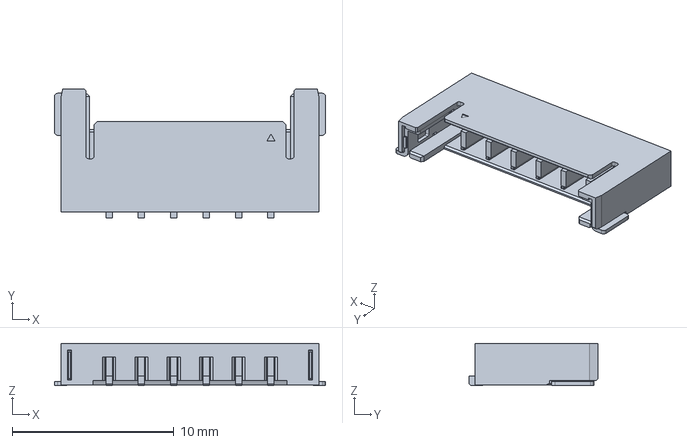
[picture p130: CAD file, 2025-10-27]
3D/Connectors/Power/STEP/Molex_2053380006.step
16.8 x 7.95 x 2.60 mm
