CascoLogix/KiCAD_Libraries/3D/Connectors/Quick-Fit/CAD/CONNECTOR_QUICK_FIT_RA_V_M_PTH_KEYSTONE_1266.SLDPRT

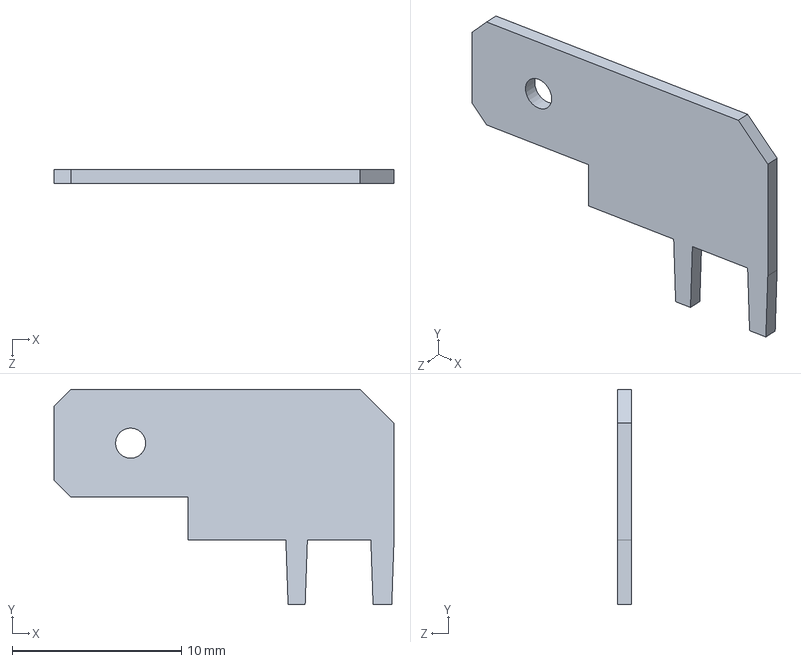
[picture p131: CAD file, 2013-10-21]
3D/Connectors/Quick-Fit/CAD/CONNECTOR_QUICK_FIT_RA_V_M_PTH_KEYSTONE_1266.SLDPRT
20.1 x 12.7 x 0.81 mm
