CascoLogix/KiCAD_Libraries/3D/Connectors/RF/CAD/Samtec-SMA-J-P-H-RA-TH1.SLDPRT

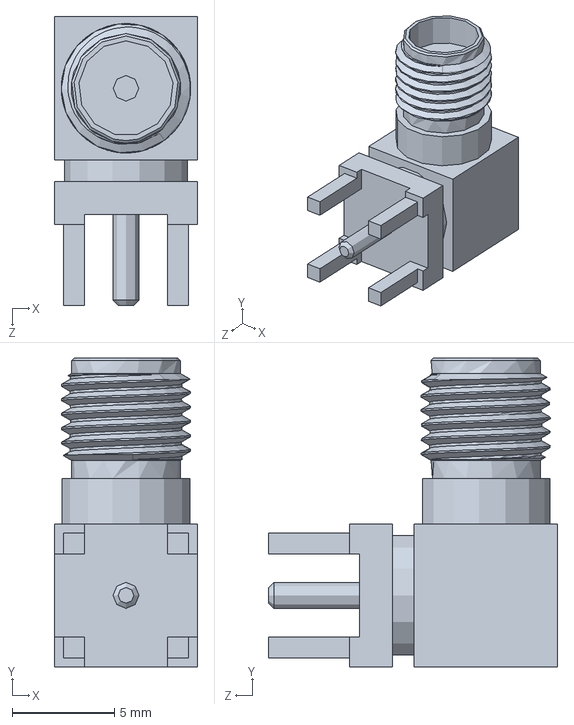
[picture p132: CAD file, 2016-09-16]
3D/Connectors/RF/CAD/Samtec-SMA-J-P-H-RA-TH1.SLDPRT
7.00 x 15.1 x 14.1 mm
