CascoLogix/KiCAD_Libraries/3D/Connectors/RJ-45/STEP/Wurth_Electronics_74984104400.step

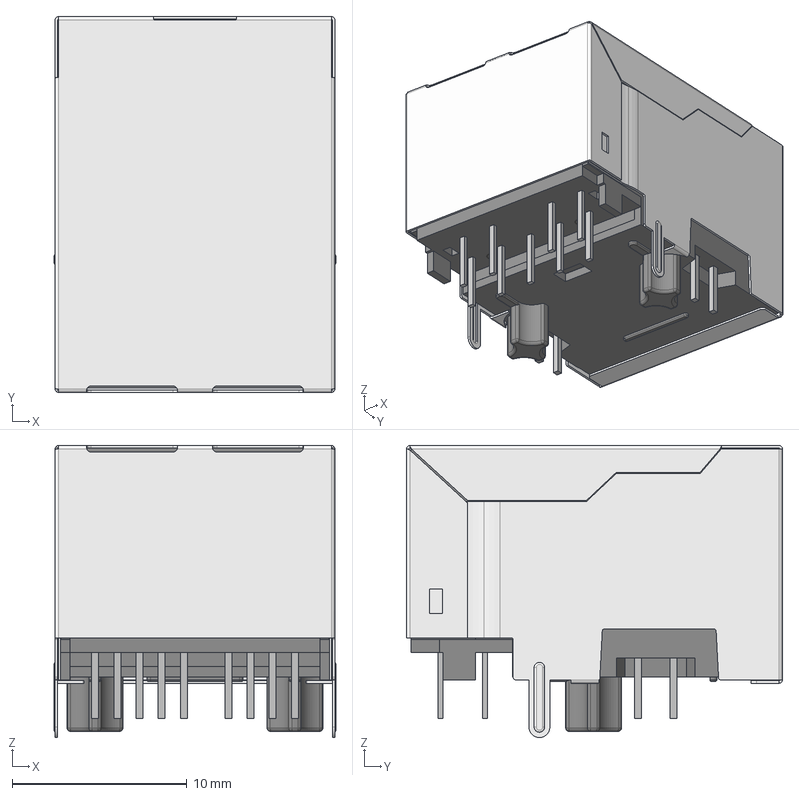
[picture p133: CAD file, 2020-01-24]
3D/Connectors/RJ-45/STEP/Wurth_Electronics_74984104400.step
16.1 x 21.5 x 16.7 mm
