CascoLogix/KiCAD_Libraries/3D/Connectors/Samtec/CJT/STEP/CJT-T-P-XX-ST-TH1.step

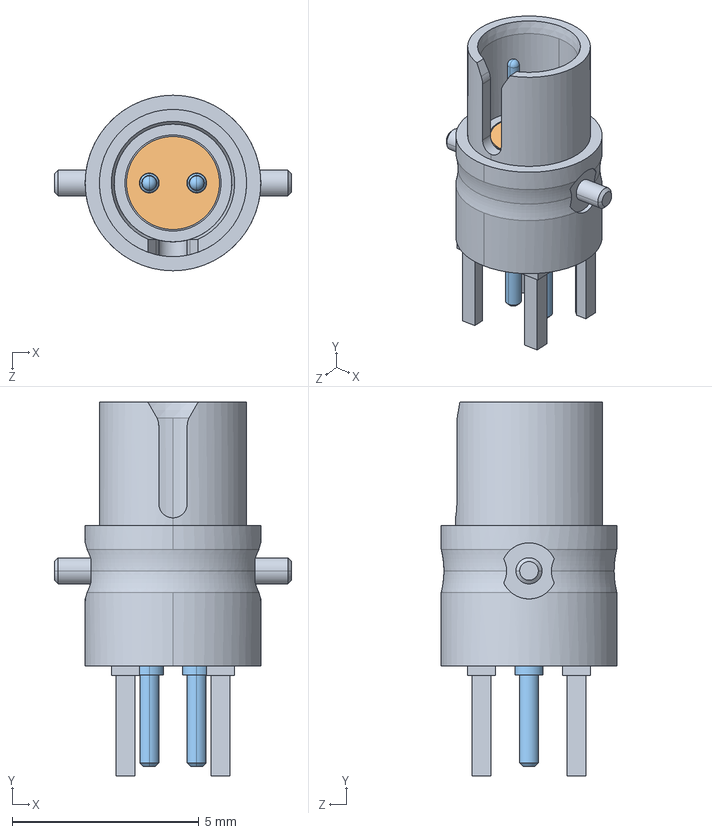
[picture p134: CAD file, 2013-10-21]
3D/Connectors/Samtec/CJT/STEP/CJT-T-P-XX-ST-TH1.step
6.35 x 10.0 x 4.70 mm
CJT-T-P-X-ST-TH1-SHL_vertical conn
CJT-INS-001
CJT-T-P-X-ST-TH1-PIN x 2
