CascoLogix/KiCAD_Libraries/3D/Connectors/Samtec/ERF8/STEP/ERF8-010-02.0-X-DV-K-BASIC.step

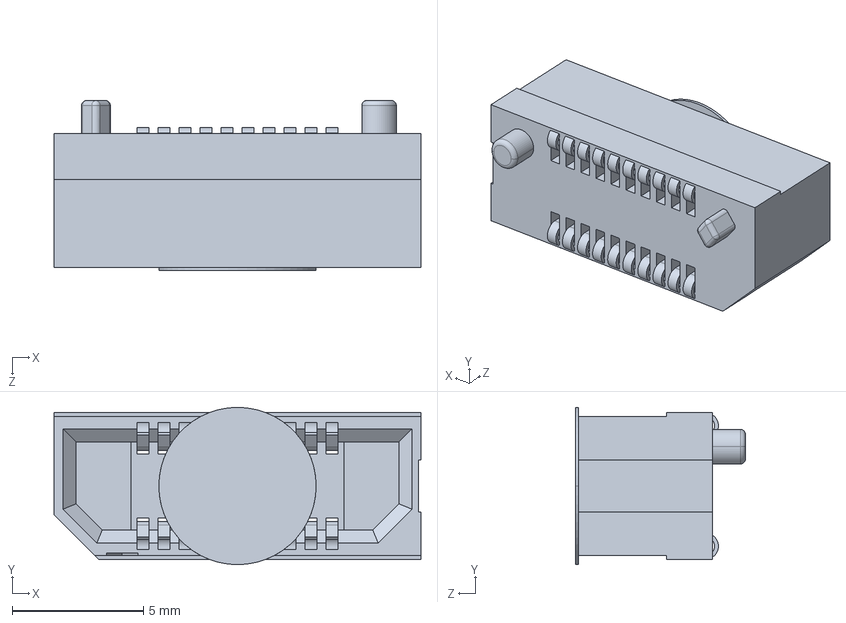
[picture p135: CAD file, 2013-10-21]
3D/Connectors/Samtec/ERF8/STEP/ERF8-010-02.0-X-DV-K-BASIC.step
14.0 x 6.00 x 6.49 mm
