CascoLogix/KiCAD_Libraries/3D/Connectors/Samtec/IPBT/STEP/IPBT-103-H1-X-D-RA.step

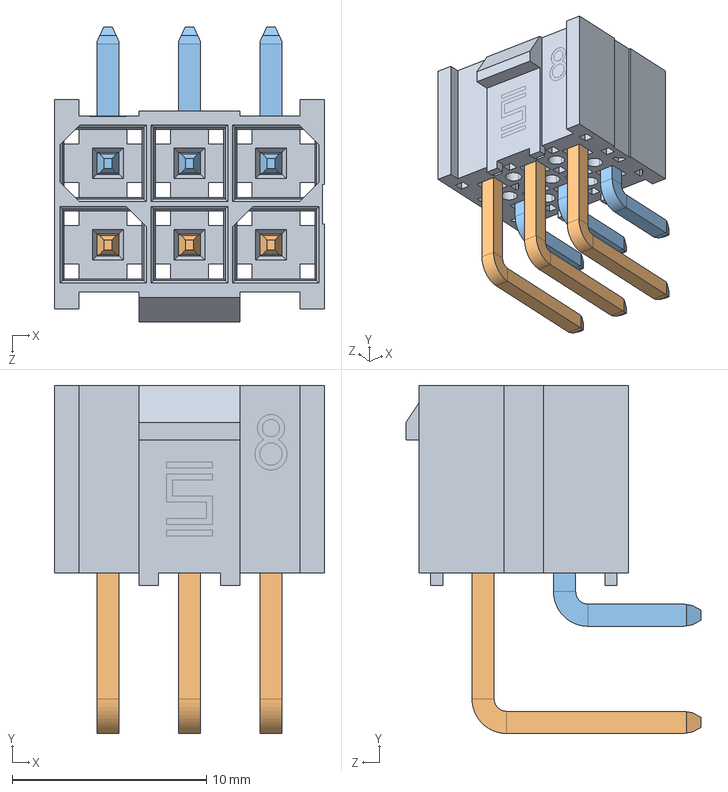
[picture p136: CAD file, 2013-10-21]
3D/Connectors/Samtec/IPBT/STEP/IPBT-103-H1-X-D-RA.step
13.9 x 17.9 x 15.2 mm
IPBT-XX-D-XX_Customer Model
T-1S55-X_-01 RA (IPBT-RA 2nd row pin) x 3
T-1S55-X_-01 RA (IPBT-RA 1st row pin) x 3
