CascoLogix/KiCAD_Libraries/3D/Connectors/USB/CAD/CONNECTOR_USB_TYPE_MICRO_B_RA_F_SMT.SLDPRT

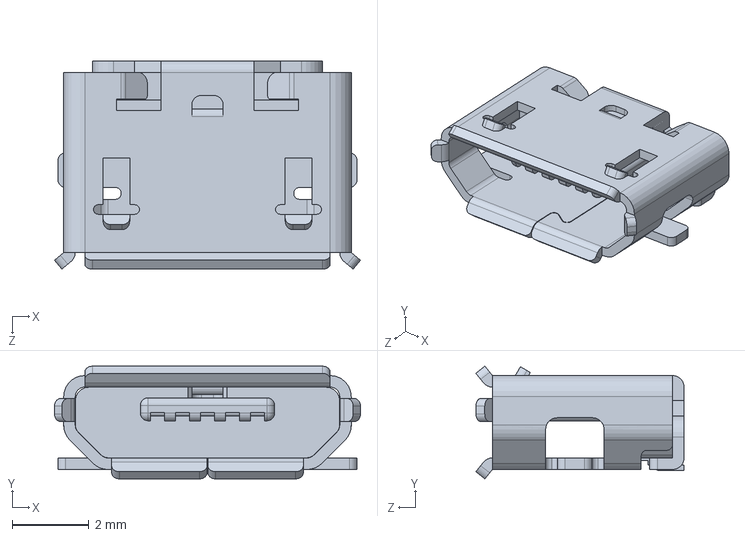
[picture p137: CAD file, 2013-10-21]
3D/Connectors/USB/CAD/CONNECTOR_USB_TYPE_MICRO_B_RA_F_SMT.SLDPRT
7.98 x 2.94 x 5.43 mm
