CascoLogix/KiCAD_Libraries/3D/Connectors/USB/STEP/MICRO_USB_VERT_SMT.step

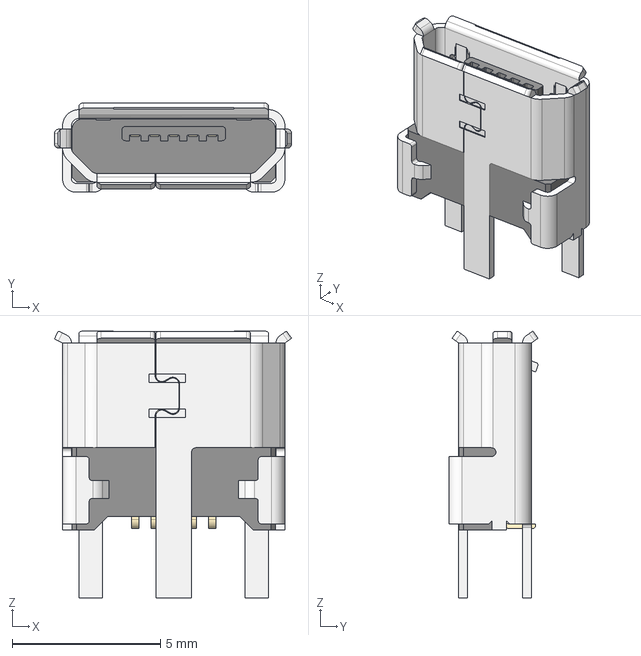
[picture p138: CAD file, 2021-02-10]
3D/Connectors/USB/STEP/MICRO_USB_VERT_SMT.step
8.00 x 3.01 x 9.01 mm
