CascoLogix/KiCAD_Libraries/3D/Connectors/USB/STL/CONNECTOR_USB_TYPE_A_RA_F_SMT.STL

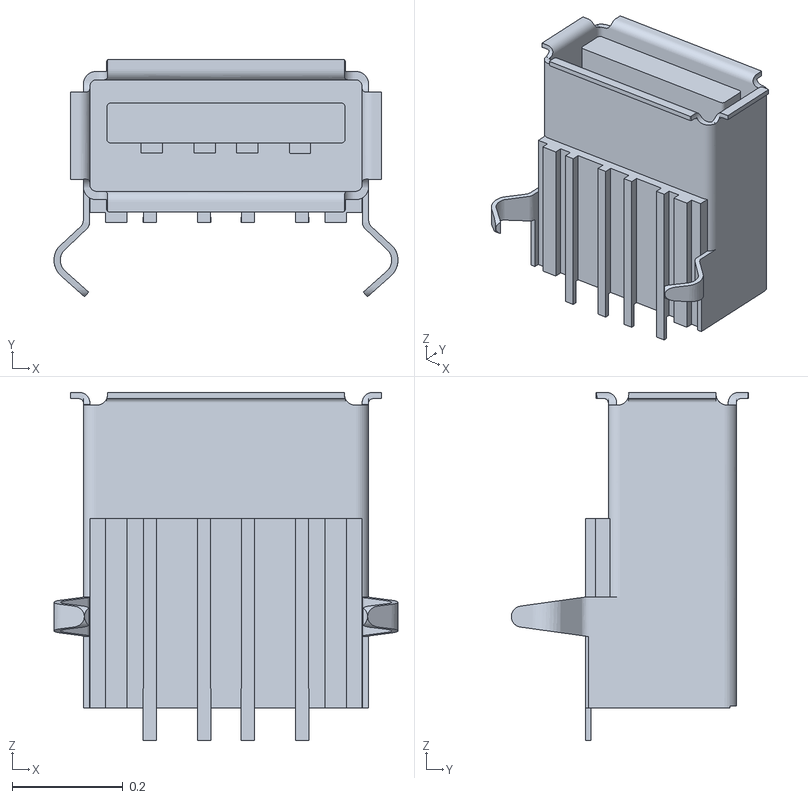
[picture p139: CAD file, 2013-10-21]
3D/Connectors/USB/STL/CONNECTOR_USB_TYPE_A_RA_F_SMT.STL
0.622 x 0.429 x 0.63
