CascoLogix/KiCAD_Libraries/3D/Discrete/Active/STEP/TO-263-3.step

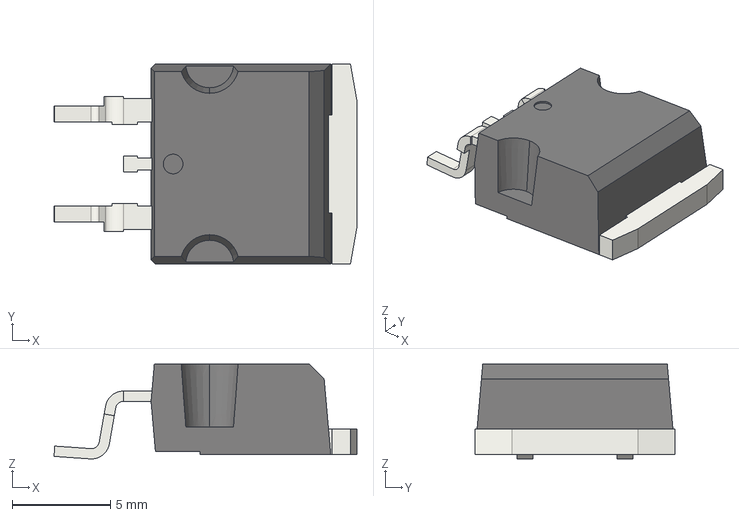
[picture p140: CAD file, 2025-10-27]
3D/Discrete/Active/STEP/TO-263-3.step
15.4 x 10.2 x 4.83 mm
