CascoLogix/KiCAD_Libraries/3D/Discrete/Passive/Capacitors/STEP/CL_series_size8x10.step

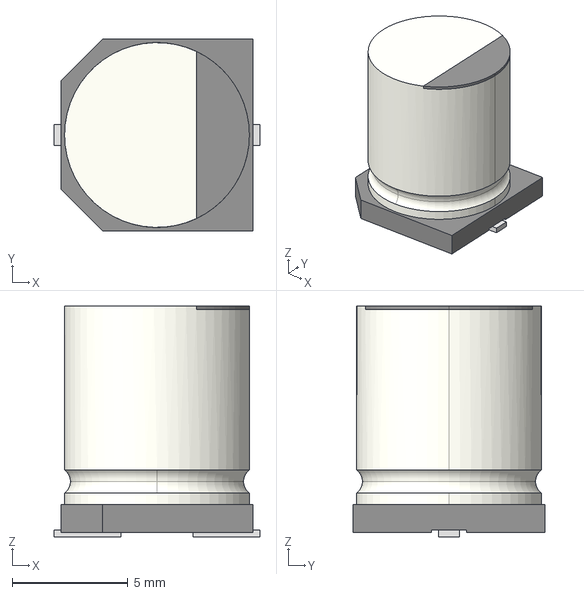
[picture p141: CAD file, 2021-02-10]
3D/Discrete/Passive/Capacitors/STEP/CL_series_size8x10.step
8.90 x 8.30 x 10.0 mm
