CascoLogix/KiCAD_Libraries/(list of files, cad)

Other CAD files:
3D/Connectors/Samtec/CJT/CAD/SUB-CJT-T-P-XX-RA-BH1_Process 3.sldasm
3D/Connectors/Samtec/ERCD/CAD/ERCD-010-TEU-S-1.SLDASM
3D/Connectors/Samtec/ERCD/CAD/ERCD ERM8-XXX-X-D-EMX-XX-ASM_20 POS -EM -B.sldasm
3D/Connectors/Samtec/ERCD/CAD/ERCD-XXX-XX.XX-XXX-XXX-X-X_20 POS STR TO TEU.sldasm
3D/Connectors/Samtec/CJT/CAD/SMA-LWAS-001-X.sldprt
3D/Connectors/Samtec/ERCD/CAD/ERCD Dowel Pin.sldprt
3D/Connectors/Samtec/ERF8/CAD/C3D-WT-30-XX-X_1.sldprt
3D/Connectors/Samtec/IPBT/CAD/T-1S55-X_-01 RA (IPBT-RA 2nd row pin)_1.sldprt
3D/Electromechanical/Pushbuttons/IGES/FSMSM.igs
3D/ICs/SOT/CAD/SOT-23-5_pin_SOT_sot-23-6_1.sldprt
3D/Connectors/Quick-Fit/STL/Keystone_3528.STL
3D/Connectors/RF/STEP/UFL-R-SMT.step
3D/Connectors/Samtec/CJT/CAD/CJT-BDY-001-X_RA VERSION_1.sldprt
3D/Connectors/Samtec/ERCD/CAD/ERCD T-1M47-XX-X_.062 PCB.sldprt
3D/Connectors/Samtec/ERF8/CAD/ERF8-XXX-XX.X-DV-XXXX_-05 30 pos_1.sldprt
3D/Connectors/Samtec/IPBT/CAD/IPBT-XX-D-XX_Customer Model.sldprt
3D/RF_Modules/CAD/ESP-07v2.scad
3D/RF_Modules/CAD/ESP-12.scad
3D/RF_Modules/CAD/ESP-13-wroom-02.scad
3D/Batteries/CAD/AAA Battery.SLDPRT
3D/Batteries/CAD/Battery.SLDPRT
3D/Batteries/CAD/Battery_CR2032.SLDPRT
3D/Batteries/CAD/C-Size Battery.SLDPRT
3D/Batteries/CAD/CR1025 3V Cell.SLDPRT
3D/Batteries/CAD/CR123A 3V.SLDPRT
3D/Batteries/CAD/CR14505BL-VB.SLDPRT
3D/Batteries/CAD/ER14250.sldasm
3D/Batteries/CAD/ER14250_Cono.sldprt
3D/Batteries/CAD/ER14250_Fillet.sldprt
3D/Batteries/CAD/ER14250_Fillet001.sldprt
3D/Batteries/CAD/ER14250_Fillet002.sldprt
3D/Batteries/CAD/ER14250_Fillet003.sldprt
3D/Batteries/CAD/LSH 20.SLDPRT
3D/Batteries/CAD/Panasonic BR-2.SLDPRT
3D/Batteries/CAD/SAFT_AA.SLDPRT
3D/Battery_Holders/CAD/BHC-2-Assy-wCell.SLDPRT
3D/Battery_Holders/CAD/BHC-2-Assy.SLDPRT
3D/Battery_Holders/CAD/BHC-2-Cell.SLDPRT
3D/Battery_Holders/CAD/User Library-3002.SLDPRT
3D/Battery_Holders/CAD/User Library-9V Duracell Battery.SLDPRT
3D/Battery_Holders/CAD/User Library-keystone 3012-3013THROUGH HOLE.SLDPRT
3D/Battery_Holders/CAD/keystone-PN2462.SLDPRT
3D/Battery_Holders/STEP/BHC-2.STEP
3D/Battery_Holders/STEP/BHC-2_CELL.STEP
3D/Battery_Holders/STEP/BHCL.STEP
3D/Battery_Holders/STEP/BHCW.STEP
3D/Battery_Holders/STEP/keystone-PN2462.STEP
3D/Battery_Holders/STL/BK-912_SMT.STL
3D/Battery_Holders/STL/Keystone 3012-3013.STL
3D/Battery_Holders/STL/Keystone_593.STL
3D/Battery_Holders/STL/Memory_Protection_Devices_BC9VPC.STL
3D/Connectors/2041021-4.SLDPRT
3D/Connectors/DB/STL/CONNECTOR_DB9_RA_M_PTH_GENERIC.stl
3D/Connectors/FFC/STEP/C-1734592-8.step
3D/Connectors/FFC/STEP/C-2-1734592-0.step
3D/Connectors/FFC/STEP/GCT_FFC2A33-05-G-L.stp
3D/Connectors/FFC/STEP/GCT_FFC2A33-05-G-R.stp
3D/Connectors/FFC/STEP/GCT_FFC2A33-27-G-R.stp
3D/Connectors/FFC/STEP/ISFV15R_2STLF.step
3D/Connectors/FFC/STEP/Molex_54132-5033.step
3D/Connectors/FFC/STEP/SFV20R-2STE1HLF.step
3D/Connectors/FFC/STEP/SFW22R-1STE1LF.step
3D/Connectors/FFC/STEP/SFW_R-2ST_LF.step
3D/Connectors/FFC/STL/ffc_fpc_affc10-14-100-svs-t.stl
3D/Connectors/HDMI/STEP/471511051.step
3D/Connectors/JST/STEP/B4B-PH-K-S.step
3D/Connectors/JST/STEP/B4B-PH-SM4-TB.STEP
3D/Connectors/JST/STEP/B6B-PH-K-S.step
3D/Connectors/JST/STEP/JST_BM06B-SRSS-TB.step
3D/Connectors/JST/STEP/S3B-EH_Blue.step
3D/Connectors/JST/STEP/S3B-EH_White.step
3D/Connectors/JST/STEP/S4B-PH-SM4_white.step
3D/Connectors/Power/STEP/CUI_PJ-037AH.step
3D/Connectors/Power/STEP/CUI_PJ-102AH.step
3D/Connectors/Power/STEP/Molex_2053380004.step
3D/Connectors/Quick-Fit/CAD/CONNECTOR_QUICK_FIT_F_PTH_KEYSTONE_3528.SLDPRT
3D/Connectors/Quick-Fit/CAD/CONNECTOR_QUICK_FIT_F_PTH_KEYSTONE_3547.SLDPRT
3D/Connectors/Quick-Fit/CAD/CONNECTOR_QUICK_FIT_F_PTH_KEYSTONE_3555.SLDPRT
3D/Connectors/Quick-Fit/CAD/CONNECTOR_QUICK_FIT_V_M_PTH_FASTON.SLDPRT
3D/Connectors/Quick-Fit/CAD/CONNECTOR_QUICK_FIT_V_M_PTH_KEYSTONE_1289.SLDPRT
3D/Connectors/RF/CAD/SMA_EDGE_RA.SLDPRT
3D/Connectors/RF/CAD/Samtec-SMA-J-P-H-ST-EM1.SLDPRT
3D/Connectors/RF/CAD/Samtec-SMA-J-P-H-ST-PN2.SLDPRT
3D/Connectors/RF/CAD/Samtec-SMA-J-P-H-ST-PN4.SLDPRT
3D/Connectors/RF/CAD/Samtec_J-P-H-ST-EM1.SLDPRT
3D/Connectors/RF/CAD/UFL-R-SMD.SLDPRT
3D/Connectors/RF/STEP/UFL-R-SMT_ALT.step
3D/Connectors/RF/STL/1814832.stl
3D/Connectors/RF/STL/SMA_EDGE_RA.STL
3D/Connectors/RF/STL/UFL-R-SMD.STL
3D/Connectors/RJ-45/STEP/Wurth_Electronics_7499210121A.step
3D/Connectors/SD SOCKET HAFIZALI.SLDPRT
3D/Connectors/SD/IGES/475710001.igs
3D/Connectors/SD/STEP/475710001.stp
3D/Connectors/SD/STL/475710001.STL
3D/Connectors/SD/STL/Micro_SD.STL
3D/Connectors/Samtec/CJT/CAD/CJT-BDY-001-X_RA VERSION.sldprt
3D/Connectors/Samtec/CJT/CAD/CJT-GKT-001.sldprt
3D/Connectors/Samtec/CJT/CAD/CJT-INS-001.sldprt
3D/Connectors/Samtec/CJT/CAD/CJT-INS-001_1.sldprt
3D/Connectors/Samtec/CJT/CAD/CJT-INS-002_RA BOTTOM INSUL.sldprt
3D/Connectors/Samtec/CJT/CAD/CJT-INS-002_RA BOTTOM INSUL_1.sldprt
3D/Connectors/Samtec/CJT/CAD/CJT-T-P-RA-BH1-INS_RA TOP INSUL.sldprt
3D/Connectors/Samtec/CJT/CAD/CJT-T-P-X-RA-BH1-PIN.sldprt
3D/Connectors/Samtec/CJT/CAD/CJT-T-P-X-RA-BH1-SHL.sldprt
3D/Connectors/Samtec/CJT/CAD/CJT-T-P-X-RA-TH1-PIN.sldprt
3D/Connectors/Samtec/CJT/CAD/CJT-T-P-X-RA-TH1-SHL_RA SNOUT.sldprt
3D/Connectors/Samtec/CJT/CAD/CJT-T-P-X-ST-TH1-PIN.sldprt
3D/Connectors/Samtec/CJT/CAD/CJT-T-P-X-ST-TH1-SHL_vertical conn.sldprt
3D/Connectors/Samtec/CJT/CAD/CJT-T-P-XX-RA-BH1.SLDASM
3D/Connectors/Samtec/CJT/CAD/CJT-T-P-XX-RA-TH1.SLDASM
3D/Connectors/Samtec/CJT/CAD/CJT-T-P-XX-ST-TH1.SLDASM
3D/Connectors/Samtec/CJT/CAD/SMA-NUT-001-X.sldprt
3D/Connectors/Samtec/CJT/STEP/CJT-T-P-XX-RA-BH1.step
3D/Connectors/Samtec/CJT/STL/CJT-T-P-XX-RA-BH1.STL
3D/Connectors/Samtec/CJT/STL/CJT-T-P-XX-RA-TH1.STL
3D/Connectors/Samtec/CJT/STL/CJT-T-P-XX-ST-TH1.STL
3D/Connectors/Samtec/ERCD/CAD/ECD-XX-03_-10.sldprt
3D/Connectors/Samtec/ERCD/CAD/ECD-XX-03_-10_1.sldprt
3D/Connectors/Samtec/ERCD/CAD/ECD-XX-03_-10_2.sldprt
3D/Connectors/Samtec/ERCD/CAD/ERCD Dowel Pin_1.sldprt
3D/Connectors/Samtec/ERCD/CAD/ERCD Dowel Pin_2.sldprt
3D/Connectors/Samtec/ERCD/CAD/ERCD ERM8-XXX-D-EMX-XX_20 position w_LATCHING.sldprt
3D/Connectors/Samtec/ERCD/CAD/ERCD PCB-EM(10 POS).sldprt
3D/Connectors/Samtec/ERCD/CAD/ERCD PCB-EM_10 POS.sldprt
3D/Connectors/Samtec/ERCD/CAD/ERCD PCB-EM_10 POS_1.sldprt
3D/Connectors/Samtec/ERCD/CAD/ERCD PCB-EM_10 POS_2.sldprt
3D/Connectors/Samtec/ERCD/CAD/ERCD-010-TEU-N-S-1.SLDASM
3D/Connectors/Samtec/ERCD/CAD/ERM8-EM.sldprt
3D/Connectors/Samtec/ERCD/CAD/ERM8-EM_1.sldprt
3D/Connectors/Samtec/ERCD/CAD/ERM8-EM_2.sldprt
3D/Connectors/Samtec/ERCD/CAD/LTC-16-01_DEFAULT.sldprt
3D/Connectors/Samtec/ERCD/CAD/LTC-16-01_DEFAULT_1.sldprt
3D/Connectors/Samtec/ERCD/CAD/LTC-16-01_DEFAULT_2.sldprt
3D/Connectors/Samtec/ERCD/CAD/STS-04.sldprt
3D/Connectors/Samtec/ERCD/CAD/STS-04_1.sldprt
3D/Connectors/Samtec/ERCD/CAD/STS-04_2.sldprt
3D/Connectors/Samtec/ERCD/CAD/WT-29-XX-X_-07 1.58 bd Smooth Latch.sldprt
3D/Connectors/Samtec/ERCD/STL/ERCD-010-TED-S-2.STL
3D/Connectors/Samtec/ERF8/CAD/C-211-XX.X-X_-05.sldprt
3D/Connectors/Samtec/ERF8/CAD/C-211-XX.X-X_-05_1.sldprt
3D/Connectors/Samtec/ERF8/CAD/C-211-XX.X-X_-05_2.sldprt
3D/Connectors/Samtec/ERF8/CAD/C3D-C-211-XX.X-X_-05.sldprt
3D/Connectors/Samtec/ERF8/CAD/C3D-C-211-XX.X-X_-05_1.sldprt
3D/Connectors/Samtec/ERF8/CAD/C3D-ERF8-XXX-XX.X-DV-XXX_-05 25 pos w_latches.sldprt
3D/Connectors/Samtec/ERF8/CAD/C3D-ERF8-XXX-XX.X-DV-XXX_-05 25 pos w_latches_1.sldprt
3D/Connectors/Samtec/ERF8/CAD/C3D-WT-30-XX-X.sldprt
3D/Connectors/Samtec/ERF8/CAD/ERF8-010-02.0-X-DV-K-BASIC.SLDPRT
3D/Connectors/Samtec/ERF8/CAD/ERF8-010-05.0-X-DV-K.SLDASM
3D/Connectors/Samtec/ERF8/CAD/ERF8-010-05.0-X-DV-L.SLDASM
3D/Connectors/Samtec/ERF8/CAD/ERF8-010-05.0-X-DV.SLDASM
3D/Connectors/Samtec/ERF8/CAD/ERF8-020-05.0-X-DV-L-BASIC.SLDPRT
3D/Connectors/Samtec/ERF8/CAD/ERF8-020-05.0-X-DV-L.SLDASM
3D/Connectors/Samtec/ERF8/CAD/ERF8-020-05.0-X-DV.SLDASM
3D/Connectors/Samtec/ERF8/CAD/ERF8-020-07-X-DV-BASIC.SLDPRT
3D/Connectors/Samtec/ERF8/CAD/ERF8-XXX-XX.X-DV-XXXX_-05 30 pos.sldprt
3D/Connectors/Samtec/ERF8/CAD/ERF8-XXX-XX.X-DV-XXX_-05 30 pos.sldprt
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
