CascoLogix/KiCAD_Libraries/PCB/General_THT_Pad_Design_Guideline.rtf

Pad drill X = Nominal pin diameter * 110% to 125%
Shape size X = Pad drill X * 150%
