CascoLogix/KiCAD_Libraries/Schematic/Schematic Library Component Setup Checklist.rtf

Schematic Library Component Setup Checklist
• Pin count correct
• Pin names correct/complete
• Datasheet link
• Footprint filter setup
• Lock to specific footprint if possible
• Description field complete
• Ref des assigned per standard
• Component part number assigned
• Text field sizes set per standard (0.040")
• Pin lengths assigned per standard (0.200")
• Pin number text sizes set per standard (0.040")
• Pin name text sizes assigned per standard (0.040")
