CascoLogix/KiCAD_Libraries/PCB/$Footprint Guidelines/PCB Library Component Setup Checklist.rtf

PCB Library Component Setup Checklist
• Silkscreen line thickness is no less than 5mils
• For PTH components, ensure PCB drill is std PCB drill index
• Link 3D part if applicable
•
