CascoLogix/KiCAD_Libraries/PCB/$Footprint Guidelines/Wire_Pad_Design_Guideline.rtf

Pad drill X = Nominal wire diameter * 125%
Shape size X = Pad drill X * 175%
