CascoLogix/KiCAD_Libraries/Templates/MikroBUS_Board_L_Template/mikroBUS_Info/Can I Make My Own mikroBUS Boards.PNG

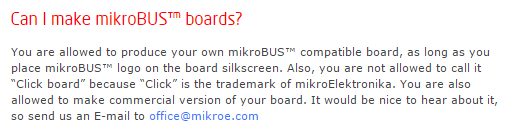
Templates/MikroBUS_Board_L_Template/mikroBUS_Info/Can I Make My Own mikroBUS Boards.PNG
