CascoLogix/KiCAD_Libraries/(commit log)

2012-11-06 Added 3 crystal resonator footprints.
2012-11-22 Added MDM connectors to connector schematic library. Added Wings3D models of MDM connectors. Added wire pad to connector schematic library. Added wire pad design guidelines. Added Wire_to_Board PCB l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
2012-12-11 Added components to libs
    [Schematic_Component_Setup_Time_Study.xlsx]
2012-12-21 First commit.
    [Wings_3D_Library_Info.xlsx]
2013-01-24 Added 74LS125
    [548190572.igs, 548190572.prt, 548190572.stp]
2013-01-30 Updated Battery PCB library Added 2R14P x 2mm header and 2R36P x 100mil header to PCB header library Added POT63YB to PCB Potentiometer library Added CONN_2 and CONN_3 to PCB Terminal Block library A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
2013-01-31 Added 2R36P 100MIL header to schematic library Added 2R36P 100MIL header to PCB library Added 2R6P 100MIL header to schematic library Added 2R6P 100MIL header to PCB library
2013-02-01 Added PCB footprint builder hyperlink and zipped executable package Added FIDUCIAL to PCB library Added 1R3P and 1R2P terminal blocks to 3D library Added TLP434 and RLP434 to RF Modules in 3D library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
    [LTC4624JR.SLDPRT, MAN6640.SLDPRT]
2013-02-13 Updated Terminal_Block PCB Library w/PTSM components Added HEADER_F_100MIL_2R14P_ST_GOLD_PTH to 3D library Added HEADER_F_2MM_2R14P_ST_GOLD_PTH to 3D library Added HEADER_F_2MM_2R14P_ST_GOLD_SMT to 3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
2013-02-14 Added HEADER_F_100MIL_2R6P_ST_GOLD_PTH to 3D library Added HEADER_M_100MIL_2R36P_ST_GOLD_PTH to 3D library Updated components in Header PCB library to point to correct 3D part
2013-02-15 Update to CER_RES_1.2MM_SMT in Passive PCB library Added several 0.375" PTH potentiometer styles to Passive PCB library Added large and small potentiometer symbols to Passive Schematic library
2013-02-16 Added KiCAN Feature Requests document Added Library component creation process document Added KiCAD_PCB_Library_Info Excel spreadsheet Updated Header Schematic library to correct Wire Pad ref designa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
    [KiCAD_PCB_Library_Info.xlsx]
2013-02-22 Worked on standard naming convention documentation in "Wings_3D_Library_Info.xlsx", "KiCAD_PCB_Library_Info.xlsx" documents
    Added feature requests to "KiCAD Feature Requests.rtf" document
    Added following components to Passive PCB Library
    - RES_M_500MIL_375MIL_195MIL_HORZ_PTH
    - RES_M_500MIL_375MIL_195MIL_PTH
    Changed footprint association for the Electromechanical Schematic Library
    component, FSMJH, from 3D Component "SW_TACT_PUSH" to "FSMJH" to lock it to that
    specific footprint.
    Added several 3D Component Potentiometer Library components to repo using. These
    components were part of the KiCAD package and were renamed using the standard
    naming convention.
    [KiCAD_PCB_Library_Info.xlsx, Wings_3D_Library_Info.xlsx]
2013-02-26 Removed BGA-676 Schematic Library Added "Capacitor_Library_Component_Names.xlsx" in PCB Library Added "Header_Library_Component_Names.xlsx" in PCB Library Added "Potentiometer_Library_Component_Names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
    [Capacitor_Library_Component_Names.xlsx, Header_Library_Component_Names.xlsx, Potentiometer_Library_Component_Names.xlsx, Resistor_Library_Component_Names.xlsx, Switch_Library_Component_Names.xlsx]
2013-02-26 Updated Wire_Pad footprints in the Wire_to_Board PCB Library to include silkscreen around the pad.
2013-02-26 Connector Schematic Library - Added specific wire gauges to the Wire_Pad components Updated Schematic Library Component Setup Checklist Added numerous 3D Header Library components utilizing the stand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
2013-02-26 Added various standard-named components to the Schematic header library Updated Switch Library component names spreadsheet Split Wings 3D Library Info spreadsheet into seperate files for each tab Add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
    [Battery_Holders_Library_Component_Names.xlsx, Connector_Library_Component_Names.xlsx, Diode_Library_Component_Names.xlsx, Display_Library_Component_Names.xlsx, Fuse_Library_Component_Names.xlsx, IC_Library_Component_Names.xlsx, Switch_Library_Component_Names.xlsx, Test_Point_Library_Component_Names.xlsx]
2013-02-26 Corrected axis centering of LED_0603* 3D components Added LED_0603 generic component Corrected Ref Designators in Schematic Displays library to use standard Ref Des Changed pin lengths to 100mil, use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
    [TE_Connectivity_FSM4JH.SLDPRT, TE_Connectivity_FSM4JH.STL]
2013-02-27 Added many Unshrouded type male and female headers to the Schematic library.
2013-03-11 Updated feature requests
    Active:
    - Added DO-214AA_SMT
    - Added DO-214AB_SMT
    - Added DO-214AC_SMT
    - Added SOT23-3_SMT
    - Added SOT23-5_SMT
    - Added SOT23-6_SMT
    - Removed SOT23-3
    - Removed SOT23-5
    - Removed SOT23-6
    Display:
    - Added CFAH0802A
    Active:
    - Updated diode pin#'s to use A and K instead of 1 and 2
    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
2013-10-06 Added several new components
    [KiCAD_Schematic_Library_Info.ods]
2013-10-20 #PCB + CascoLogixLogos Library #Schematic + CascoLogixLogos Library #Connector Library + SOLDER_LINK #Header Library + HEADER_F_XBEE_PTH #RF_Modules + BLE112-A + BLE113-A + PAN1720 + PAN1721
2013-10-21 New 3d components directory structure. Will need to update all the corresponding PCB libraries (.mod files) with new 3D component directory.
    [2041021-4.SLDPRT, Assmann_a-sl200-ea-g02mp1.SLDPRT, BI_Technologies_68W.SLDPRT, BI_Technologies_72X.SLDPRT, BI_Technologies_93.SLDPRT, Bourns_3006P.SLDPRT, Bourns_3224J.SLDPRT, Bourns_3224W.SLDPRT]
2013-11-14 Active.mod: + QFN-16 + Updated values to be invisible
    Electromechanical.mod:
    + FSMJSMA
    + FSMSM
    Header.mod:
    + HEADER_50MIL_2R10P
    + HEADER_XBEE
    Passive.mod:
    + SOLDER_LINK
    RF_Modules.mod:
    + BLE112
    + BR-LE4.0-S3A
    Test_Point.mod:
    + 5015
    + 5016
    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
2013-12-18 Added QFN-16 PCB footprint to Active library. Added FT230XQ Schematic decal to Active library
2014-10-03 Updated PCB/Active and PCB/Passive, as well as Schematic/Active.
2014-11-28 PCB/Header: - Added 50-mil pitch female header - Added 2.0-mm pitch female header
    PCB/Passive:
    - Added C0603, C0805, R0603, R0805
    Schematic/Active:
    - Added N- and P-Channel Small FETs
    Schematic/Connector:
    - Added NO and NC Solder links
    Schematic/Integrated Circuits:
    - Added CD40109B, CD4504, CD74HC4050, MCP7940M-I/MNY, MCP7940M-I/MS,
    MCP7940M-I/P, MCP7940M-I/SN, MCP7940M-I/ST, MCP9800, MCP9801, MCP9802, MCP9803
    Schematic/Passive:
    - Updated CAPP to have common line widths
    3D/Headers:
    - Added Headers
    3D/Discrete/Passive:
    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
    [FSMSM.igs, GRS-2012-2000.SLDPRT, GRS-2012-2000.STL, GRS-2012-2000_Socket.SLDASM, GRS-2012-2000_Socket.SLDPRT, GRS-2012-2000_Socket.STL, HEADER_M_1.27MM_2R10P_ST_AU_SMT.SLDPRT, HEADER_M_1.27MM_2R10P_ST_AU_SMT.stp]
2014-12-09 Major cleanup. Too many additions and changes to list.
    [AB26TRB.STL, BK-912_SMT.STL, Crystal.STL, FFC_14_BOT_LATCH_SMT.stl, GRS-2012-2000.SLDPRT, GRS-2012-2000.STL, GRS-2012-2000_Socket.SLDASM, GRS-2012-2000_Socket.SLDPRT]
2014-12-10 PCB/Transducers: - Added PS1240 transducer
    PCB/Electromechanical:
    - Removed PS1240 transducer
    3D/Electromechanical:
    - Added PTS810 pushbutton
    Removed FIDUCIAL.mod from root directory
    Removed KiCAD feature request list
    Removed Library component creation process
    [PS1240P02BT.FCStd, PS1240P02BT.stl, PTS810.FCStd]
2014-12-10 Link to 3D model got lost when moving footprint into 'Transducer' library. Link has been restored. PCB drill size and pad size were also adjusted for better transducer pin fitment.
2015-03-11 PCB Header library: Added two header footprints PCB Passive: Added AC1020 current sense transformer footprint Schematic Passive: Added AC1020 current sense transformer decal 3D Sensors: Added AC1020 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
    [Talema_AC1005.stl]
2015-04-20 Converted to new KiCAD library format
2015-07-10 Added several header footprints and schematic decals. Added 3D part model path to 2x20pin header footprint.
2015-10-05 Added PCB and 3D components
    [RFM95W.SLDPRT, RFM95W.STL, UFL-R-SMD.SLDPRT, UFL-R-SMD.STL]
2015-10-06 Added components.
    [SMA_EDGE_RA.SLDPRT, SMA_EDGE_RA.STL, Samtec_J-P-H-ST-EM1.SLDPRT]
2015-11-27 Added footprint for VQFN-48 package
2015-12-03 Added mikroBUS module KiCAD project template. Updated ANTENNA_HELICAL_RA footprint. Added mikroBUS logo to library.
    [MikroBUS_Board_S_Template.kicad_pcb, MikroBUS_Board_S_Template.sch]
2015-12-03 Corrected error in fiducial footprint.
2015-12-05 Added more KiCAD template files
    [MikroBUS_Board_L_Template.kicad_pcb, MikroBUS_Board_L_Template.sch, MikroBUS_Board_M_Template.kicad_pcb, MikroBUS_Board_M_Template.sch, XBee_Module.kicad_pcb, XBee_Module.sch]
2016-01-07 Updated solder link footprints
2016-01-09 Added 915MHz coil antenna 3D model and updates to a few PCB footprints.
    [SW868-TH13.IGS, SW868-TH13.SLDPRT, SW868-TH13.STEP, SW868-TH13.STL]
2016-01-23 Updates to header, connector, IC, and terminal block libraries. Corrections on SMA Edge connector footprint. Added 3D models.
    [475710001.STL, 475710001.igs, 475710001.stp, 9V Duracell Battery.STL, Keystone_593.STL, Keystone_594.STL, Memory_Protection_Devices_BC9VPC.STL, Micro_SD.SLDPRT]
2016-01-31 Modified ignore file, added several 3D model files, added header to header library, added RF modules to RF module library, added terminal blocks to Terminal Block library, added schematic decals to a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
    [Keystone 3012-3013THROUGH HOLE.STL, OSTVN02A150.SLDPRT, OSTVN02A150.STEP, OSTVN02A150.STL, SMD Aluminum Electrolytic Capacitors 100uF 6,3V.SLDPRT, SMD Aluminum Electrolytic Capacitors 100uF 6,3V.STEP, SMD Aluminum Electrolytic Capacitors 100uF 6,3V.STL, SMD Aluminum Electrolytic Capacitors 47uF 6,3V.SLDPRT]
2016-04-22 Added new schematic library components, PCB footprints and 3D models. Updated 0402 and 0603 footprints to standard.
    [SMA_EDGE_RA.SLDPRT, SW868-TH13.SLDPRT]
2016-06-14 Added component footprints. Added 3D models.
    [Raytac-MDBT40.step, Raytac_MDBT40.stl]
2016-06-28 Added several 3D models
    [ArduinoMicro.SLDPRT, Arduino_Pro_Mini.SLDPRT, Arduino_Pro_Mini.STEP, Arduino_Pro_Mini.STL, ESP-03.SLDPRT, ESP-03.STEP, ESP-03.STL, OSTTC022162.SLDPRT]
2016-08-06 Added 3.5mm push spring-cage clamp terminal block schematic decal and PCB footprint.
2016-08-07 Added several schematic decals and pcb footprints for power supplies and XBee sockets.
2016-08-21 Added several schematic and PCB library parts.
2016-08-21 Added several schematic library decals.
2016-08-22 Added or corrected several decals in schematic libraries. Added SOT-89 footprint in PCB footprints library.
2016-09-16 Many schematic decals, PCB footprints and 3D models added. Baseline check-in prior to moving newest files into repository and pushing to repository.
    [17653.stl, 1814832.stl, AAA Battery.SLDPRT, Battery.SLDPRT, Battery_CR2032.SLDPRT, C-Size Battery.SLDPRT, CR123A 3V.SLDPRT, CR14505BL-VB.SLDPRT]
2016-09-16 Added latest schematic decals, PCB footprints and 3D models from local project directory.
    [BHC-2.STEP, BHCL.STEP, BHCW.STEP, DO-214AC SMA.SLDPRT, PTSA.stl, Phoneix_1985250.STEP, micro_usb_vert.step]
2016-09-16 Updated 3d parts paths in footprint files.
2016-09-21 Fixed several 3D models and updated the links to those 3D models within the component footprint. Added ESP module 3D models to the library.
    [ESP-07v2.scad, ESP-07v2.stl, ESP-07v2_4wings.stl, ESP-12.scad, ESP-12.stl, ESP-12_4wings.stl, ESP-13-wroom-02.scad, ESP-13-wroom-02.stl]
2016-09-21 Fixed pointer to 3d model for u.fl connector inside PCB footprint.
2016-10-01 Added can-style capacitor footprint, updated a few footprints. Corrected terminal configuration of SOT-223 schematic and pcb component.
2016-10-01 Corrected 8x10mm SMT cap footprint. Added 8x10mm SMT cap 3D model. Added Tuffduino logos.
    [8x10_Cap.STEP]
2016-11-25 Updated XBee templates, schematic decals and pcb footprints.
    [XBee_Module.kicad_pcb, XBee_Module.sch]
2016-11-29 Added KiCAD templates.
    [XBee.kicad_pcb, XBee.sch, XBee_Pro.kicad_pcb, XBee_Pro.sch]
2016-12-05 Updated Casco Logix logos and added datasheet link to EMW3165 schematic decal.
2016-12-21 Updated mikroBUS templates to correct RX/TX pin assignment for the module side. Removed silkscreen from wire pad footprint. Changed decal pin names for ESP-12E to match datasheet.
    [MikroBUS_Board_L_Template.sch, MikroBUS_Board_M_Template.sch, MikroBUS_Board_S_Template.sch]
2017-02-20 Updated 0603 capacitor and resistor 3D models and PCB footprints. Also updated models and footprints for XBee headers and ESP-12E.
    [C0603.step, C1206.step, HEADER_M_2.00MM_1R10P_ST_AU_PTH_1.step, HEADER_M_2.00MM_1R10P_ST_AU_PTH_2.step, R0603.step, Sullins_NRPN101PAEN.SLDPRT]
2017-03-02 Added F0603 PCB footprint and 2-pc XBee PCB footprint. Added new 3D models and renamed .stp files to .step. Removed duplicate wings3D file in wrong folder.
    [HEADER_M_1.27MM_2R10P_ST_AU_SMT.step, HEADER_M_1.27MM_2R10P_ST_AU_SMT.stp, HEADER_M_1.27MM_2R12P_ST_AU_SMT.step, HEADER_M_1.27MM_2R12P_ST_AU_SMT.stp, HEADER_M_1.27MM_2R14P_ST_AU_SMT.step, HEADER_M_1.27MM_2R14P_ST_AU_SMT.stp, HEADER_M_1.27MM_2R20P_ST_AU_SMT.step, HEADER_M_1.27MM_2R20P_ST_AU_SMT.stp]
2017-03-05 Updated large qty of VRML files using the KiCAD StepUp Macro. Added many new 3D Models in both STEP and VRML format.
    [8x10_Cap.STEP, B4B-PH-K-S2.step, B4B-PH-SM4-TB.STEP, BHC-2-Assy.STEP, BHC-2.STEP, BHC-2_CELL.STEP, C0805.step, CAP_8X10MM_SMT.step]
2017-03-05 Renamed 3D Models of XBee headers to standard format and updated XBee header PCB footprints.
2017-03-05 Corrected a few IC PCB footprints to remove Z-axis rotation, Z-axis offset and correct the 3D models. Also updated the 1.27MM pitch header 3D model with the correct model.
    [HEADER_M_1.27MM_2R10P_ST_AU_SMT.step, SOT-23-3.step, SOT-23-3_GDS.step, SOT-89.step]
2017-03-05 Updated 3D models for XBee header, PTS810, 1.27MM JTAG header, RFM69.
    [HEADER_M_1.27MM_2R10P_ST_AU_SMT.step, HEADER_M_2.00MM_1R10P_ST_AU_PTH_XBEE_P11_P20.step, HEADER_M_2.00MM_1R10P_ST_AU_PTH_XBEE_P1_P10.step, PTS810.step]
2017-03-05 Updated the 3D Model link for SOD-323F. Updated ref des prefixes on XBee socket footprints. Added new logo to logo library.
2017-03-05 Added footprint and 3D model for 1206 resistor. Updated 3D models for 0402, 0603 and 0805 resistors.
    [R0402.step, R0805.step, R1206.step]
2017-03-05 Added missing STEP file for PTC. Updated STEP files for battery holder. Renamed STEP files for existing PTC to be consistent naming.
    [B4B-PH-K-S.step, BHC-2.STEP, BHC-2_CELL.STEP, PTC_0603.step, PTC_0805.step]
2017-03-12 Fine tuned a few 3D Models. Checked insertion parameters on several PCB footprints - many were not set. Many more need to be corrected over time. Removed silkscreen from PTH pads on several header fo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
    [BHC-2_CELL.STEP]
2017-03-28 Added one new JST connector (B6B) and updated one JST connector (B4B).
    [B4B-PH-K-S.step, B6B-PH-K-S.step]
2017-04-04 Added footprints and 3D models for JST connectors.
    [BM06B-SRSS-TB.step]
2017-05-07 Updated pin 1 pad from round to square.
2017-05-22 Added AP2191AW-7 to Active library. Corrected pin numbers on schematic decal for MCP1700.
2017-07-01 Added LTC4412. Added pin 1 marking for header footprint.
2017-07-09 Added new diode PCB footprints and schematic decals.
    [MicroMELF.step]
2017-07-13 Updated PCB footprint SOT-323 and added SOT-353 and SOT-363 and 3D models. Added schematic BOM generation scripts. Updated XBee header footprints to remove silkscreen from through hole pads.
    [SOT-323.step, SOT-353.step, SOT-363.step]
2017-08-11 Added new components (relays and male headers).
    [HEADER_M_2.54MM_1R10P_0.230H_ST_AU_SMT.step, HEADER_M_2.54MM_1R6P_0.230H_ST_AU_SMT.step, HEADER_M_2.54MM_1R8P_0.230H_ST_AU_SMT.step, T9AS1D1.step, T9AS1D12.stp, T9AS1D2.step, T9AS1D22.stp, T9AS5D1.step]
2017-09-04 Added schematic symbol for configurable logic chip.
2017-12-12 Fixed 915MHz helical antenna 3D model
    [SW868-TH13.STEP]
2017-12-28 Corrected uSD Card footprint in connector library, added recom DC-DC converter to power supplies library.
2017-12-28 Updated/added to header library and generic battery schematic symbol in batteries and holders library. Added some 3D models. Rearranged some folders.
    [RECOM_RM-0505S.step]
2017-12-29 Added more headers to 3D models. Added 3D model for Barrel Jack.
    [CUI_PJ-102AH.step, HEADER_F_2.54MM_1R2P_ST_AU_PTH.step, Harwin_M20-7820246.step, M20-7820246.step]
2017-12-29 Added 5-pin single row header to footprint and 3D library.
    [HEADER_F_2.54MM_1R5P_ST_AU_PTH.step, Harwin_M20-7820546.step, M20-7820246.step]
2018-01-02 Fixed several components footprints (mostly header library) that contained silkscreen on the pads. Removed all instances using text editor find/replace within the .pretty directories.
2018-01-03 Removed silkscreen from pads on 1x3 terminal block
2018-01-24 Added footprints and schematic symbols
2018-01-24 Added relay schematic symbol.
2018-01-25 Updated battery holder 3D model. Added two switch component footprints.
2018-02-17 Changed pin assignment to match schematic decal for correct polarity translation.
2018-03-26 Corrected pin assignments on 2x3-pin 100-mil header footprint. Moved silkscreen outline of PTC_0603 footprint to be wider and outside of soldermask relief.
2018-04-02 Added multi-part logic gates to Integrated Circuits library.
2018-04-27 Added schematic decal and PCB footprint for ATWINC1500 WiFi chip.
2018-04-29 Added crystal footprint.
2018-05-06 Corrections to SOD-323F silkscreen outlines in footprint.
2018-05-11 Updated silkscreen outlines of passive footprints for C0805, DG6050C and L0603 to clear the soldermask pad clearance area. Updated footprint list references on two schematic decals.
2018-05-21 Added actual connector footprint for AVX battery connector. Moved mounting hole footprint from Passive library to Fastener library.
2018-05-26 Added AVX battery connector PCB footprint and 3D Model.
    [AVX_009155005003016.step]
2018-06-30 Updated libraries to add new schematic decals.
2018-07-01 Added FFC connectors to the Connector library. Added new Power Symbols library.
2018-07-03 Added new FFC connectors
2018-07-07 Updated parameter on Power Symbols library to correct ERC errors. Added 15-pin FFC connector.
2018-07-09 Added 8-pin FFC connector.
2018-07-11 Added IR and UV LED footprints and mechanical mounting footprints for Raspberry Pi Camera Modules.
2018-07-12 Added RPi camera module PCB footprint. Improved footprint of LED0603 to include better polarity marking and fabrication layer. Added schematic decal for AO4752.
2018-07-13 Found and corrected error in power symbols library. Power symbols MUST have pins set as input direction. Added footprint for 2920 size fuse.
2018-07-14 Corrected SainSmart Camera Module outline to match the actual part. Added PCB footprints for FFC's and one inductor.
2018-07-14 Added several new 3D models. Updated footprints to reference 3D models.
    [0ZCF0200AF2C.step, 3.5_TFT.step, 3.5_TFT_2.step, C-1734592-8.step, Compute Module.step, DFN-12_3x3.step, ISFV15R_2STLF.step, M12 lens holder.STEP]
2018-07-15 Added court yards and fabrication layer details to footprints. Corrections made to 3D connector models. Added new connector footprints and 3D models.
    [ISFV15R_2STLF.step]
2018-07-15 Updated mounting hole schematic decal to call out pin number for proper netlist matching to PCB footprint pin numbering. Added connector footprint and 3D model.
    [SFW_R-2ST_LF.step]
2018-07-15 Updated 3D model for 15-pin FFC and SainSmart camera module.
    [SFW_R-2ST_LF.step]
2018-07-16 Removed polarity dot on inductor. Added 3D models for TFT display.
    [3.5_TFT_TOUCHSCREEN001.step]
2018-07-24 Added new connector and active component schematic decals. Added corresponding PCB footprints.
2018-07-25 Updated fiducial and mounting holes.
2018-07-25 Added 3D models and updated references to 3D models within PCB footprints.
    [471511051.step, 7499210121A.step, QFN64_9X9MC-L.step, QFN64_9X9MC-L.stl, QFN64_9X9MC-M.step, QFN64_9X9MC-M.stl, QFN64_9x9MC.step, QFN64_9x9MC.stl]
2018-07-28 Added new 3D models, footprints and schematic decals. Updated several schematic decals and footprints to conform to consistent text sizes and fix links to 3D models.
    [7499210121A.step, Wurth_Electronics_7499210121A.step]
2018-07-29 added various PCB footrpints and 3D models
    [10SVP150M.step, ABLS-25.0.step, C-2-1734592-0.step, DO-214AC.step, DPAK_TO-252AA.step, DR127-1.step, R2512.step, TSSOP20_TP.step]
2018-07-29 Updated PCB footprint for R_2512
2018-07-29 Updated pointer to 3D model for 20-pin x 0.5mm FFC connector.
2018-07-30 Added non-polarized version of DO-214AC for TVS diode.
2018-07-31 added 3D models and footprint for 2x6 0.1" bottom entry connector.
    [C-969973-6.step]
2018-07-31 Added STEP and VRML files for SOT-523
    [SOT-523.step]
2018-07-31 Added SOT-523 footprints.
2018-07-31 Updated STEP and VRML files for SOT-523.
    [SOT-523.step]
2018-08-01 Added footprint for DMG1012T FET.
2018-08-05 Added new decals and footprints for crystals, power supply header for HDMI LCD and 3D models for HDMI LCD. Removed mikroBUS logo footprint from wrong footprint library (duplicate).
    [UCTRONICS_3.5_LCD.step]
2018-08-06 Added 4-SMD crystal.
    [4-SMD_XTAL.step]
2018-08-06 Updated FA-238_3225 footprint to add 4-SMD 3D model.
2018-08-09 Added QBHP684E LED footprint and 3D model.
    [QBHP684E.step]
2018-08-11 Added footprint for VSMY98145DS IR led.
2018-08-11 Added 3d models (STEP and WRL) for TE Connectivity C-103669-1 2-pin latching header.
    [C-103669-1.step]
2018-08-11 Added power symbol for VDD18CORE.
2018-08-12 Added schematic symbol for 93LC66A 4Kbit EEPROM.
2018-08-19 Update footprint for the QBHP684E LED to relieve the silkscreen around the two pads.
2018-08-19 Updated footprints for IR and UV LEDs to include corect past/mask reliefs.
2018-08-20 Updated footprints and added L_0603 footprint.
2018-08-22 Merged conflict between versions of QBHP684E LED footprint.
2018-08-22 Merged conflict between versions of VSMY98145DS LED footprint.
2018-09-23 Added AP2331W schematic decal and accompanying footprint. Also added new FFC footprint.
2018-10-04 Added HDMI schematic symbol to Connector library. Added 47659-1000 HDMI footprint to Connector PCB library.
2018-10-06 Added 1x3-terminal 3.5mm pitch terminal block footprint.
2018-10-07 No changes to Integrated Circuits library. Saved library to resolve error message associated with this particular library appearing after upgrading to KiCAD v5.0.0
2018-10-08 Added 3D footprint for Phoenix Contact 3.5mm 3-pin terminal block.
    [Phoenix_BCH_350_V_3_GN_cp.step]
2018-10-08 Updated 3D component association with 1x3-pin 3.5mm pitch terminal block.
2018-10-13 Added 3D models (both STEP and WRL) for Wurth 3-pin, 2-piece terminal blocks - both header and plug.
    [Wurth_691321100003.step, Wurth_691361100003.step]
2018-10-13 Updated PCB footprint for HDMI connector (47659-1000).
2018-10-13 Updated footprint for HDMI connector (47659-1000). Added 3D models (both STEP and WRL) for 476591002 HDMI connector.
2018-10-13 Updated connector footprint for 20 pin 0.5mm pitch FFC connector. Updated 3d models (both STEP and WRL) for 20 pin FFC footprint - C-2-1734592-0.
    [C-2-1734592-0.step]
2018-10-14 Updated footprint for HDMI connector (47659-1000).
2018-10-27 Added footprint for 100 pin TQFP package (TFP401).
2018-10-27 Added several new schematic symbols: 24LC02BT, MIC803, TFP401.
2018-10-28 Added STEP and WRL files for 100 pin TQFP and STEP and WRL files for Molex 50 pin FFC connector.
    [Molex_54132-5033.step, TQFP-100.step]
2018-11-02 Added S-PQFP-G100 kicad footprint; added Molex 54132-5033 kicad footprint; updated Active schematic library, updated Power Symbols schematic library.
2018-11-03 Added JST STEP and VRML files for S4B connector; added 3D models for Fraen lens; added footprint for JST PH S4B connector.
    [Fraen_Optic_Lens.step, S4B-PH-SM4_white.step]
2018-11-05 Added 3D STEP files for blue, green and red LEDs.
    [LED_0603_BLUE.step, LED_0603_GREEN.step, LED_0603_RED.step]
2018-11-05 Created new 3D STEP and WRL files for StoneLock version of 3.5" TFT LCD.
    [3.5_TFT_SL.step]
2018-11-05 Updated 3D STEP and WRL models for SOT-23-3 package.
    [SOT-23-3.step]
2018-11-30 Added 3D Models of switches.
    [ESE16J001.step, ESE22MV21T.step]
2018-12-02 Added PCB symbol, VRML, and STEP file for 22 position FFC bottom contact connector.
    [SFW22R-1STE1LF.step]
2018-12-02 Added footprints for switches. Corrected silkscreen error on MH_#6 mounting hole footprint.
2018-12-03 Added R_0603 and R_0805 footprints to library.
2018-12-07 Rotated ESE22MV21T STEP file. Added ESE22MV21T WRL file. Revised SODIMM connector to change color to black
    [ESE22MV21T.step]
2018-12-08 Added FFC schematic decals and PCB footprints for male contacts for FFC cable layout.
2019-01-06 Updated schematic decal and PCB footprint for ESP-32S. Added to header library. Added PCB footprints for FFC designs in the Active, Connector and Passive libraries.
2019-01-13 Added ATTiny45-20XUR schematic decal and AVRISP header 3D model.
    [AVRISP_HDR.step]
2019-01-13 Updated to add Fab layer details, polarity marks on LED's.
2019-01-13 Corrected SOT-523 footprints to allow more copper pad area. Added polarity indicators for SOD-323F. Added fab layer details to all.
2019-02-13 Added TPS2378 footprint. Also added TPS2378 to Active schematic library.
2019-02-16 Updated TPS2378 schematic symbol and added DDA8_3P1X2P4 footprint.
2019-02-16 Updated IR LED FFC footprint.
2019-02-16 Added customized Mounting Holes to PCB footprints.
2019-02-16 Updated mounting holes to add ref des to B.Fab layer.
2019-02-28 Updated TPS61165 schematic decal to match pin orientation shown in datasheet.
2019-03-02 Misc. updates for Flex PCB.
    [R1210.STEP, SOD-123.step, SOT-23-6.step, VLP8040T.step]
2019-03-02 Added PCB footprints for FFC design.
2019-03-02 Added SOD-123 footprint for FFC.
2019-03-03 Made corrections to localized soldermask clearance and paste for FFC footprints.
2019-03-11 Added schematic symbol for TPS61240. Added TPS61240 WSON footprint to Active library. Added 3D models for SWON-6 and TE terminal blocks.
    [TE_282834-4.step, TI_wson6-drv.step]
2019-04-02 Added several misc. schematic symbols, PCB footprints, and step files for the comms over low voltage USB stick dev board.
    [CUI_UP2-AH-1-TH.step, SOT-563.step]
2019-04-08 Misc. updates for the Comms over low voltage USB EVB.
    [CUI_UP2-AH-1-TH.step, TB_3.50MM_Wurth_691214110002.step]
2019-04-14 Updated 5V0 and 12V power symbols.
2019-04-17 Added BAT40V-7_SOT-563 PCB footprint.
2019-05-15 Added Molex header and 3D step files as well as 0.079 in mounting hole for SOR amp board PCB.
    [0.079_Pin_0.031_PCB.step, Molex_53047-0410.step]
2019-07-23 Added 3-pin JST connector as well as Blue and White 3D models for the same connector.
    [S3B-EH_Blue.step, S3B-EH_White.step]
2019-07-24 Added TI WSON-6 footprint.
2019-08-24 Added LED ENGIN LZ1 LED to Active schematic library. Also added step file and PCB footprint for LZ1 LED.
    [LED_ENGIN_LZ1.step]
2019-08-25 Updated LED ENGIN LZ1 footprint. Updated C0603 and C0805 passive footrpints to include Fab layer details.
2019-09-13 Update footprint to correct polarity markings for LED_ENGN_LZ1.
2019-09-29 Changed 3D footprint for 15-pin FFC connector from WRL to STEP. Changed 3D footprint for SOT-523 from WRL to STEP. Updated 15-pin FFC connector footprint. Added 2.54mm 1R3- footprint.
    [SFW_R-2ST_LF.step]
2019-09-30 Added footprint and 3D models for Coilcraft XAL1010 inductor. Added footprint and 3D models for DB Unlimited TE092705-1 electromechanical buzzer. Updated footprint for MIC28514 switcher.
    [Coilcraft_XAL1010.step, DB_Unlimited_TE092705-1.step]
2019-10-03 Updated buzzer footprint. Added 3D model for QFN40. Added new footprint for SOD-123 AK. Updated footprint for the MIC28514.
    [QFN40_6x6mm.step]
2019-10-06 Added OPB733TR schematic symbol to 'Active' library. Added OPB733TR PCB footprint. Added OPB733TR 3D model.
    [OPB733TR.stp]
2019-10-12 Updated OPB733TR opto sensor footprint to add outline and Ref Des to the Fab layer. Updated DB Unlimited TE092705 buzzer footprint to add outline to the Fab layer.
2019-11-24 Updated diode polarity markings on footprint decals and ensured consistent silkscreen and fabrication layer outlines. Updated fabrication layer details on MIC28514. Updated pin spacing from 5mm to 4m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
2019-11-25 Updated SOD-type footprints to update the mounting style attribute from Through-hole to SMT.
2019-11-25 Revert "Updated SOD-type footprints to update the mounting style attribute from Through-hole to SMT."
    This reverts commit e40f74cdf4f31bc7cd567c618b37a14d622d9047.
2019-12-01 Added fooptrints for AP63203 breakout board. Revised STO-23-6 step file.
    [AP63203_Breakout.step, SOT-23-6.step]
2019-12-11 Added new mounting hole footprint for "mouse bite".
2019-12-12 Added VoCore2 SMT footprint, moved 641737-1 footprint to the Connecor library, added VoCore2 schematic decal.
2020-01-19 Misc changes and updated to support the StoneLock REM design. Changes include: addition of the VoCore module and associated 3D model; misc. STEP and WRL models, additional ICs and Relays.
    [2.4GHz_Chip_Antenna.step, BGA84_8M0X12M5.step, C0402.step, CUI_TBP02R2-381-06BE.step, CUI_TBP02R2-381-08BE.step, EE2-5NU.step, FB0402.step, FB0805.step]
2020-01-20 Added footprints and 3D models for the following: DFN-12-1EP, TLP291, SOIC-4. Added 48V power symbol. Updated 3D model for C_1210 footring.
    [C_1210_3225Metric.step, DFN-12-1EP_3x4mm_P0.5mm_EP1.7x3.3mm.step, TLP290.step]
2020-01-21 Added SOD-128 3D model. Updated SO-128 3D footprint.
    [SOD-128.step]
2020-01-22 Updated RF_Modules libarary to include the VOCORE2_SMT schematic symbol. Added footprint and 3D models for the Wurth 74437349033 inductor.
    [Wurth_74437349033.step]
2020-01-22 Updated VoCore2 footprint with additional courtyard, comments and fab layer information.
2020-01-22 Updated DG6050C footprint to assign default 3D model. Added AP63205 and AP63301 schematic decals. Fixed 48V power symbol.
2020-01-23 Added VSSOP-8 (MSOP-8) 3D model (for TI TPS1H000). Added MSOP-8 footprint (for TIM TPS1H000).
    [VSSOP_EP_0.65.step]
2020-01-24 Added schematic decal for Wurth p/n 74984104400 RJ45 connector. Added footprint and 3D modesl for Wurth p/n 74984104400 RJ45 connecto
    [Wurth_Electronics_74984104400.step]
2020-01-26 Added footprint and 3D models for 2-SMD fuse. Added footprint and 3D model for SRF0905 common-mocd choke. Added footprint and 3D model for Bourns SDR1307 inductor. Added footprint and 3D model for TO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
    [Bourns_SDR1307.step, Bourns_SRF0905.step, Fuse_2-SMD_Square.step, TO-269AA.step]
2020-02-02 Added 3D model for 10X2QFN footprint. Added footprint for TLA2024 TI ADC. Added schematic symbol for PSSI2021SAY, DAS40-04 dual schottky, and TI TLA2024.
    [10X2QFN.step]
2020-02-03 Updated schematic decal for PSSI2021SAY current source IC.
2020-02-03 Updated hole and land sizes on several 100-mil pitch male and female headers to be consistent. Added 1x16-pin 100-mil pitch female header. Added step file and re-organized two step files and wrl file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
    [AVRISP_HDR.step, HEADER_F_2.54MM_1R16P_ST_AU_PTH.step]
2020-02-06 Updated several links to 3D models to replace the .wrl file link with the .step file link. Added new footprints. Updated footprints to include fab layers as needed.
    [HEADER_M_2.54MM_1R2P_ST_AU_PTH.step, HEADER_M_2.54MM_1R3P_ST_AU_PTH.step]
2020-02-06 Updated 3D models for male 1x2 and 1x3 pin headers.
    [HEADER_M_2.54MM_1R2P_ST_AU_PTH.step, HEADER_M_2.54MM_1R3P_ST_AU_PTH.step]
2020-02-06 Updated 3D model colors for male 1x2 and 1x3 pin headers.
    [HEADER_M_2.54MM_1R2P_ST_AU_PTH.step, HEADER_M_2.54MM_1R3P_ST_AU_PTH.step]
2020-02-07 Revised Wurth 74984104400 schematical decal to split out both shield pins, and change to pins 16 and 17.
2020-02-07 Updated RJ-45 connector footprint and added alternate version. Added C_1206 footprint.
2020-02-07 Removed silkscreen layer from pads on DIP-20 footprint.
2020-02-07 Added 3D model for 1206 PTC fuse. Updated F_1206 footprint to add 1206 PTC fuse STEP file.
    [PTC_Fuse_1206.step]
2020-02-07 Updated footprints for D_SO-123_AK and SOD-323F_AK to reduce text size on Fab layer.
2020-02-08 Added footprints and 3D models for 6 pin and 8 pin 3.81mm right-angle terminal blocks. Updated Fab layer for test-point footprint. Updated Fab layer for 0603 PTC fuse.
    [CUI_TBP02R1-381-06BE.step, CUI_TBP02R1-381-08BE.step]
2020-02-08 Added 0.125" mounting hole footprint. Added 3D models for Keystone P/N 9067 PCB mount.
    [Keystone_9067_Standoff.step]
2020-02-19 Added footprint and 3D models for Murata crystal. Added footprint and 3D models for MCP2210. Added footprint and 3D models for SPI flash. Added schematic symbols for Murata crystal, MCP2210, and SPI 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
    [Murata_CSTNE12M.step, QFN-20-1EP_5x5mm_P0.65mm_EP3.35x3.35mm.step, WSON-8_6x8mm_ep.step]
2020-02-23 Updated silkscreen properties.
2020-02-23 Update PCB decals for the following components to set default as SMT: DDA8..., SON127..., TLA2024, EE2-5NUH, Bourns_SDR1307, DG6050C, VOCORE2_SMD.
2020-03-07 Added TLV7031-ALT decal to Active schematic library. Added ATSAMR30M18A decal to RF_Modules schematic library. Added ATSAMR30M18A footprint to RF_Modules PCB library. Added STEP and WRL 3D models to 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
2020-03-11 Added Tag-Connect JTAG schematic decal. Added TC2030 tag-connector footprint. Added Preci-DIP 2-pin spring connector footprint. Added STEP and WRL files for Preci-DIP 2-pin spring connector.
    [8PM-11-0002-02-131.step]
2020-03-16 Added schematic decal for RV-2028-C7 RTC. Added PCB footprints and 3D models for the following: Keystone 1056, Keystone 3030, Littelfuse 242, Littelfuse 259, L1210, RV-3028-C7.
    [FUSE_LITTELFUSE-242.step, FUSE_LITTELFUSE-259.step, L1210.step, RV-3028-C7.step, keystone-PN1056.step, keystone-PN3030.step]
2020-03-22 Added 3D model (STEP, WRL, SLDPRT) for CR1025 battery. Added footprint and 3D model (STEP, WRL) for Littelfuse 370 fuse.
    [CR1025 3V Cell.SLDPRT, CR1025 3V Cell.step, FUSE_LITTELFUSE-370.step]
2020-04-11 Added 3D model and footprint for DO-221AC diode - i.e. SMA flat-lead (StoneLock).
    [DO-221AC.step]
2020-04-11 Added 3D models and footprint for POWERDI-123 diode. Added 3D models and footprint for DFN-8-1EP_3x2mm. Added LTC6930 schematic symbol.
    [DFN-8-1EP_3x2mm_P0.45mm_EP1.66x1.36mm.step, POWERDI-123.step]
2020-06-15 Updated SON127P800X600X80-9N footprint to show pin one indication one fab layer. Added DO-214AC symbol with no polarity marking.
2020-07-22 Added reed switch footprints.
2020-07-27 Added new footprints.
2020-09-20 Added MCP6541, MIC94080, and S-1206B30 to Active schematic library. Added EVP-ASAC1A to Electromechanical schematic library. Added OPB732 to Integrated_Circuits schematic library. Added 3V0 to Power_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
    [DO-219AB_SMF.step, EVPAS_Color.step, MIC9408xYFT.step, OPB732.STEP, PSM050_Color.step]
2020-10-09 Updated OPB732 footprint. Added KTA1550 to 'Active' schematic library. Added 74984104401 RJ45 connector to 'Connector' schematic library. Added PE-53913NLT commond mode choke to 'Passive' schematic l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
    [Wurth_Electronics_74984104401.step]
2020-10-13 Misc updates for StoneLock Isolation daugther PCB.
    [RFM-0505S.step, SOP-16.step, SOT323_SC70.step]
2020-11-07 Updated SOP63P599X175 footprint. Updated SOT-323_GDS footprint to show fab layer. Updated R0603 and R0805 footprints to show on fab layer. Added QSOP-16 footprint. Added 3 mouse-bite footprints for c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
    [QSOP-16_3.9x4.9mm_P0.635mm.step]
2020-11-11 Updated INDCAF footprint to add 3D model. Added AZ1117 and MCP1700 families to schematic Active library. Added digital isolators to schematic library. Added 12V-ISO and 3V3-ISO power symbols. Added 3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
    [Coilcraft-YA912x-BE.step, SOD-123W.step, Transformer_Wuerth_750315371.step, URB_YMD-6WR3.step]
2020-11-13 Change to mounting hole.
2020-11-16 Added STEP and WRL files for L_0805_2012Metric.
    [L_0805_2012Metric.step]
2020-11-16 Updated footprint for the SOT-89 footprint to show on Fab layer. Updated INDCAF864P1638X1422X889-4N to show on Fab layer. Added L_0805_2012Metric.kicad_mod PCB footprint. Added TP_PAD_SMT_5020.kicad_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
2020-12-24 Added schematick symbol for 74LVC2G17 buffer. Added 3D model for Wurth 7345 size inductor. Added 3D model for CUI PQME1 step file. Added PCV footprints for SO-323, Wurth 7345, CUI PQME1, 2 test-point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
    [CUI_PQME1-S5-S5-M.step, Wurth_7345.step]
2021-01-07 Added schematic symbols for 74LVC2G17 schmitt trigger buffer, and LM66100. Added 3D models for Murata 1255AY indcutor. Added PCB footprint and 3D model for Samtec TSM-103-01-T-SV header.
    [Murata_1255AY.step, SAMTEC_TSM-103-01-T-SV.step]
2021-02-10 Misc. parts updates and additionas.
    [BM06B-SRSS-TB.step, CAP_8X10MM_SMT.step, CL_series_size8x10.step, CP_Elec_10x10.step, CP_Elec_6.3x7.7.step, CP_Elec_8x10.5.step, HEADER_M_1.27MM_2R10P_ST_AU_SMT.step, JST_BM06B-SRSS-TB.step]
2021-02-23 Changes: Schematic library - added LED_Small_21, added TE_IM_RLY_2; added symbol, footprint, and 3D model for PJ-037H barrel connector. Added multiple RPI headers, stand-offs, and misc. Added 3D mode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
    [205-S_Clamp.step, 4-40_0.625in_standoff_mate_w_4882.step, 4-40_0.75in_standoff_mate_w_4882.step, 74984104400_pogo_pins.step, CUI_P7805-2000-S.step, CUI_PJ-037AH.step, HEADER_M_2.54MM_1R3P_pogo_pins.step, RPI3_Standoffs_11mm.step]
2021-03-02 Added 3D models for several mechanical components including 2-56 standoffs, 4-40 flat head screwws, the REM test fixture base plate, and the GSS-2-3.8 pogo pins.
    [2-56_0.125OD_0.500L_round_standoff.step, 2-56_0.125OD_0.875L_round_standoff.step, 4-40_flat-head_100_deg_0.375.STEP, GSS-2-3.8-G.step, REM_Test_Fixture_Baseplate_v01.step]
2021-03-05 Updated REM 3.7mm mounting hole footprint. Added SLOGO to log library. Added JLCPCB UL marks to logo library. Added REM test fixture left and right plate step files.
    [REM_Test_Fixture_Left_Plate_v01.step, REM_Test_Fixture_Right_Plate_v01.step]
2021-08-24 Misc. updates
    [CUI_V78E05-1000-SMT-TR.step, LTM8074IY_PBF.step, LT_BGA77.step, RES_SMF5_TYCO_TYC.step]
2021-10-04 Added valve (tube) and transformer schematic components.
2021-10-23 Misc updates.
    [WQFN-32-1EP_5x5mm_P0.5mm_EP3.1x3.1mm.step]
2022-01-19 Added 3D model for DM556 stepper driver; added 3D model for Teensy 4.1; added 3D model for Keystone 4892 stand-off; added PCB footprint for DM556 stepper driver; added PCB footprint for Teensy 4.1; a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
    [Keystone_4892.STEP, LeadShine_DM556.step]
2022-10-14 Updates for OG components
    [Harwin_M20-7812045.step, JST_SM02B_SURS_TF.step, Molex_0781710002.step, Molex_2053380004.step, Molex_2053380006.step, PSON50P200X300X60-9N.step, S2B-PH-SM4_white.step, SFH_4770S.step]
2023-03-19 Arduino Nano and PCI header for CNC stuff.
    [Arduino_Nano_Headers.step]
2023-03-19 Added TPS92360 footprint. Added Coilcraft LPS4018 inductor.
    [Coilcraft-LPS4018.step]
2023-07-31 Added schematic symbols for SOT-23 zener diode, SN74LVC1G08DCKR, 2-resistor isolated network; added footprint and 3d model for 2x0606 2 resistor network array.
    [RES_Network_2x0606.step]
2023-08-01 Added symbols for PCT2075GVX and PCT2075DP to schematic library. Added 3d model for 8-MSOP package. Updated MSOP-8 footprint to use 8-MSOP step file.
    [8-MSOP.step]
2023-08-02 Harwin M207812045 footprint updated ti increase hole diameter for all 40 thru-hole pins. MountingHole_M2 footprint updated to resolve clearance issue. MountingHole_SMD_7.4_3.7 footprint updated to re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
2023-08-09 Changed schematic symbol for VL53L4CDV0DH_1. (locations of pins 1 and 2 swaped)
2023-08-31 ATtiny45-20XU-Atmel_ATtiny added to Schematic/Active.lib; GND added to Schematic/Power_Symbols.lib.
2025-10-23 Added valves
2026-10-30 Added several new schematic decals, PCB footprints, and 3D models.
